lucasmoraeseng/STM3205P/README.md

# STM3205P
New controller for KORAD/HIkari 3205P power supply
