lucasmoraeseng/STM3205P/2.Hardware/STM3205P/PO/Gerber Single/STM3205P_GS_1.1_2026-04-08/STM3205P_PCB.xls

Board Stack Report
Stack Up |  | Layer Stack
Layer | Board Layer Stack | Name | Material | Thickness | Constant
1 |  | Top Paste
2 |  | Top Overlay
3 |  | Top Solder | SM-001 | 0,025mm | 4
4 |  | Top Layer | Copper | 0,035mm
5 |  | Dielectric 1 | PP-021 | 0,196mm | 4,74
6 |  | Int1 (GND) | Copper | 0,035mm
7 |  | Dielectric 3 | Core-039 | 1,030mm | 4,6
8 |  | Int2 (GND) | Copper | 0,035mm
9 |  | Dielectric 5 | PP-021 | 0,196mm | 4,74
10 |  | Bottom Layer | Copper | 0,035mm
11 |  | Bottom Solder | SM-001 | 0,025mm | 4
12 |  | Bottom Overlay
13 |  | Bottom Paste
 | Height : 1,613mm
