lucasmoraeseng/STM3205P/2.Hardware/STM3205P/PO/BOM/STM3205P_1.1_Main_2025-10-26.xlsx

Comment | Description | Designator | Footprint | LibRef | Quantity | Power | Pins | Tolerance | Value | Voltage | SEWPartNumber | PartNumber1 | Manufacturer1
CC0603 | Surface Mount Multilayer Ceramic Chip Capacitors for Commercial Applications | C1, C2, C3, C4, C5, C6, C7, C8, C9, C10, C11, C12, C13, C14, C15, C16, C17, C18, C19, C20, C21, C22, C23, C24, C25, C27, C28, C29, C30, C31, C32 | CAP0603 | CC0603 | 31 |  | 2 | 20% | 100nF, 10nF, 10uF | 50V, 100V |  | EMPTY | Yageo
25V 470uF | Electrolytic Capacitor PTH | CE1, CE3 | 5.0-10.0-12.5 | 25V 470uF | 2 |  | 2 | 20% | 470uF | 25V |  | UVK1E471MPD | Nichicon
16V 100uF | Electrolytic Capacitor PTH | CE2, CE4 | 2.0-5.0-11.0 | 16V 100uF | 2 |  | 2 | 20% | 100uF | 16V |  | UVZ1C101MDD | Nichicon
FM4007 | General Purpose Plastic Rectifier | D1, D2, D3, D4 | DO-214AC | FM4007 | 4 |  | 2 |  |  |  |  | FM4007 | Rectron
1N5408 | Rectifiers Diode, 1000V, 3A | D5 | DO-201AD | 1N5408 | 1 |  | 2 |  |  |  |  | 1N5408 | Diotec Semiconductor
BZV55-C5V1 | Zener Diodes 5.1V 0.5W | D6 | SOD-80C | BZV55-C5V1 | 1 | 0.5W | 2 |  | 5.1V |  |  | BZV55-C5V1 | Nexperia
MM4148 | General Purpose Plastic Rectifier | D7, D8 | SOD-80C | MM4148 | 2 |  | 2 |  |  |  |  | MM4148
B3B-XH-2 | XH Connector 3 POS HDR VERT 2.5mm | J1 | CONXH03STRMALE_2.5 | B3B-XH-2 | 1 |  | 3 |  |  |  |  | B3B-XH-2 | JST
B4B-XH-2 | XH Connector 4 POS HDR VERT 2.5mm | J2 | CONXH04STRMALE_2.5 | B4B-XH-2 | 1 |  | 4 |  |  |  |  | B4B-XH-2 | JST
90151-2110 | Headers & Wire Housings C-Grid PCB Conn Dual Row Vertical 10Ckt | J3 | CONDIL10STRFEMALE_100_100 | 90151-2110 | 1 |  | 10 |  |  |  |  | 90151-2110 | Molex
10-89-7121 | Headers & Wire Housings C-Grid PCB Conn SR V onn SR Vt Tn-A 12Ckt | J4 | CONDIL12STRMALE_100_100 | 10-89-7121 | 1 |  | 12 |  |  |  |  | 10-89-7121 | Molex
10-89-7062 | Headers & Wire Housings C-Grid PCB Conn SR V onn SR Vt Tn-A 8Ckt | J5 | CONDIL06STRMALE_100_100 | 10-89-7062 | 1 |  | 6 |  |  |  |  | 10-89-7062 | Molex
22-28-4043 | Headers & Wire Housings 04 MODII HDR SRST B/A .100CL | J6 | CONSIL04STRMALE_100_100 | 22-28-4043 | 1 |  | 4 |  |  |  |  | 22-28-4043 | Molex
B2B-XH-2 | XH Connector 2 POS HDR VERT 2.5mm | J7, J11 | CONXH02STRMALE_2.5 | B2B-XH-2 | 2 |  | 2 |  |  |  |  | B2B-XH-2 | JST
1-1123723-2 | Header Vert 3.96mm 2Pos | J8, J9 | CONKK02STRMALE_156 | 1-1123723-2 | 2 |  | 2 |  |  |  |  | 1-1123723-2 | TE Connectivity
B7B-XH-2 | XH Connector 7 POS HDR VERT 2.5mm | J10 | CONXH07STRMALE_2.5 | B7B-XH-2 | 1 |  | 7 |  |  |  |  | B7B-XH-2 | JST
BLM18 | Ferrite Beads 0603 | L1, L2, L3 | IND0603 | BLM18 | 3 |  | 2 | 25% | 220 Ohm |  |  | BLM18PG(VVV)SN1D | Murata Electronics
BC846B | Transistor BJT NPN 65V 0.1A 150mW | Q1, Q2 | SOT-23 | BC846B | 2 | 150mW | 3 |  |  |  |  | BC846BLT3G | onsemi
Chip Resistor | Thick Film Chip Resistors with CECC Approval, available with Established Reliability | R1, R2, R3, R4, R5, R6, R7, R8, R9, R10, R11, R12, R13, R14, R16, R17, R18, R19, R20, R21, R22, R23, R24, R25, R26, R27, R28, R29, R30 | RES0603 | CRCW0603 | 29 | 0.1W | 2 | 5% | 10k, 100k, 1M, 4.3k, 2k, 4.7k, 100R, 20k |  |  | CRCW0603(RRRR)(T)(C)(PP)(SS) | Vishay
Chip Resistor | Thick Film Chip Resistors with CECC Approval, available with Established Reliability | R15 | RESSHUNT | RESSHUNT | 1 | 5W | 2 | 5% | 0.1R
L7812CV | Positive voltage regulator ICs | U1 | TO-220A | L7812CV | 1 |  | 3 |  |  | 12V |  | L7812CV | STMicroelectronics
L79L12ACZ-TR | Negative voltage regulator ICs | U2 | TO-92A_2.5 | L79L12ACZ-TR | 1 |  | 3 |  |  | -12V |  | L79L12ACZ-TR | STMicroelectronics
L7805CV | Positive voltage regulator ICs | U3 | TO-220A | L7805CV | 1 |  | 3 |  |  | 5V |  | L7805CV | STMicroelectronics
LD1117S33TR | Positive voltage regulator ICs | U4 | SOT-223 | LD1117S33TR | 1 |  | 4 |  |  | 3.3V |  | LD1117S33TR | STMicroelectronics
STM32F103C8T6 | 32-bit Microcontrollers - ARM Cortex-M0+ 32kB Flash, 6kB RAM | U5 | LQFP-48 | STM32F103C8T6 | 1 |  | 48 |  |  |  |  | STM32F103C8T6 | STMicroelectronics
DAC8830ICD | DAC Lo-Pwr R-To-R Output 16-Bit Serial Input | U6, U7 | SOIC-08-3.9mm | DAC8830ICD | 2 |  | 8 |  |  |  |  | DAC8830IBD | Texas Instruments
TL084HIDR | Quad Operational Amplifiers RRIO | U8 | SOIC-14-3.9mm | TL084HIDR | 1 |  | 14 |  |  |  |  | TL084HIDR | Texas Instruments
ULN2003ADR | Darlington Transistors Arrays NPN 7-Ch | U10 | SOIC-16-3.9mm | ULN2003ADR | 1 |  | 16 |  |  |  |  | ULN2003ADR | Texas Instruments
FA-238A | Crystals FA-238A XTAL MHZ -40 125C 7.0PF 250TR | X1 | CR3225 | FA-238A | 1 |  | 4 | 20 ppm | 16 MHz |  |  | FA-238A | Epson Timing
CEM-1203(42) | 12 mm, 3.5 Vo-p, 95 dB, Through Hole, Magnetic Audio Transducer Buzzer | X2 | CEM-1203 | CEM-1203(42) | 1 |  | 2 |  | 3.5V |  |  | CEM-1203(42) | Same Sky
