lucasmoraeseng/STM3205P/2.Hardware/STM3205P/PO/3DFile/STM3205P_3D_1.1_2025-10-26/STM3205P_PCB(Main).step

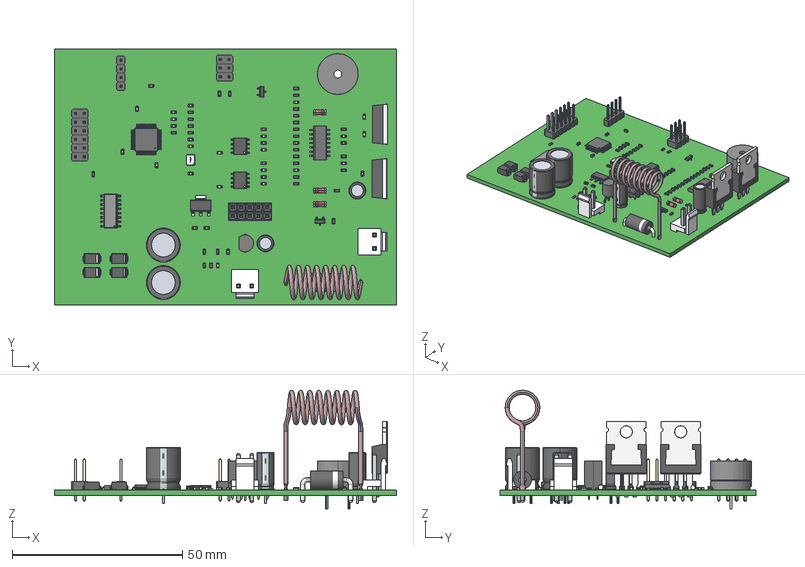
[picture p1: CAD file, 2025-10-26]
2.Hardware/STM3205P/PO/3DFile/STM3205P_3D_1.1_2025-10-26/STM3205P_PCB(Main).step
100.5 x 75.3 x 34.8 mm
C0603 x 31
Same_Sky_CEM-1203_42_
ATX-11
SO16_Narrow_3.9mm x 17
SOIC14_3.9
SO8N x 2
LQFP48
SOT233
TO-220_3pins_short_V1 x 2
TO-92_line_pin_2_5mm_pitch
RES0603 x 29
ResistorCoil
SOT23 x 2
Pin1 x 3
Pin2 x 3
CeramicBody x 3
Base_2 x 2
PinH x 4
PinL x 4
SingleBlockL x 4
DownPinL x 22
UpPinL x 22
DualBlockL x 9
ConnHS2_54_STR_Body_Standard x 10
ConnHS2_54_STR_Terminal x 10
DO-201AD
Diode_SMA x 4
Cap_2.0_5.0_11.0 x 2
Cap_5.0_10.0_12.5 x 2
