lucasmoraeseng/STM3205P/5.Mecanico/Resistor/ResistorCoil.STEP

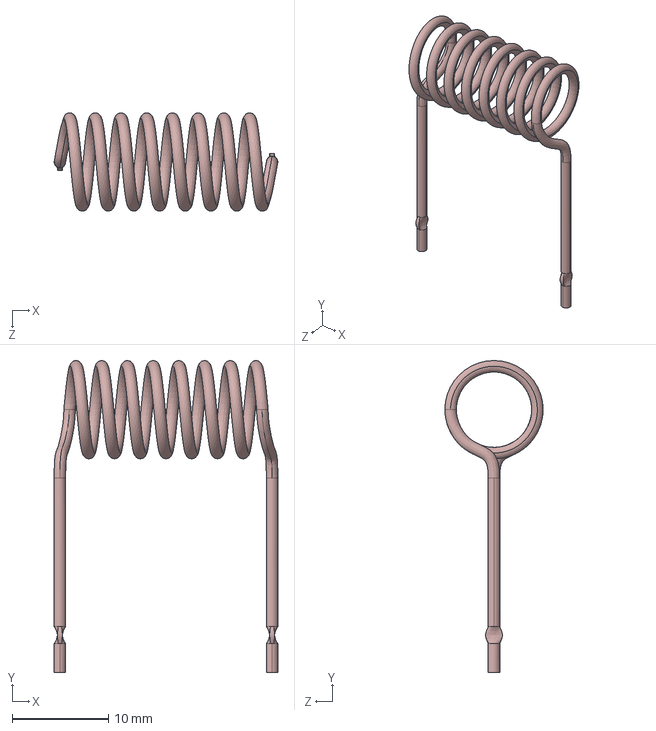
[picture p2: CAD file, 2025-08-31]
5.Mecanico/Resistor/ResistorCoil.STEP
23.2 x 32.3 x 10.2 mm
