lucasmoraeseng/STM3205P/(list of files, cad)

Other CAD files:
2.Hardware/STM3205P/PO/3DFile/STM3205P_3D_1.1_2025-10-26/STM3205P_PCB(Main).x_t
5.Mecanico/Resistor/ResistorCoil.SLDPRT
