lucasmoraeseng/STM3205P/2.Hardware/STM3205P/PO/SCH/STM3205P_SCH_1.1_Main_2025-10-26.PDF

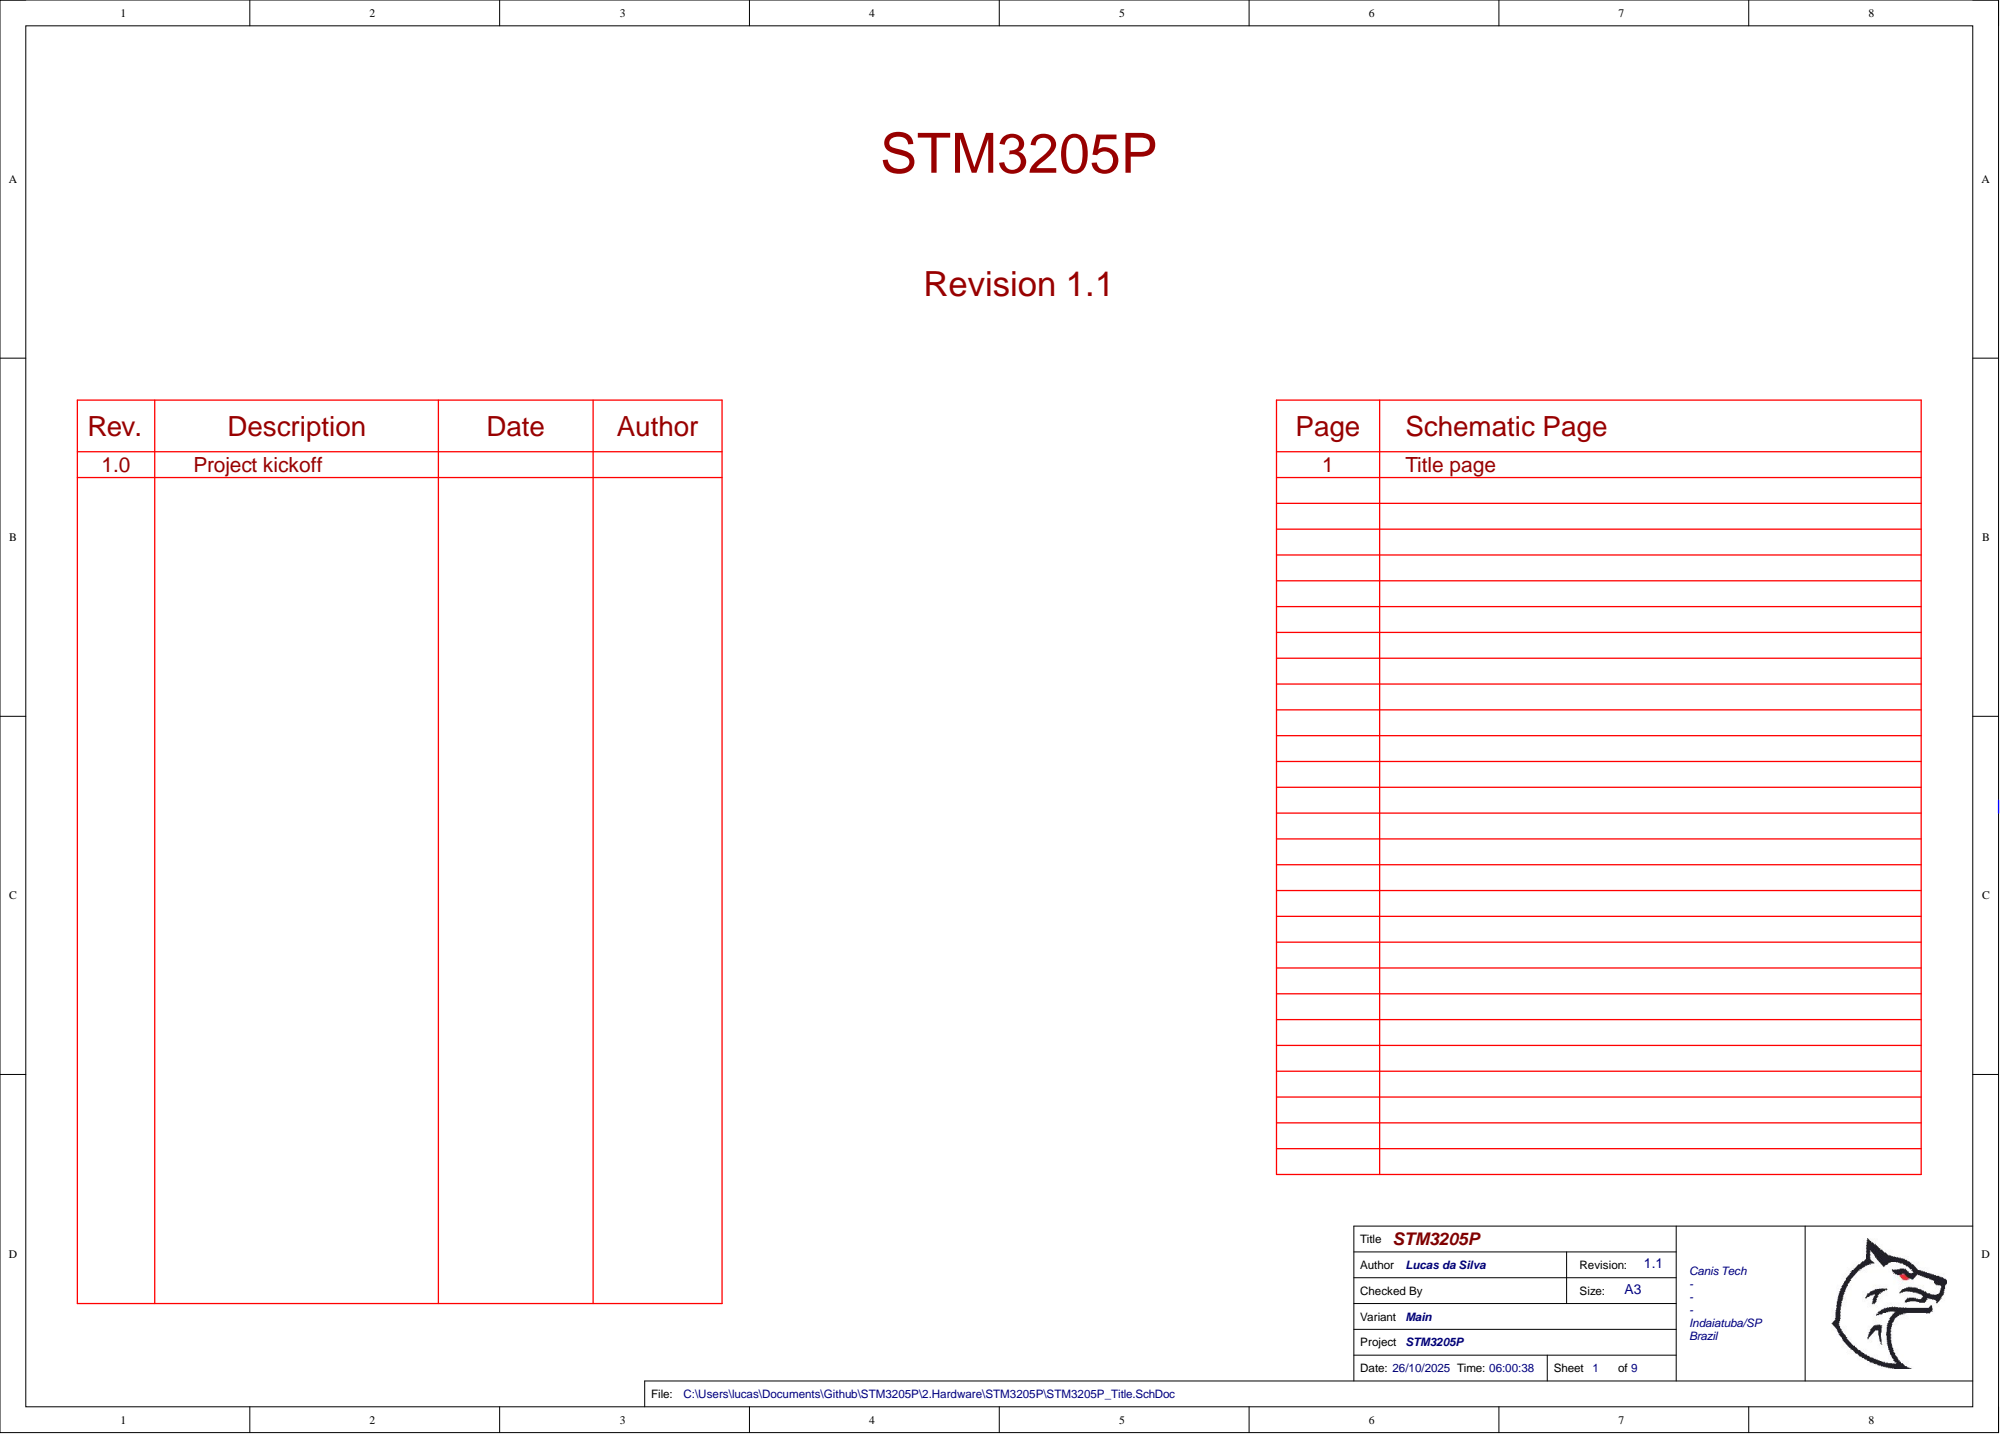
[picture p3: page 1]

Author Lucas da Silva | Revision: 1.1

Checked By | A3 Size:

File: C:\Users\lucas\Documents\Github\STM3205P\2.Hardware\STM3205P\STM3205P_Title.SchDoc

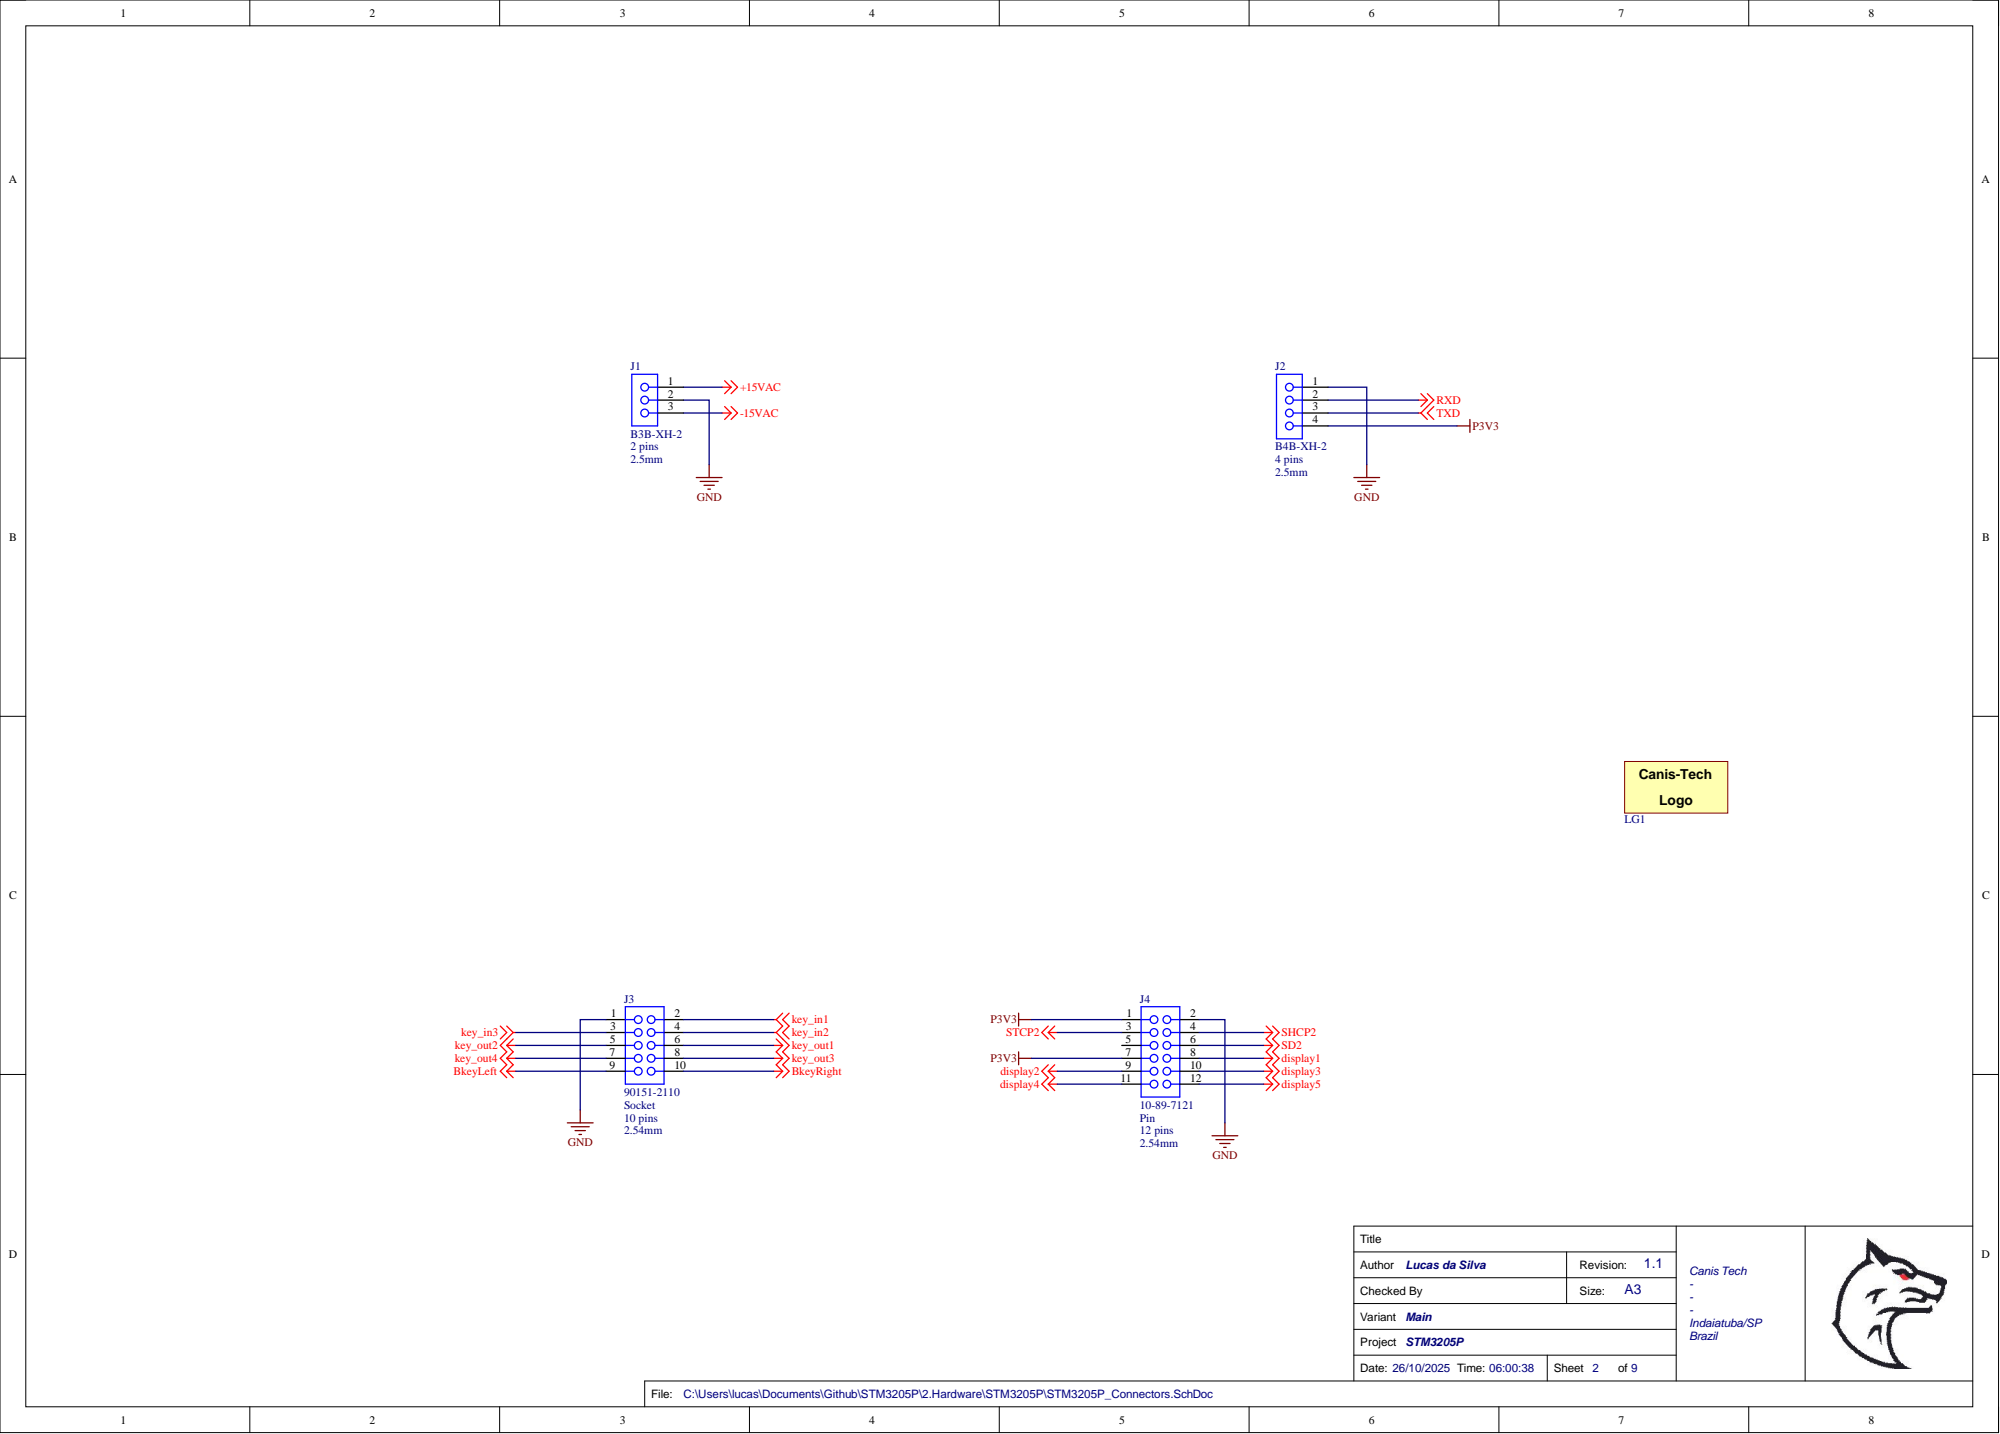
[picture p4: page 2]

Author Lucas da Silva | Revision: 1.1

Checked By | A3 Size:

File: C:\Users\lucas\Documents\Github\STM3205P\2.Hardware\STM3205P\STM3205P_Connectors.SchDoc

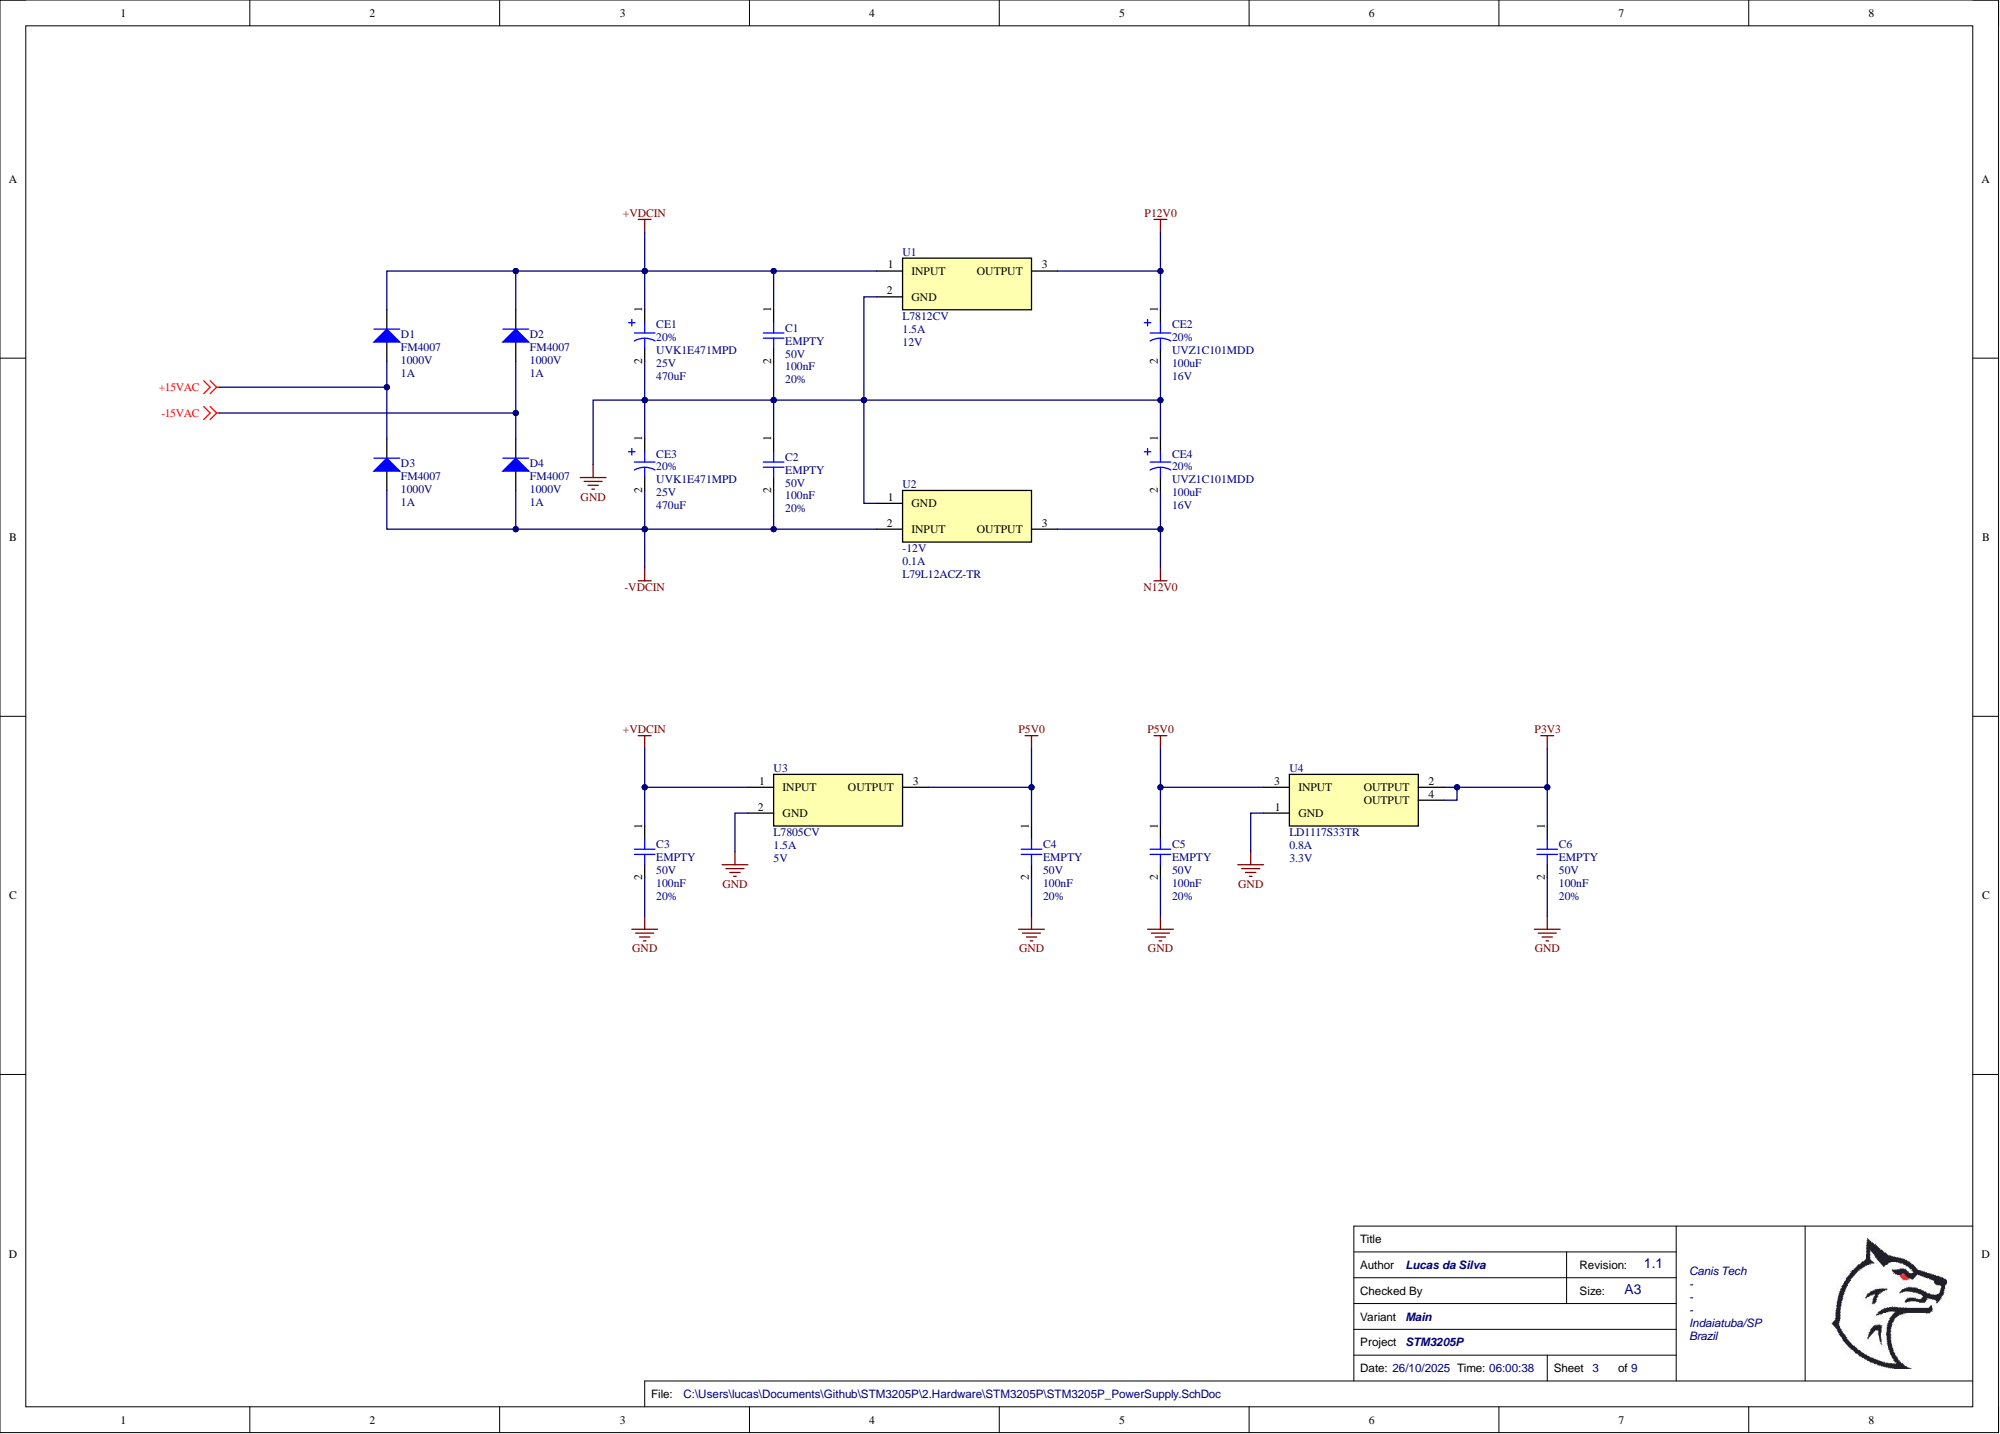
[picture p5: page 3]

Author Lucas da Silva | Revision: 1.1

Checked By | A3 Size:

File: C:\Users\lucas\Documents\Github\STM3205P\2.Hardware\STM3205P\STM3205P_PowerSupply.SchDoc

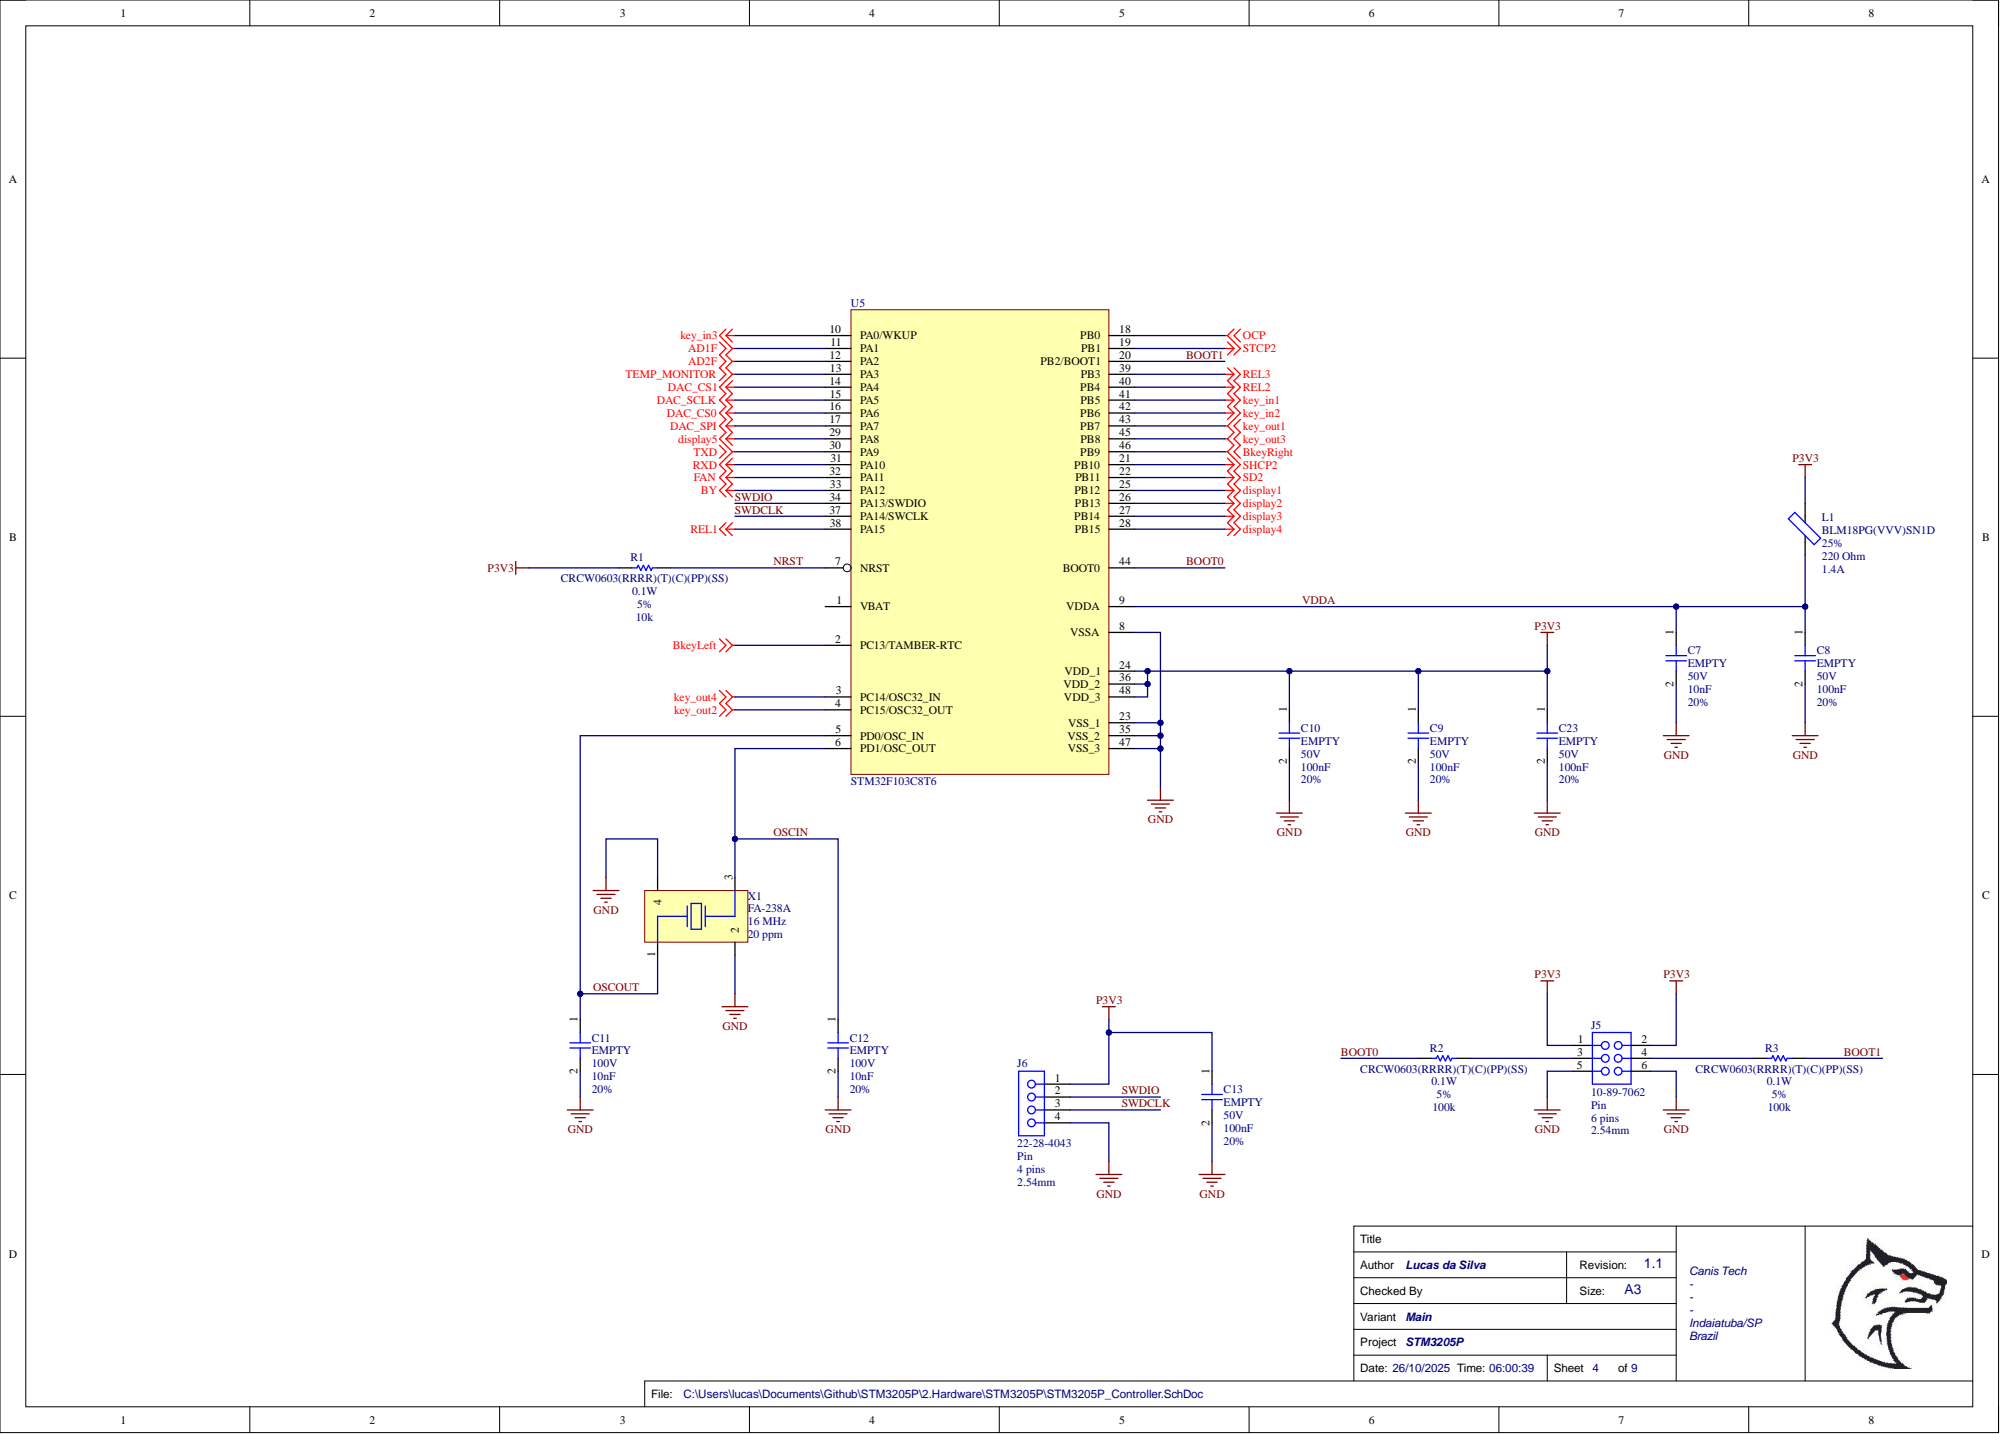
[picture p6: page 4]

Author Lucas da Silva | Revision: 1.1

Checked By | A3 Size:

File: C:\Users\lucas\Documents\Github\STM3205P\2.Hardware\STM3205P\STM3205P_Controller.SchDoc

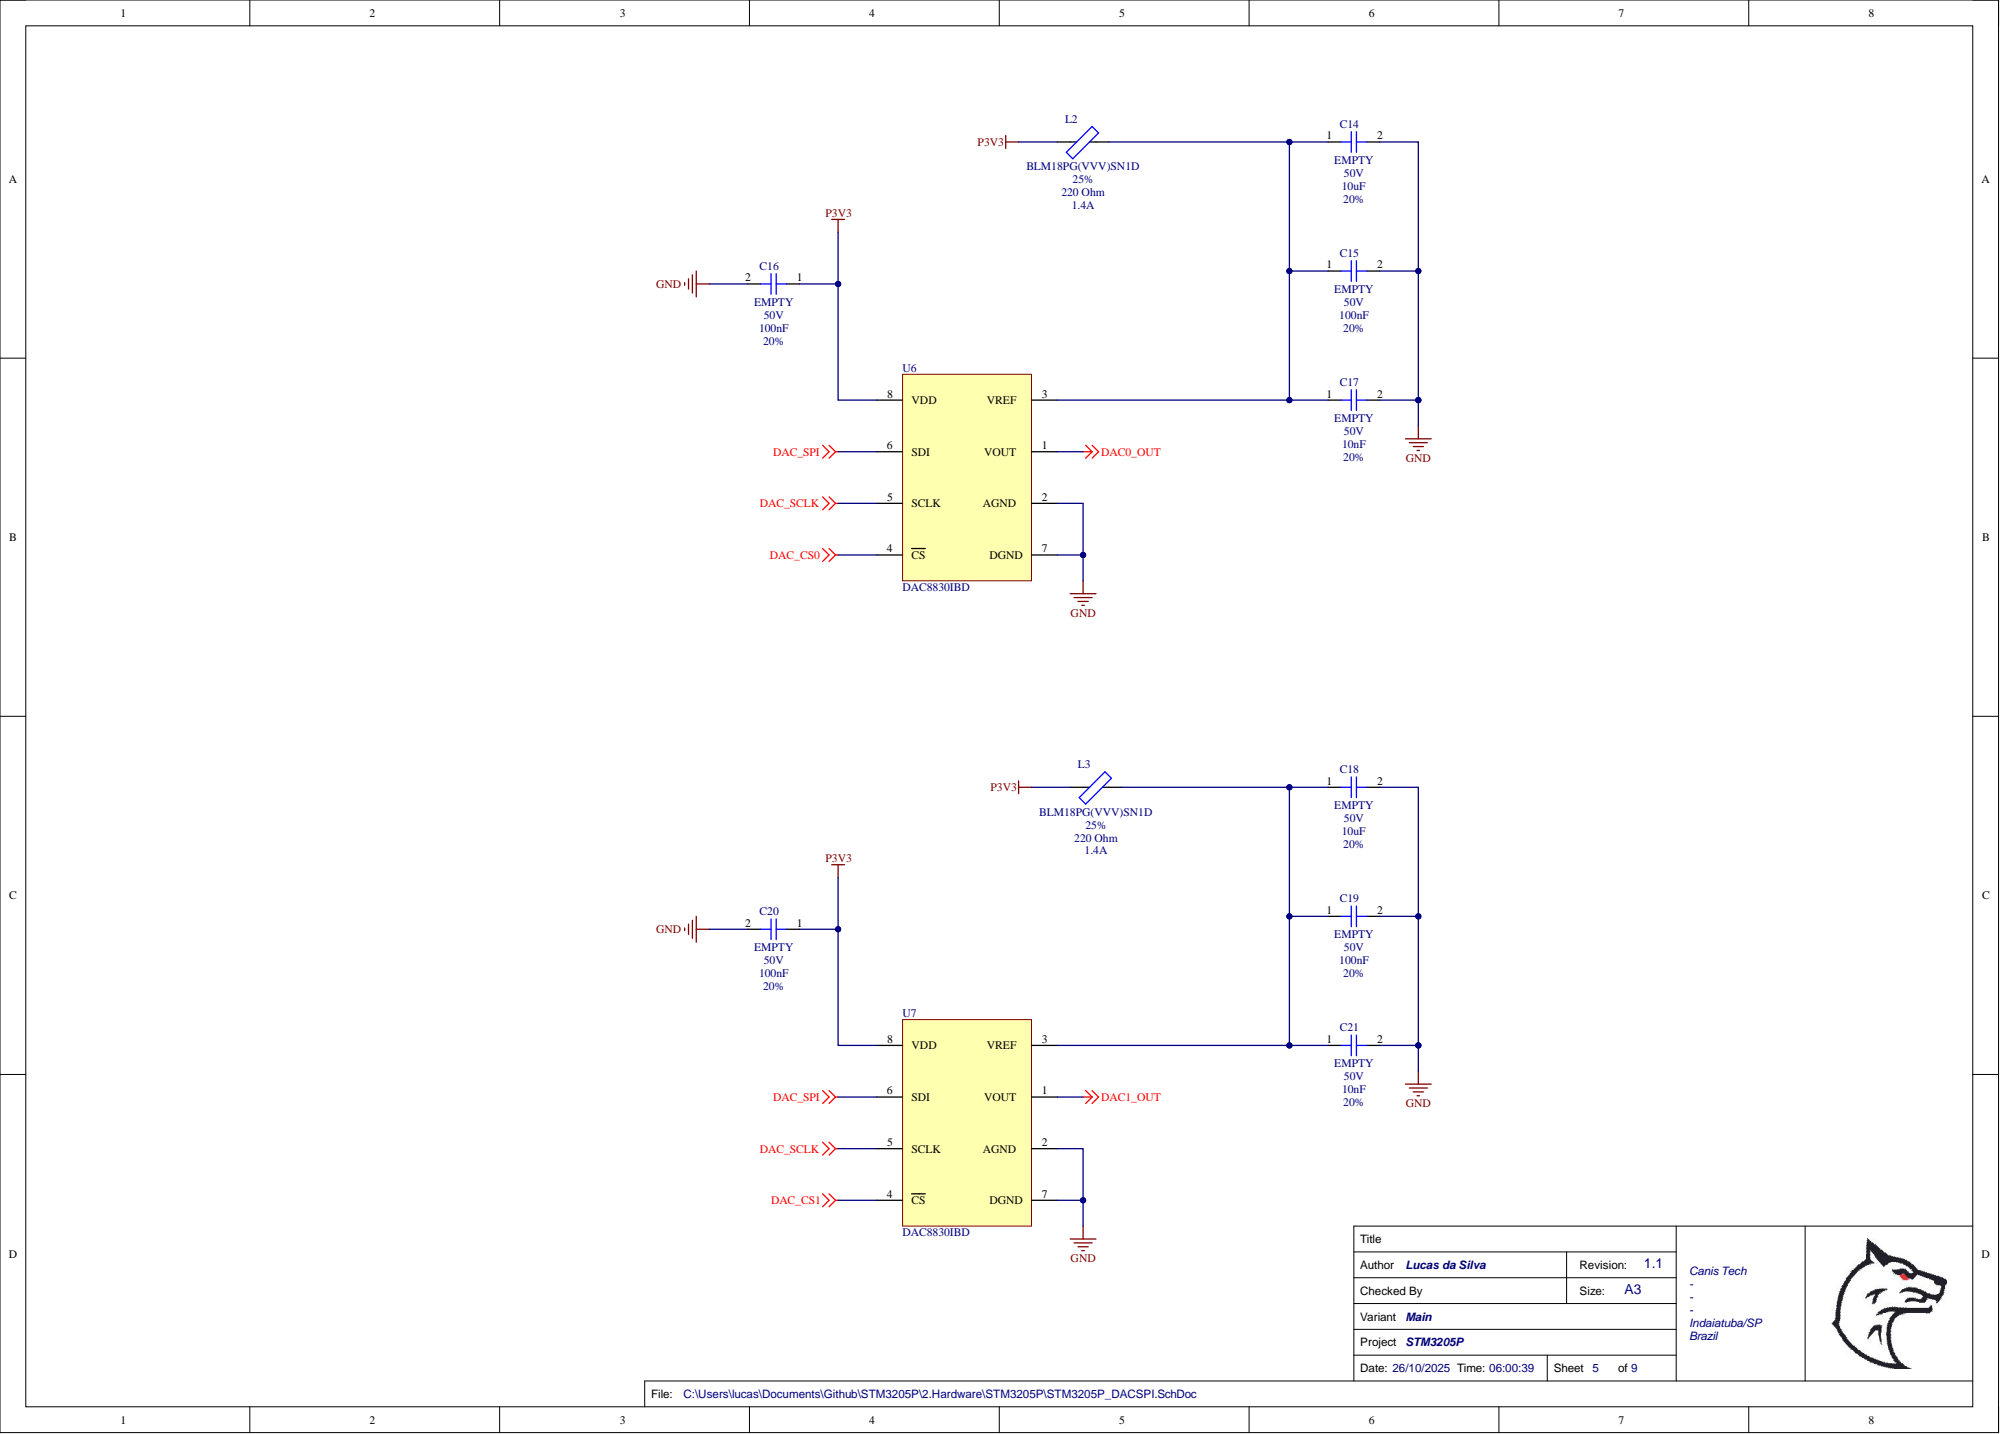
[picture p7: page 5]

Author Lucas da Silva | Revision: 1.1

Checked By | A3 Size:

File: C:\Users\lucas\Documents\Github\STM3205P\2.Hardware\STM3205P\STM3205P_DACSPI.SchDoc

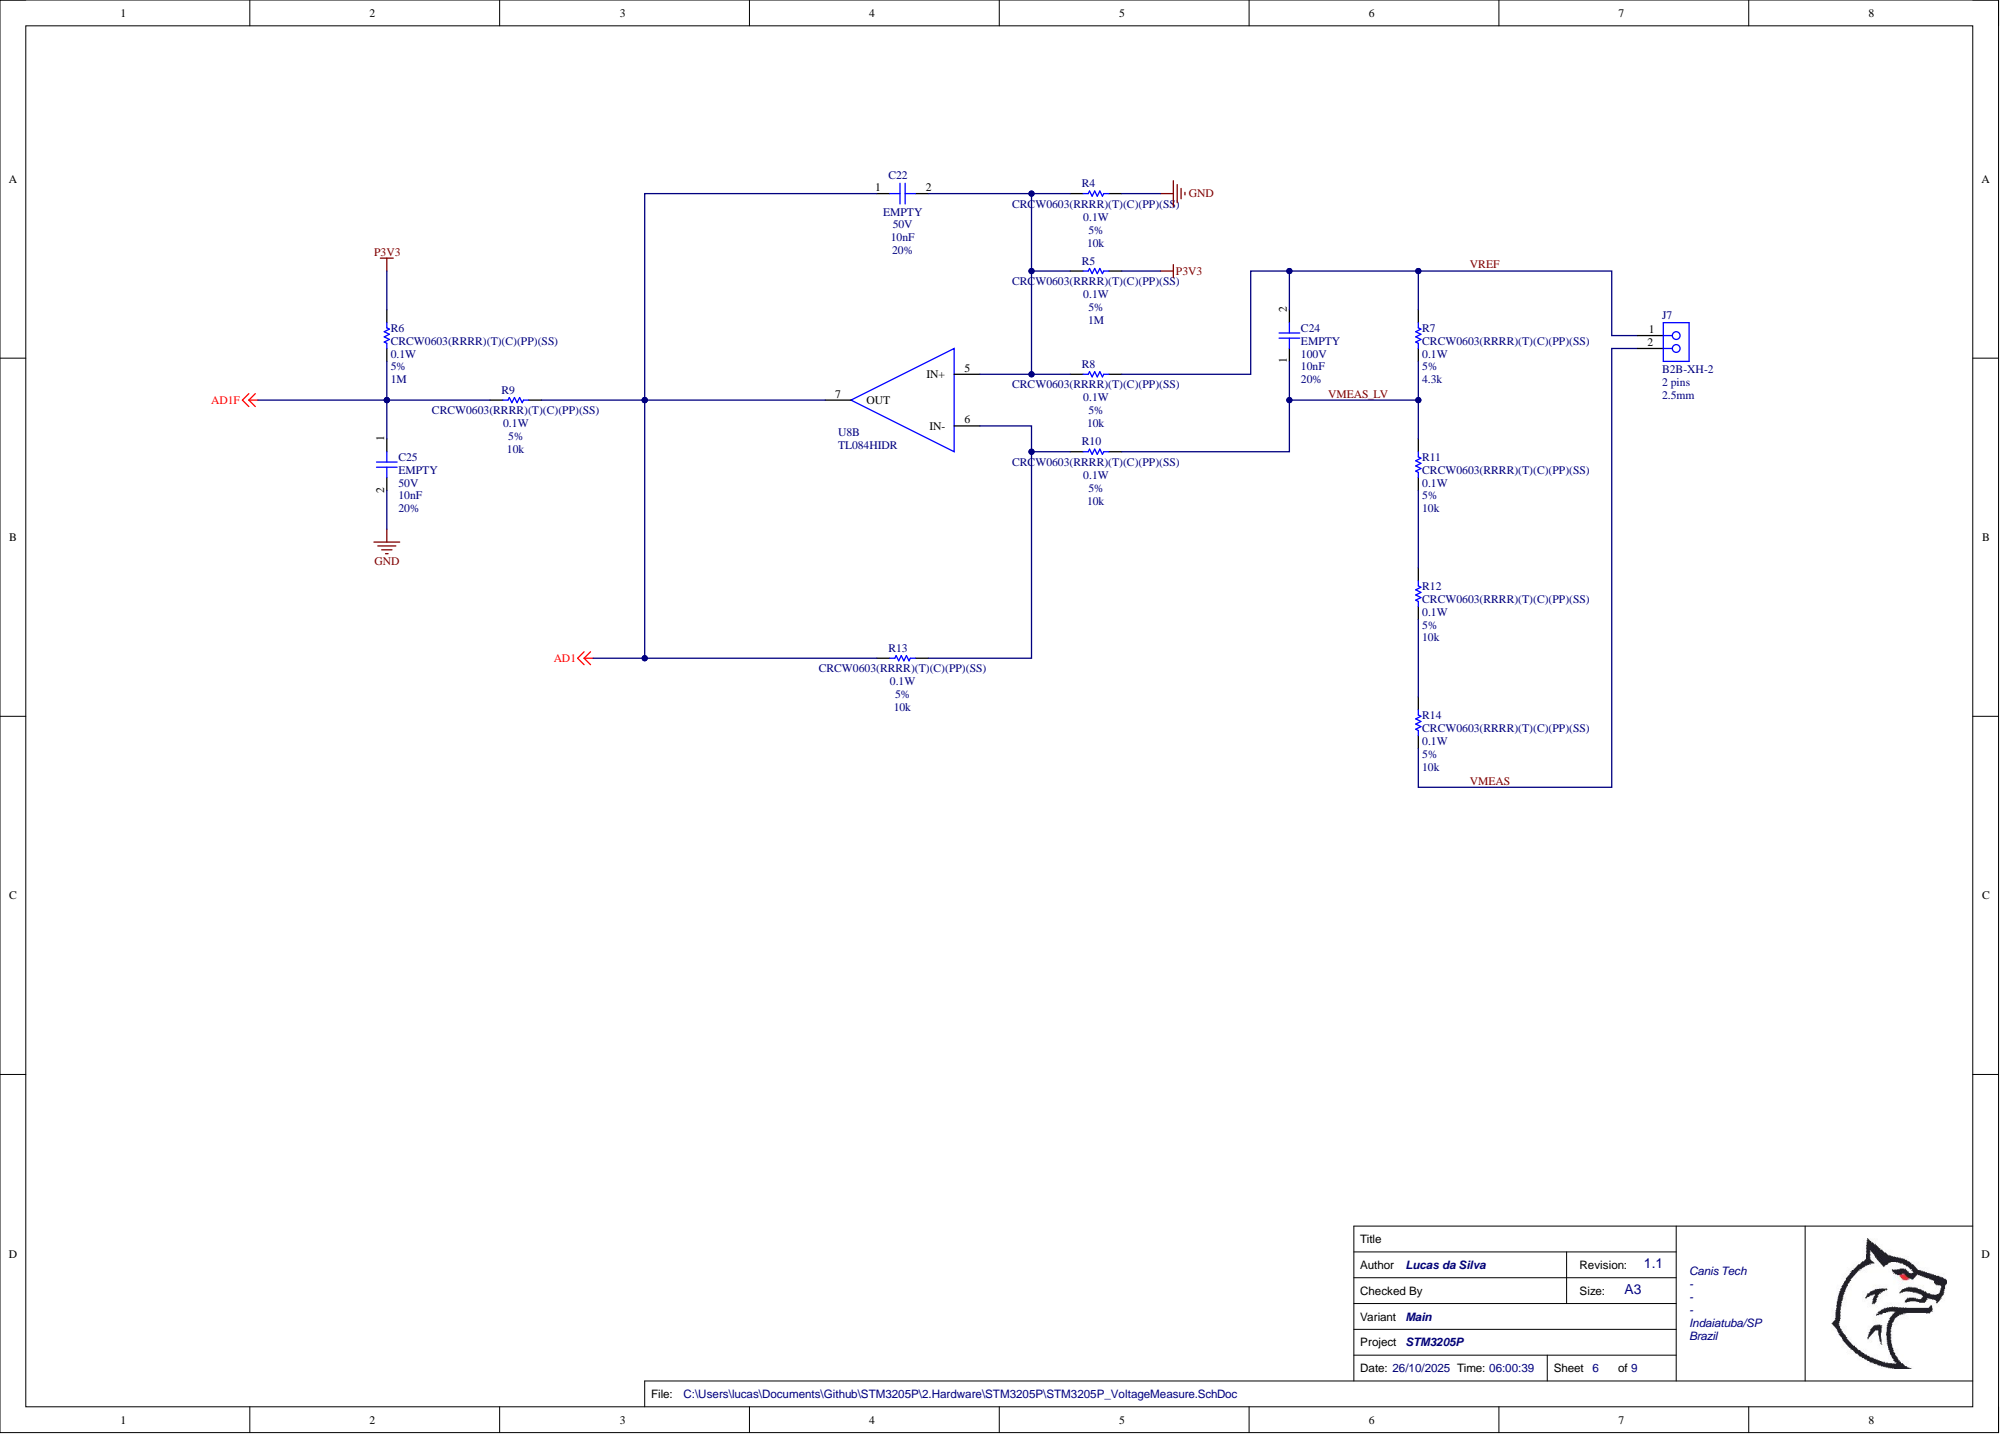
[picture p8: page 6]

Author Lucas da Silva | Revision: 1.1

Checked By | A3 Size:

File: C:\Users\lucas\Documents\Github\STM3205P\2.Hardware\STM3205P\STM3205P_VoltageMeasure.SchDoc

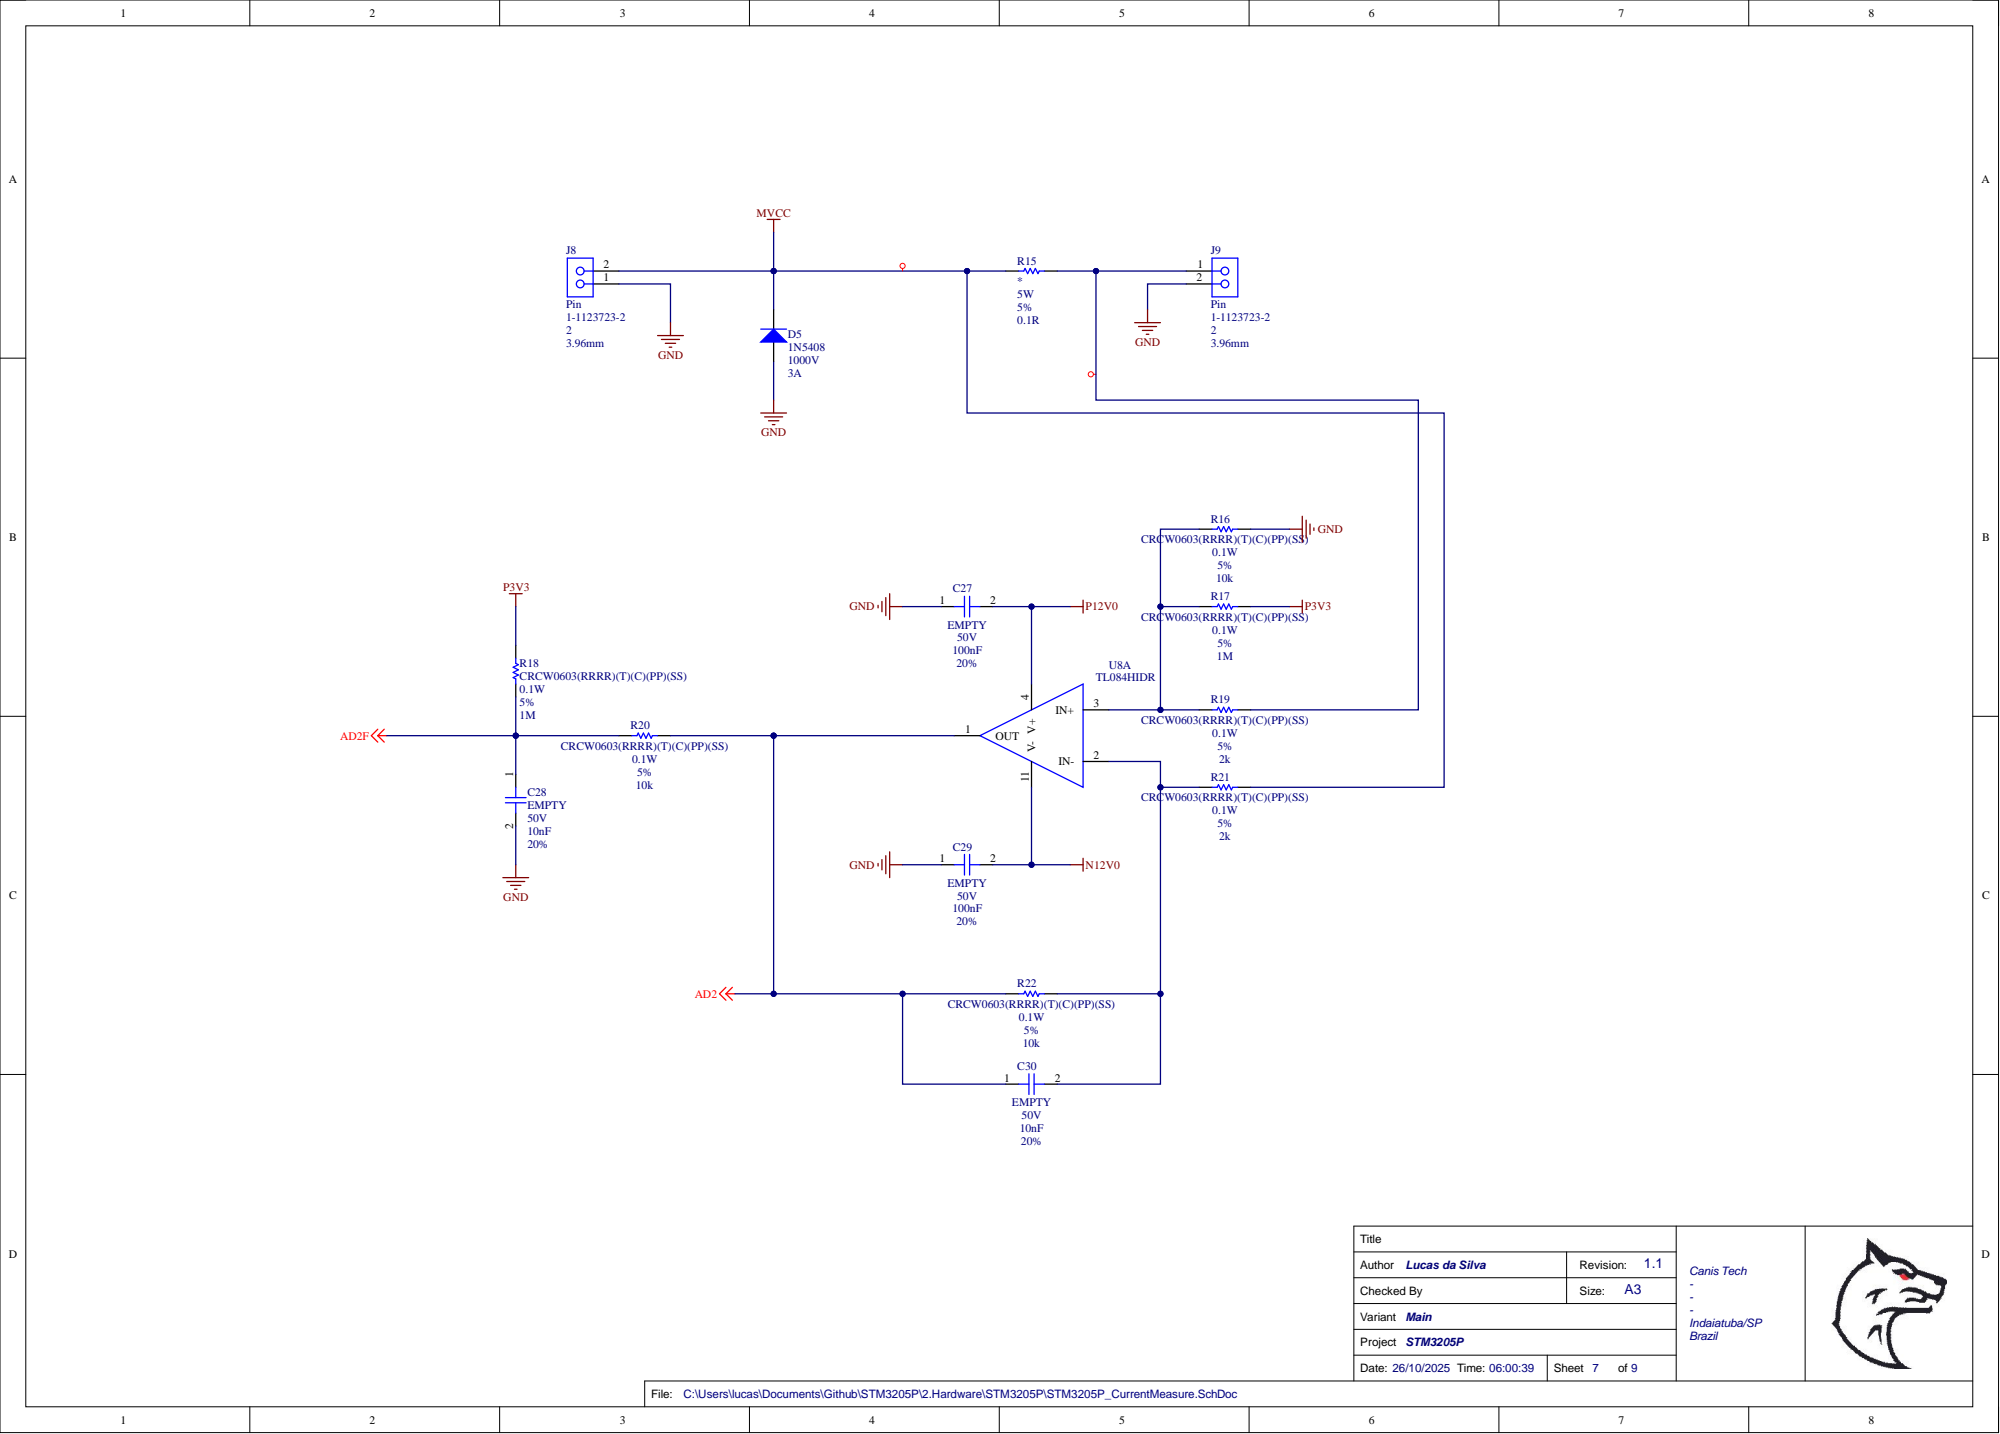
[picture p9: page 7]

Author Lucas da Silva | Revision: 1.1

Checked By | A3 Size:

File: C:\Users\lucas\Documents\Github\STM3205P\2.Hardware\STM3205P\STM3205P_CurrentMeasure.SchDoc

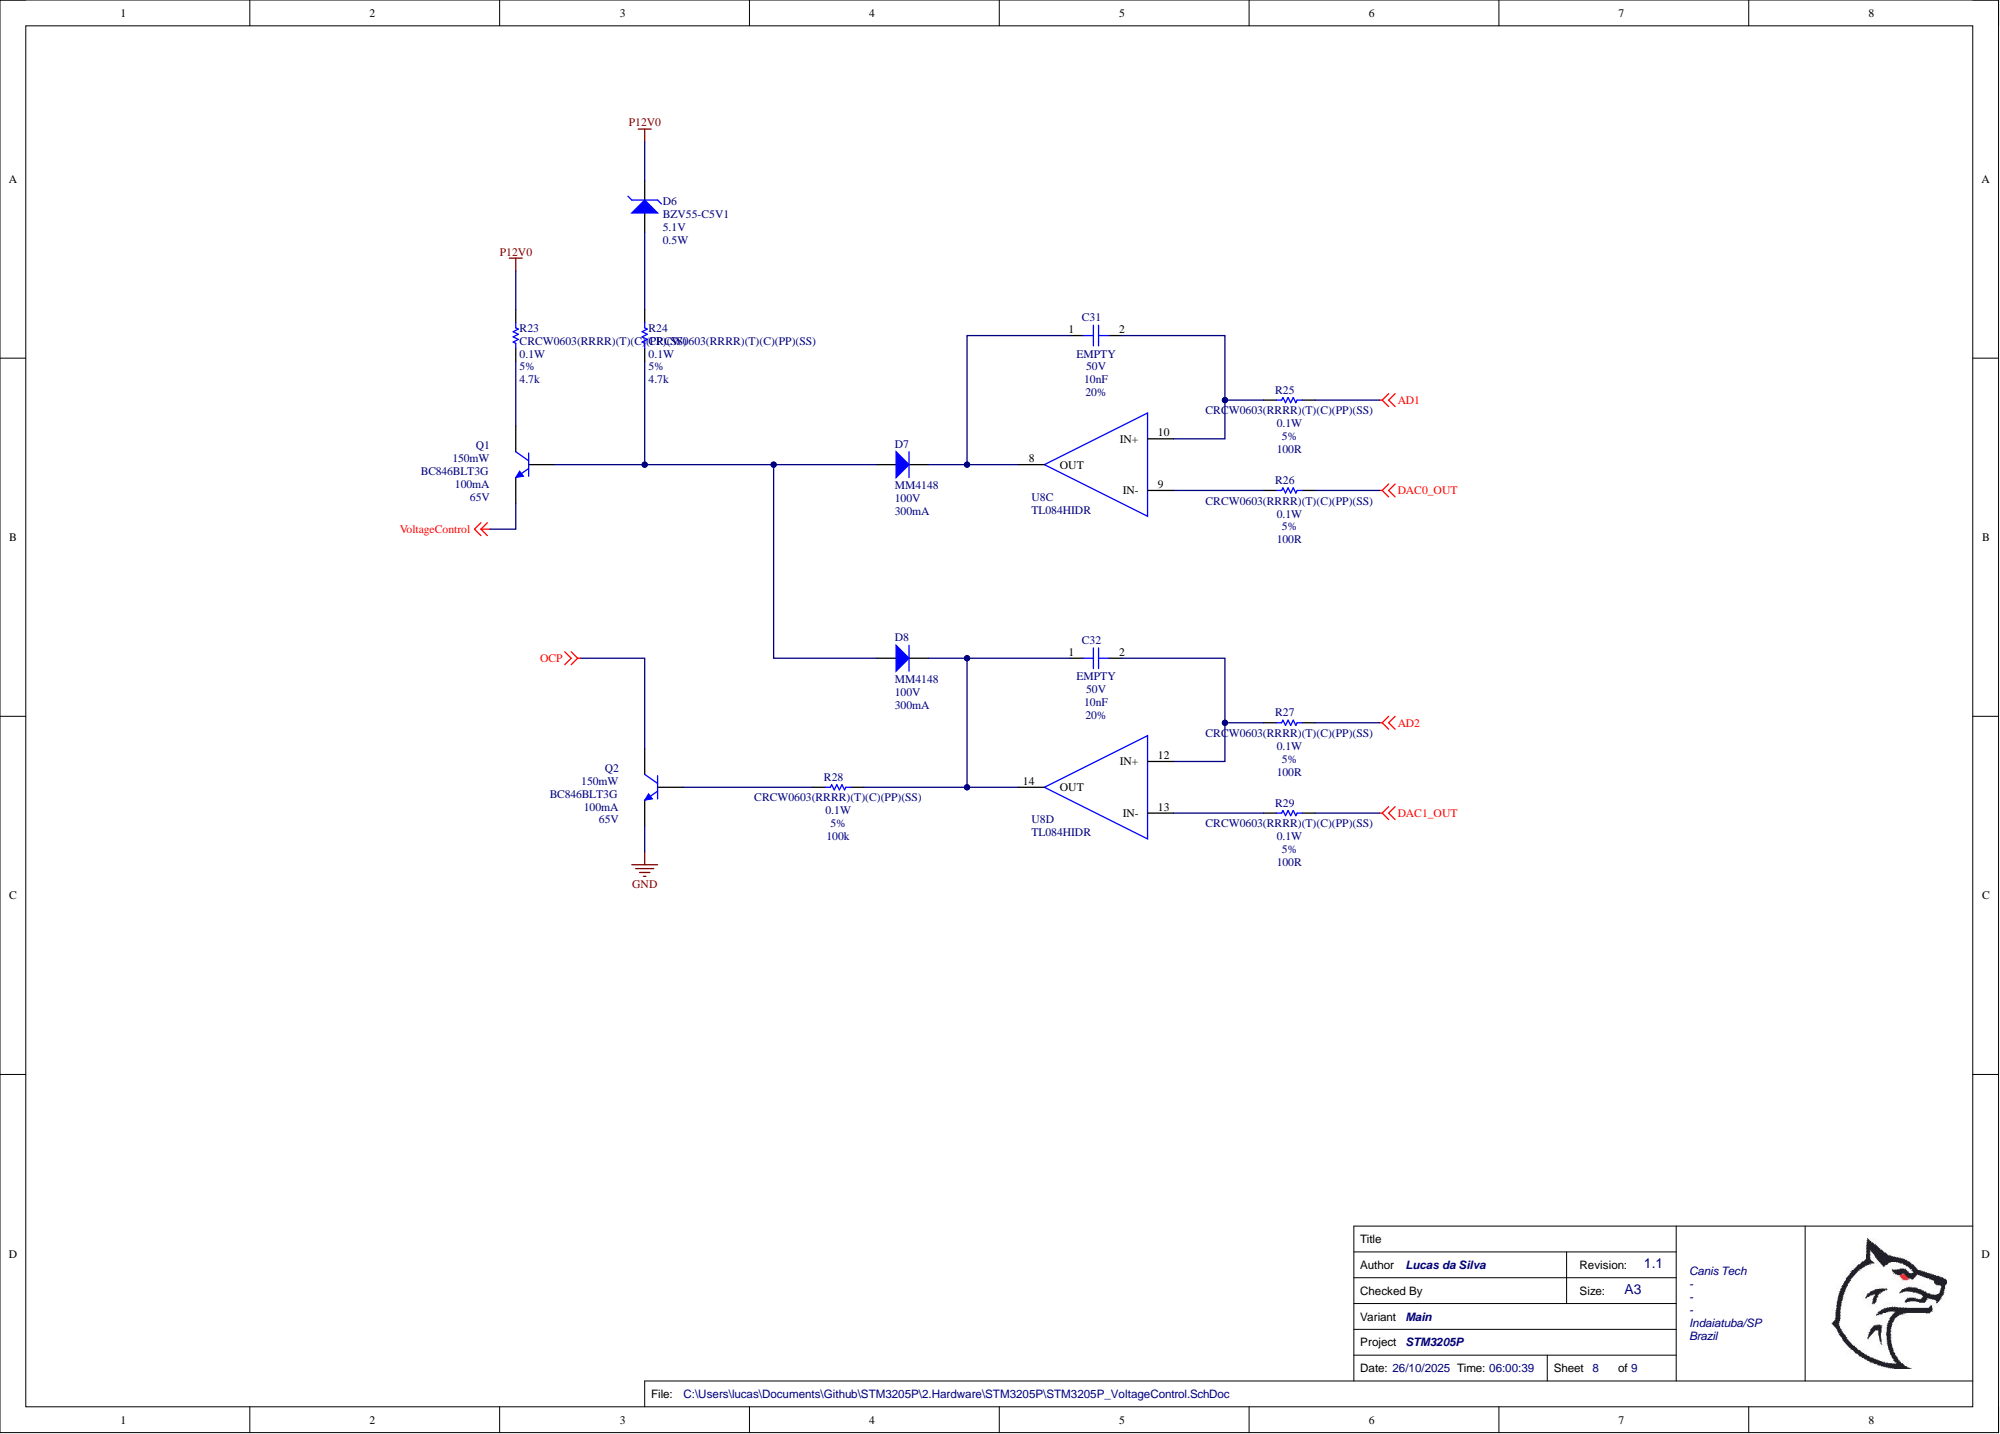
[picture p10: page 8]

Author Lucas da Silva | Revision: 1.1

Checked By | A3 Size:

File: C:\Users\lucas\Documents\Github\STM3205P\2.Hardware\STM3205P\STM3205P_VoltageControl.SchDoc

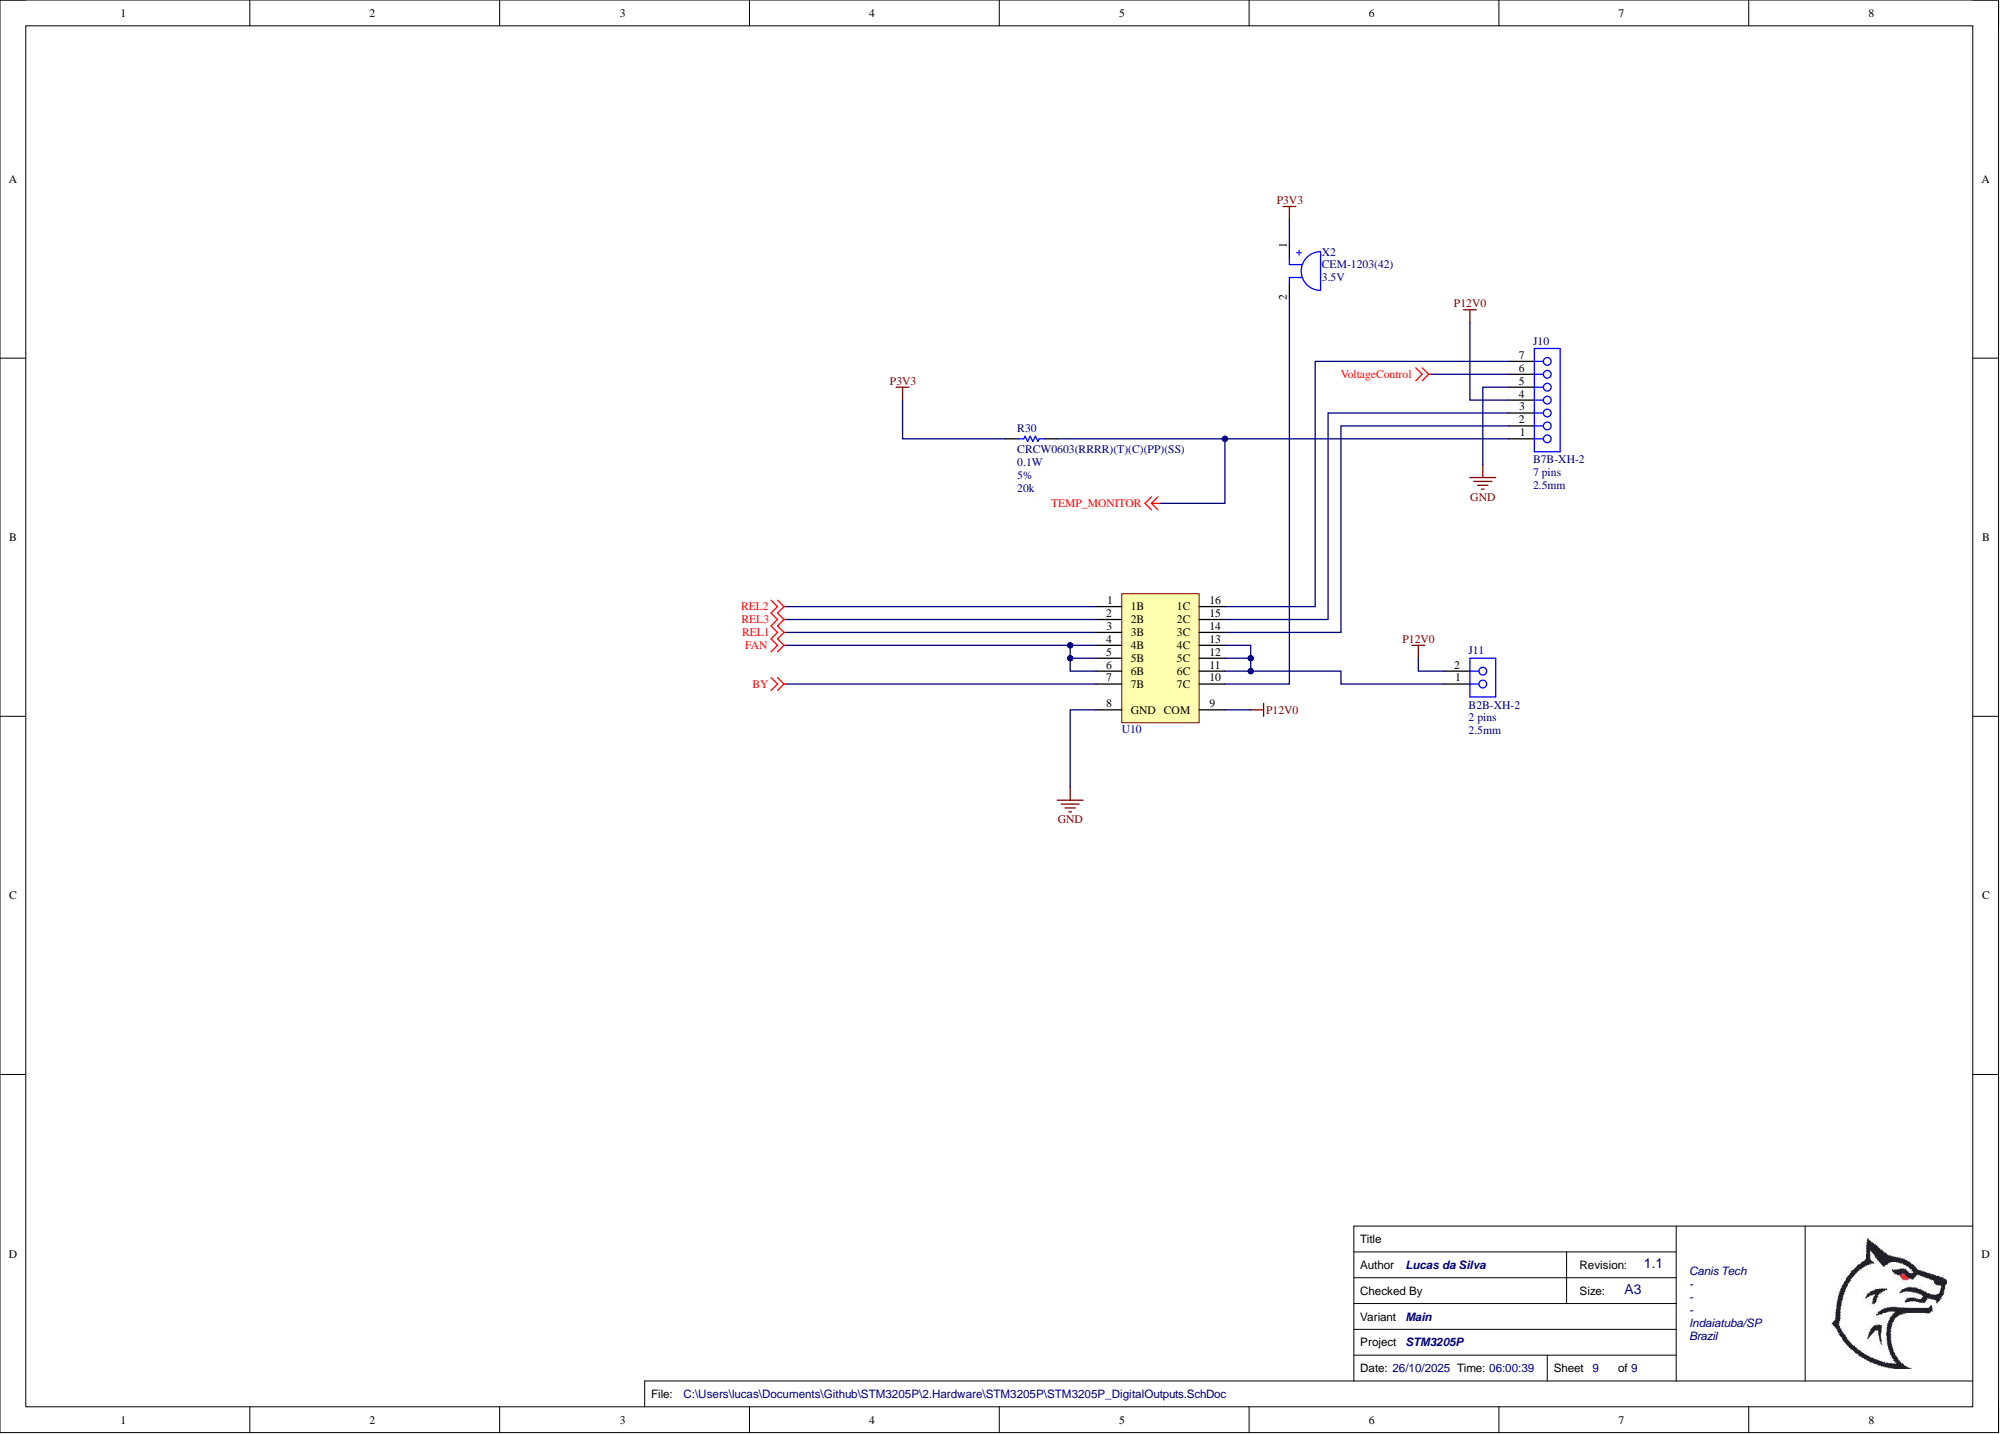
[picture p11: page 9]

Author Lucas da Silva | Revision: 1.1

Checked By | A3 Size:

File: C:\Users\lucas\Documents\Github\STM3205P\2.Hardware\STM3205P\STM3205P_DigitalOutputs.SchDoc
