lucasmoraeseng/STM3205P/2.Hardware/STM3205P/PO/SCH/STM3205P_SCH_1.0_Main_2025-08-31.PDF

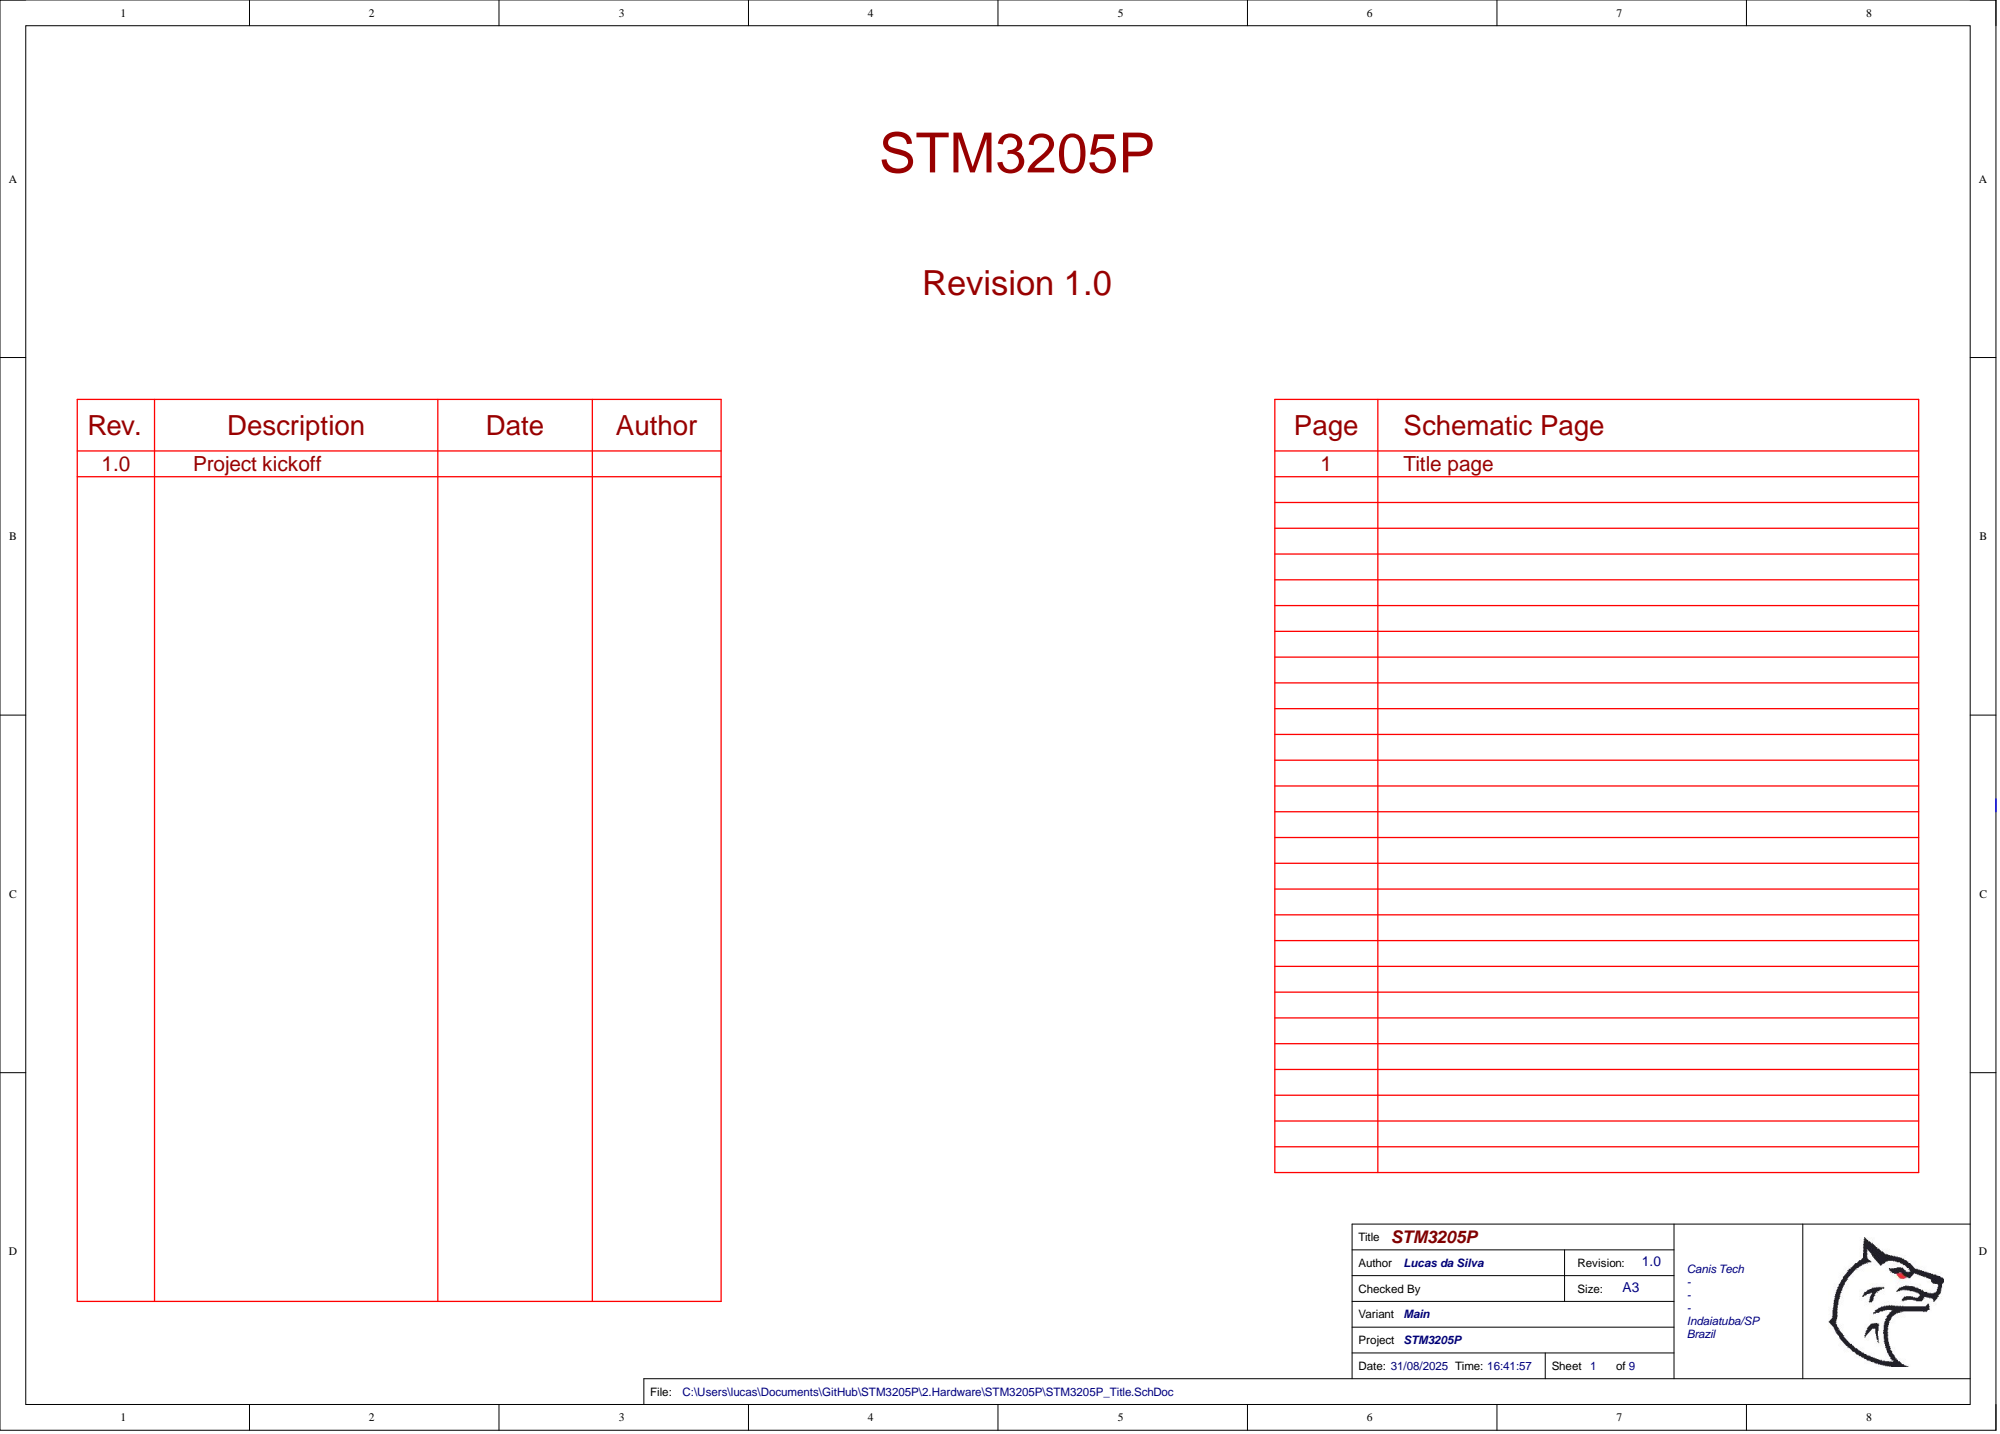
[picture p12: page 1]

Author Lucas da Silva | 1.0 Revision:

Checked By | Size: A3

File: C:\Users\lucas\Documents\GitHub\STM3205P\2.Hardware\STM3205P\STM3205P_Title.SchDoc

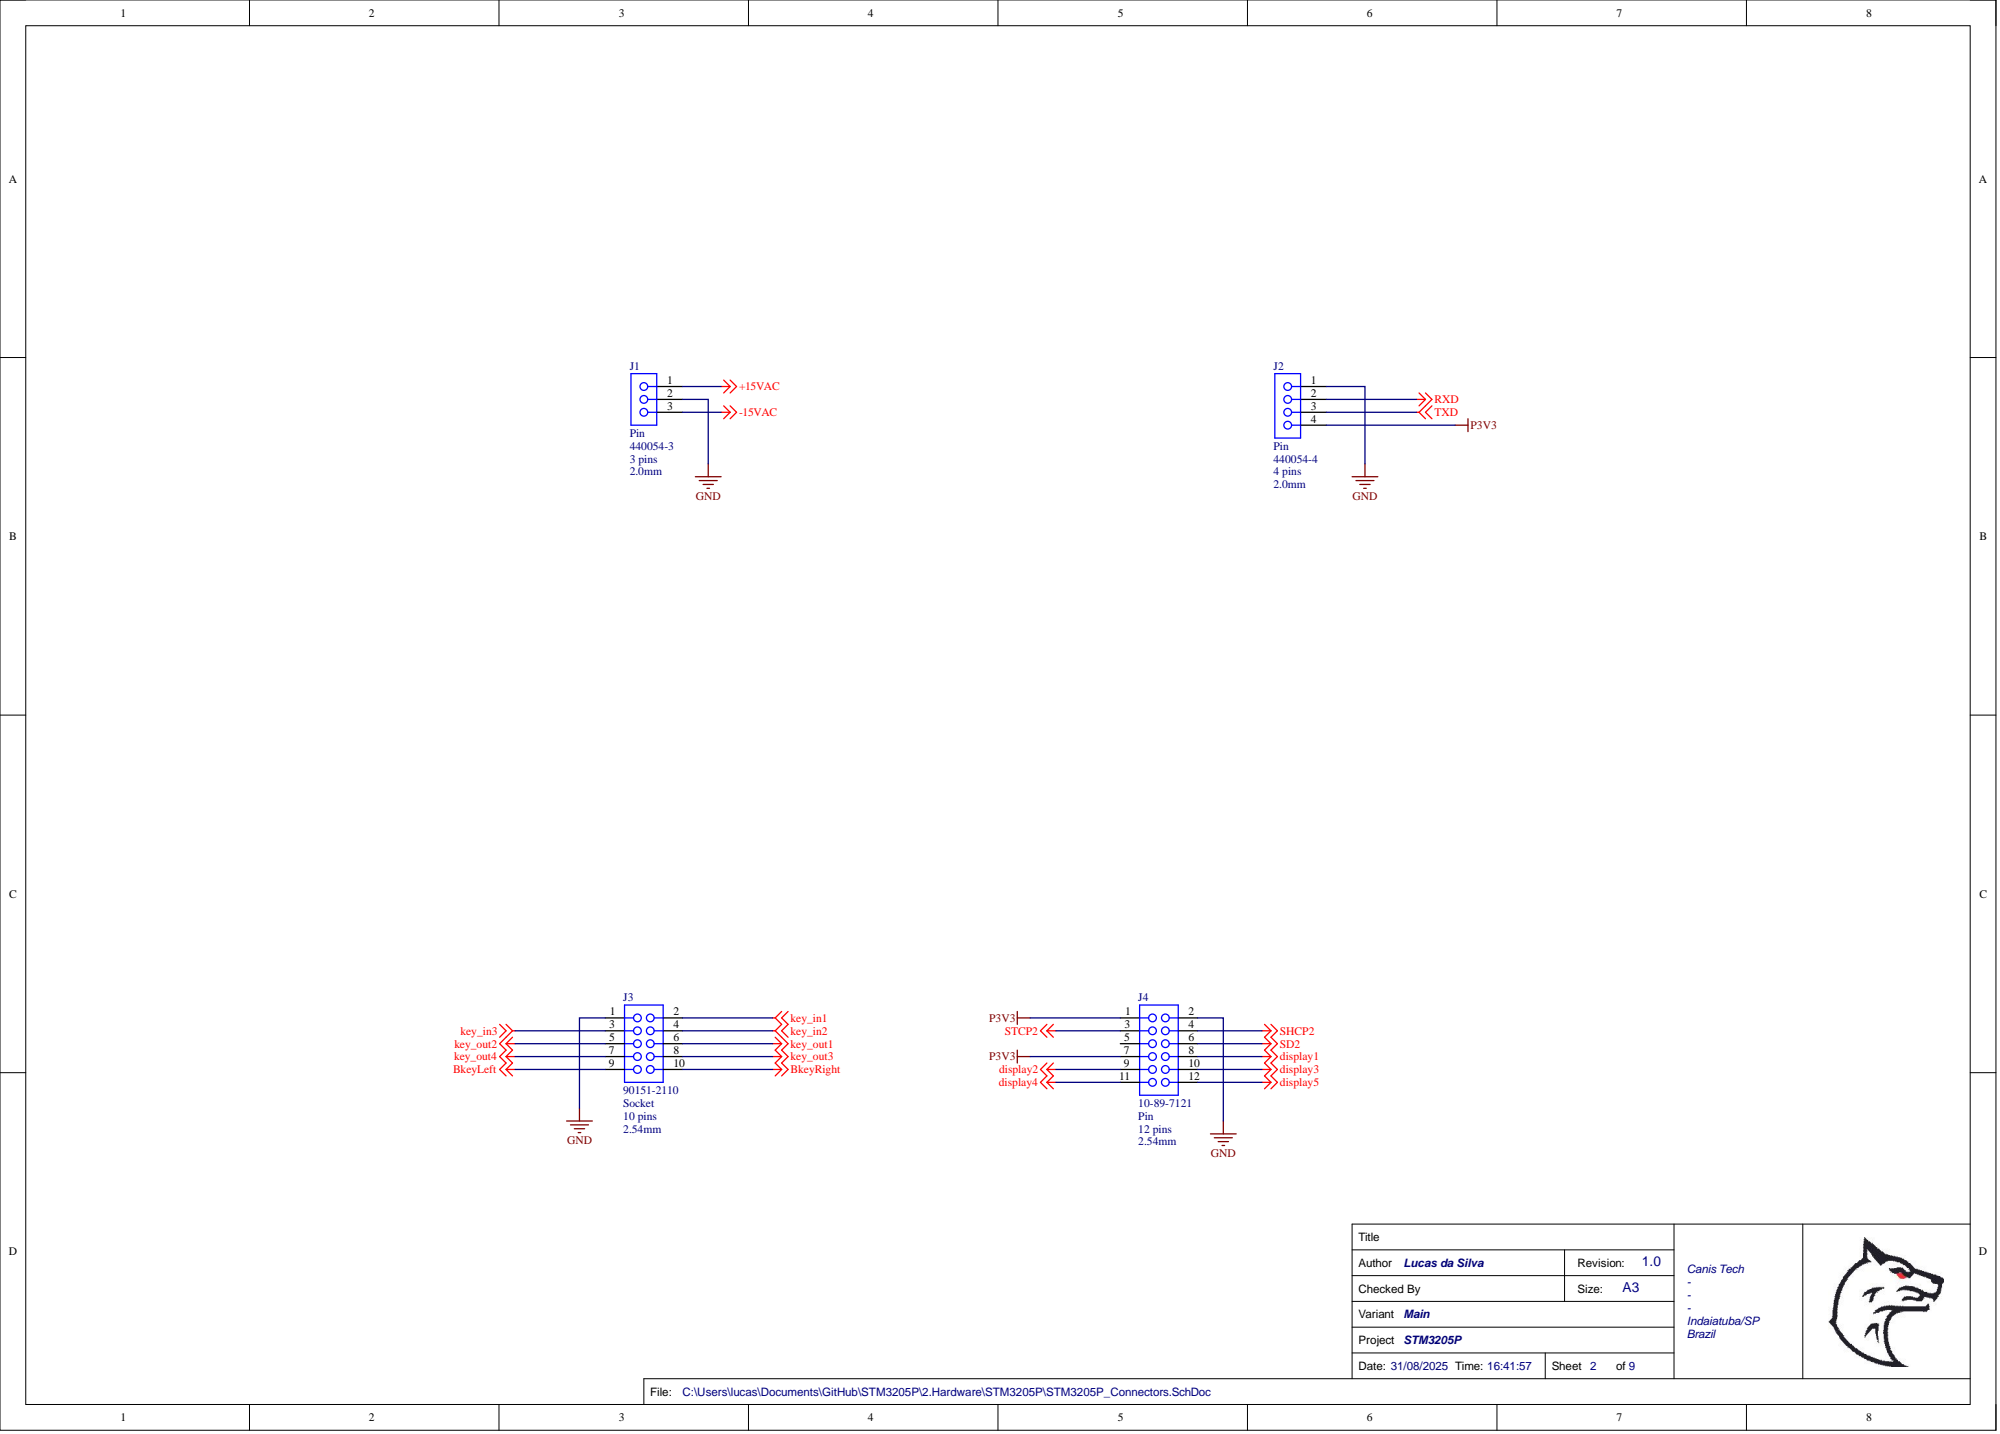
[picture p13: page 2]

Author Lucas da Silva | 1.0 Revision:

Checked By | Size: A3

File: C:\Users\lucas\Documents\GitHub\STM3205P\2.Hardware\STM3205P\STM3205P_Connectors.SchDoc

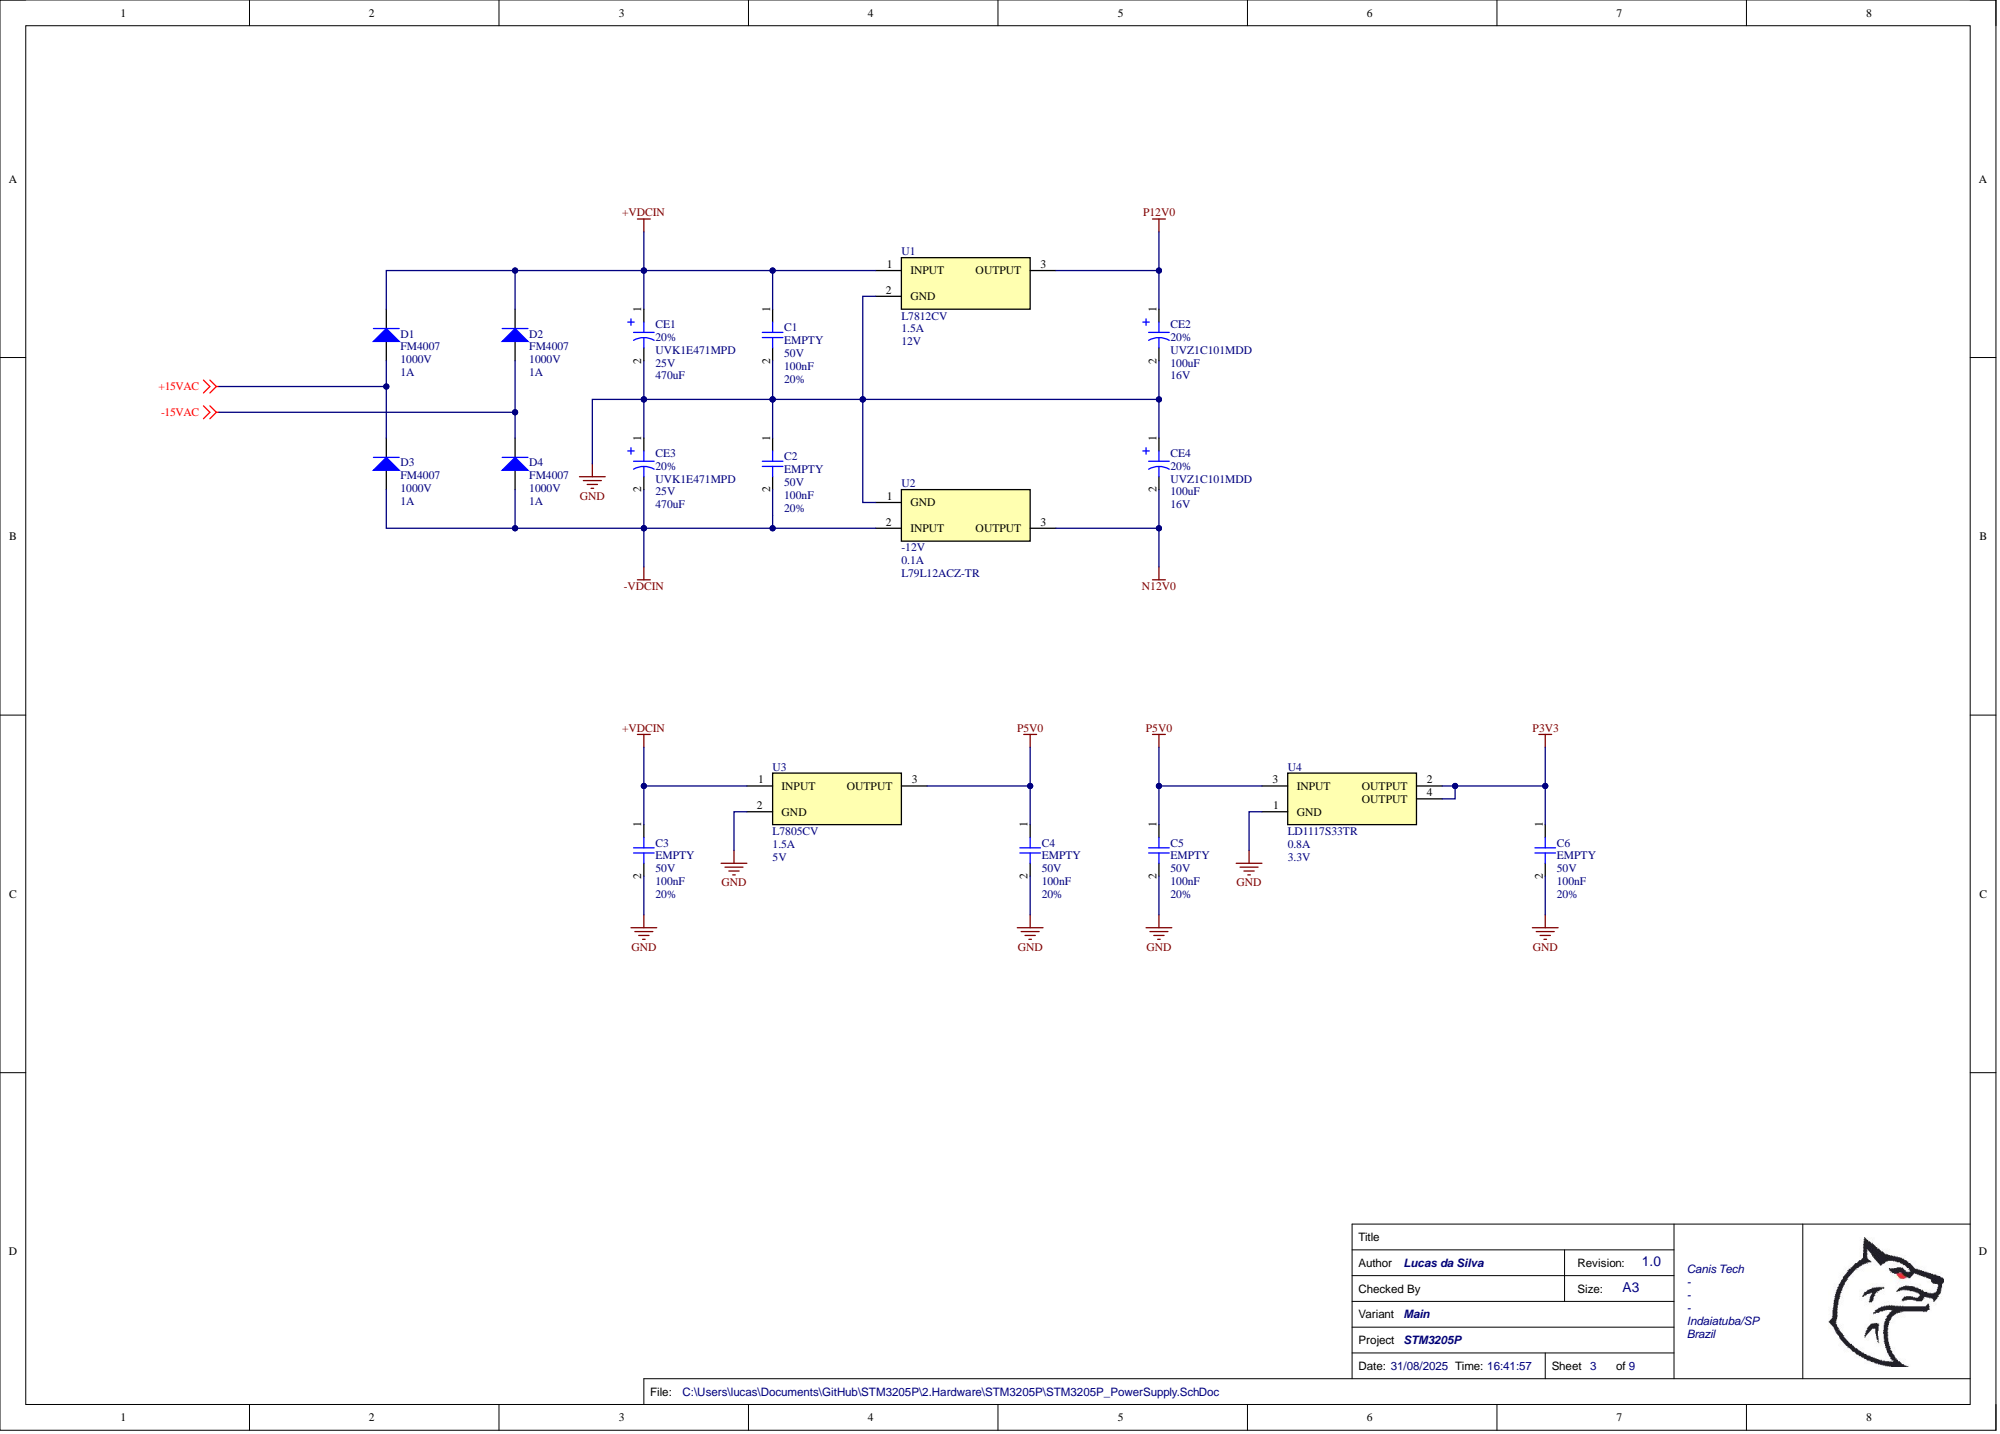
[picture p14: page 3]

Author Lucas da Silva | 1.0 Revision:

Checked By | Size: A3

File: C:\Users\lucas\Documents\GitHub\STM3205P\2.Hardware\STM3205P\STM3205P_PowerSupply.SchDoc

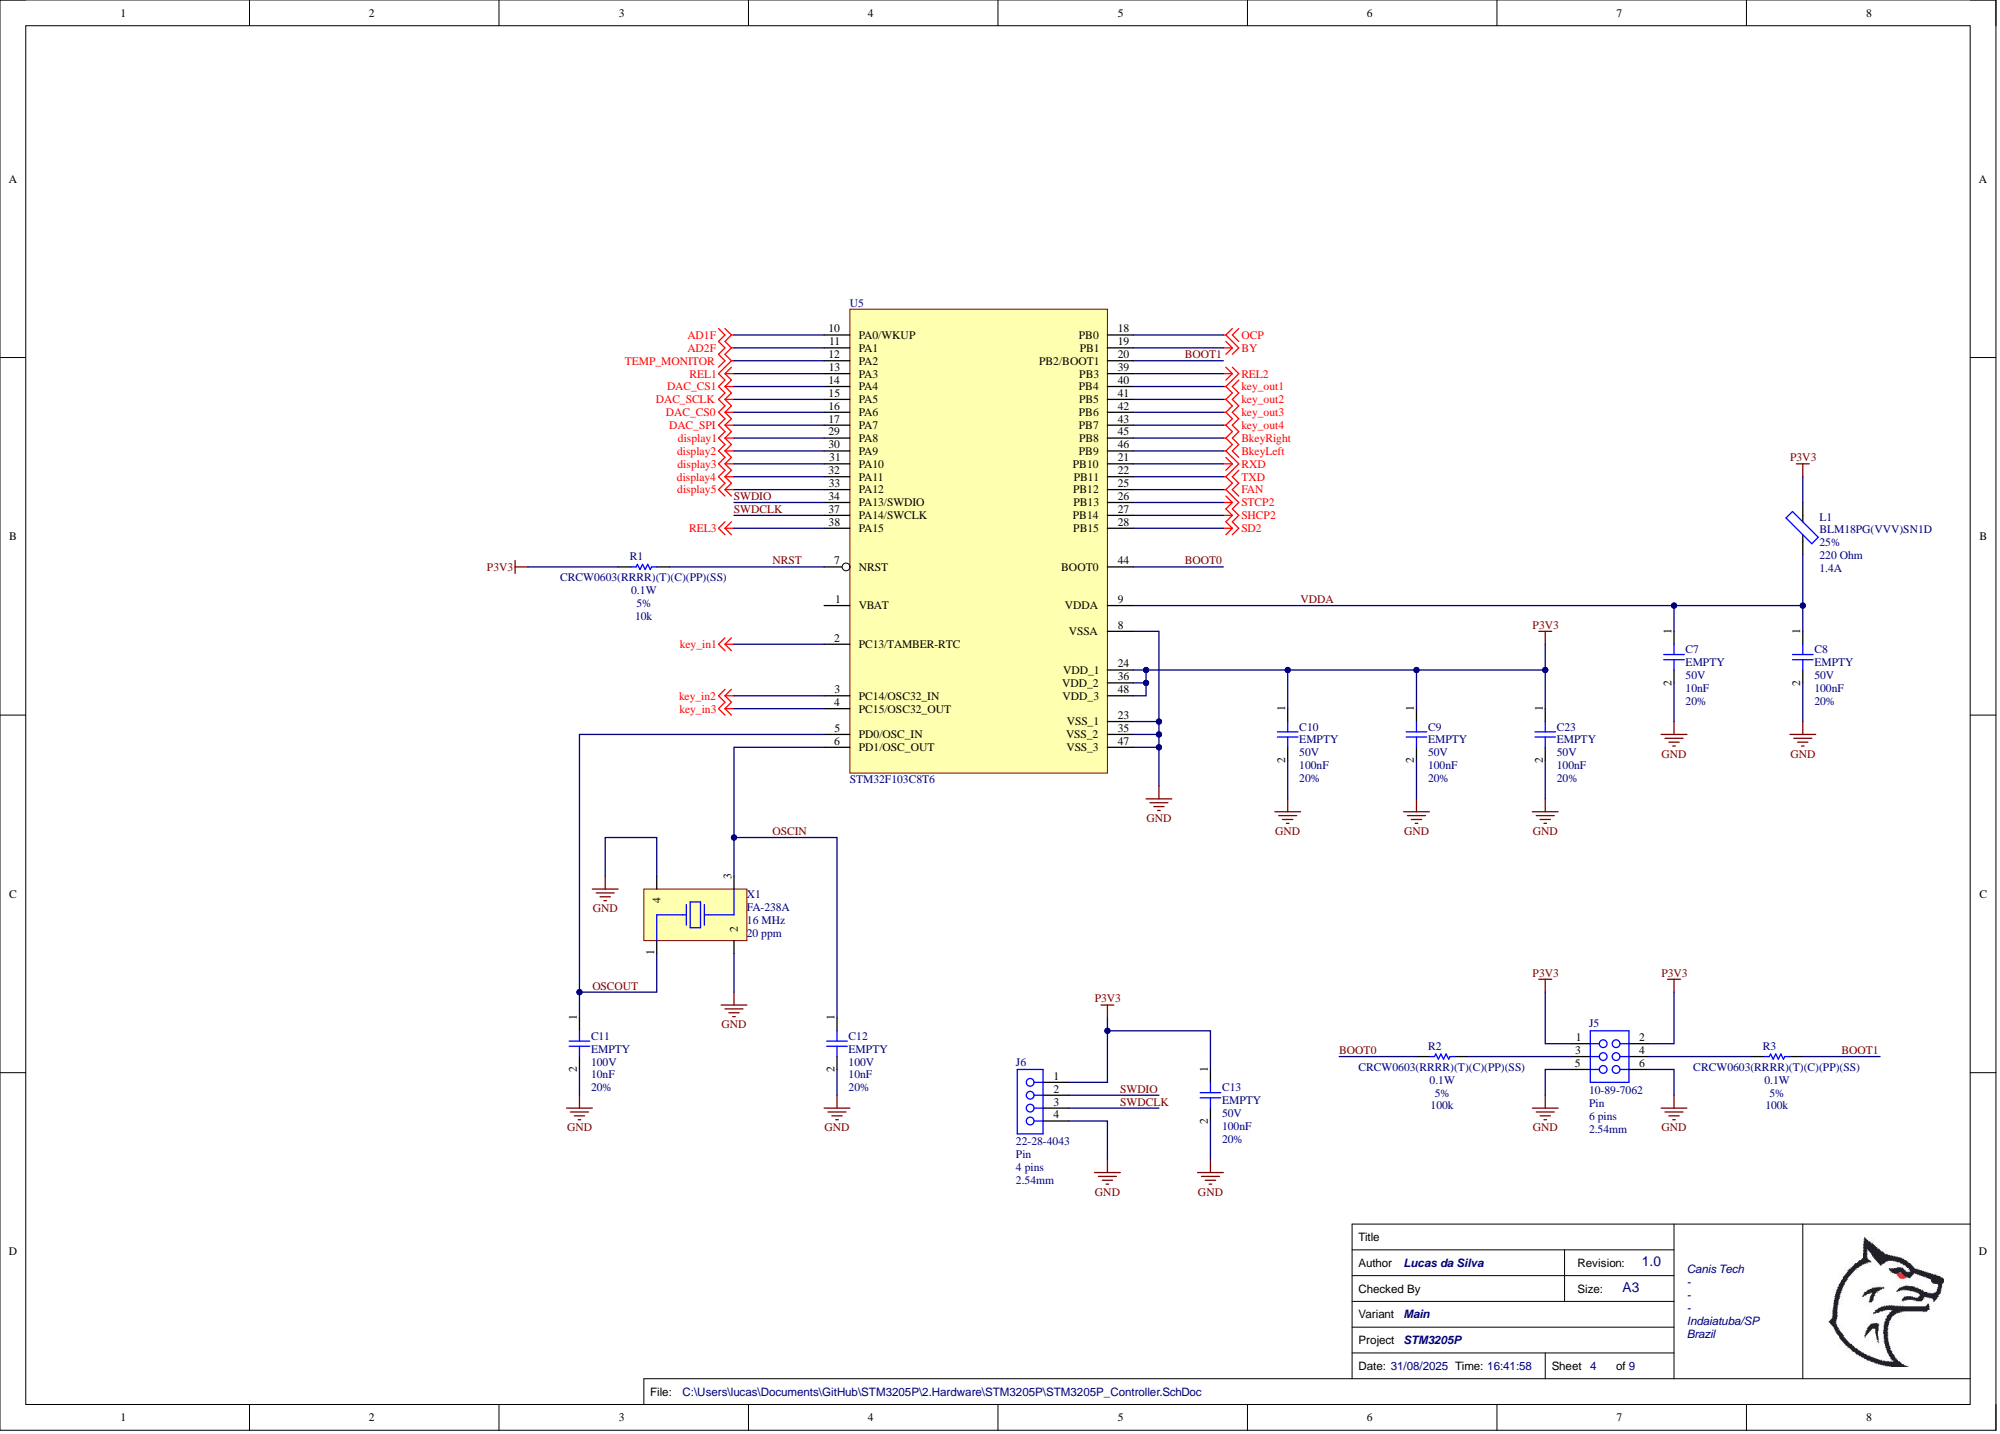
[picture p15: page 4]

Author Lucas da Silva | 1.0 Revision:

Checked By | Size: A3

File: C:\Users\lucas\Documents\GitHub\STM3205P\2.Hardware\STM3205P\STM3205P_Controller.SchDoc

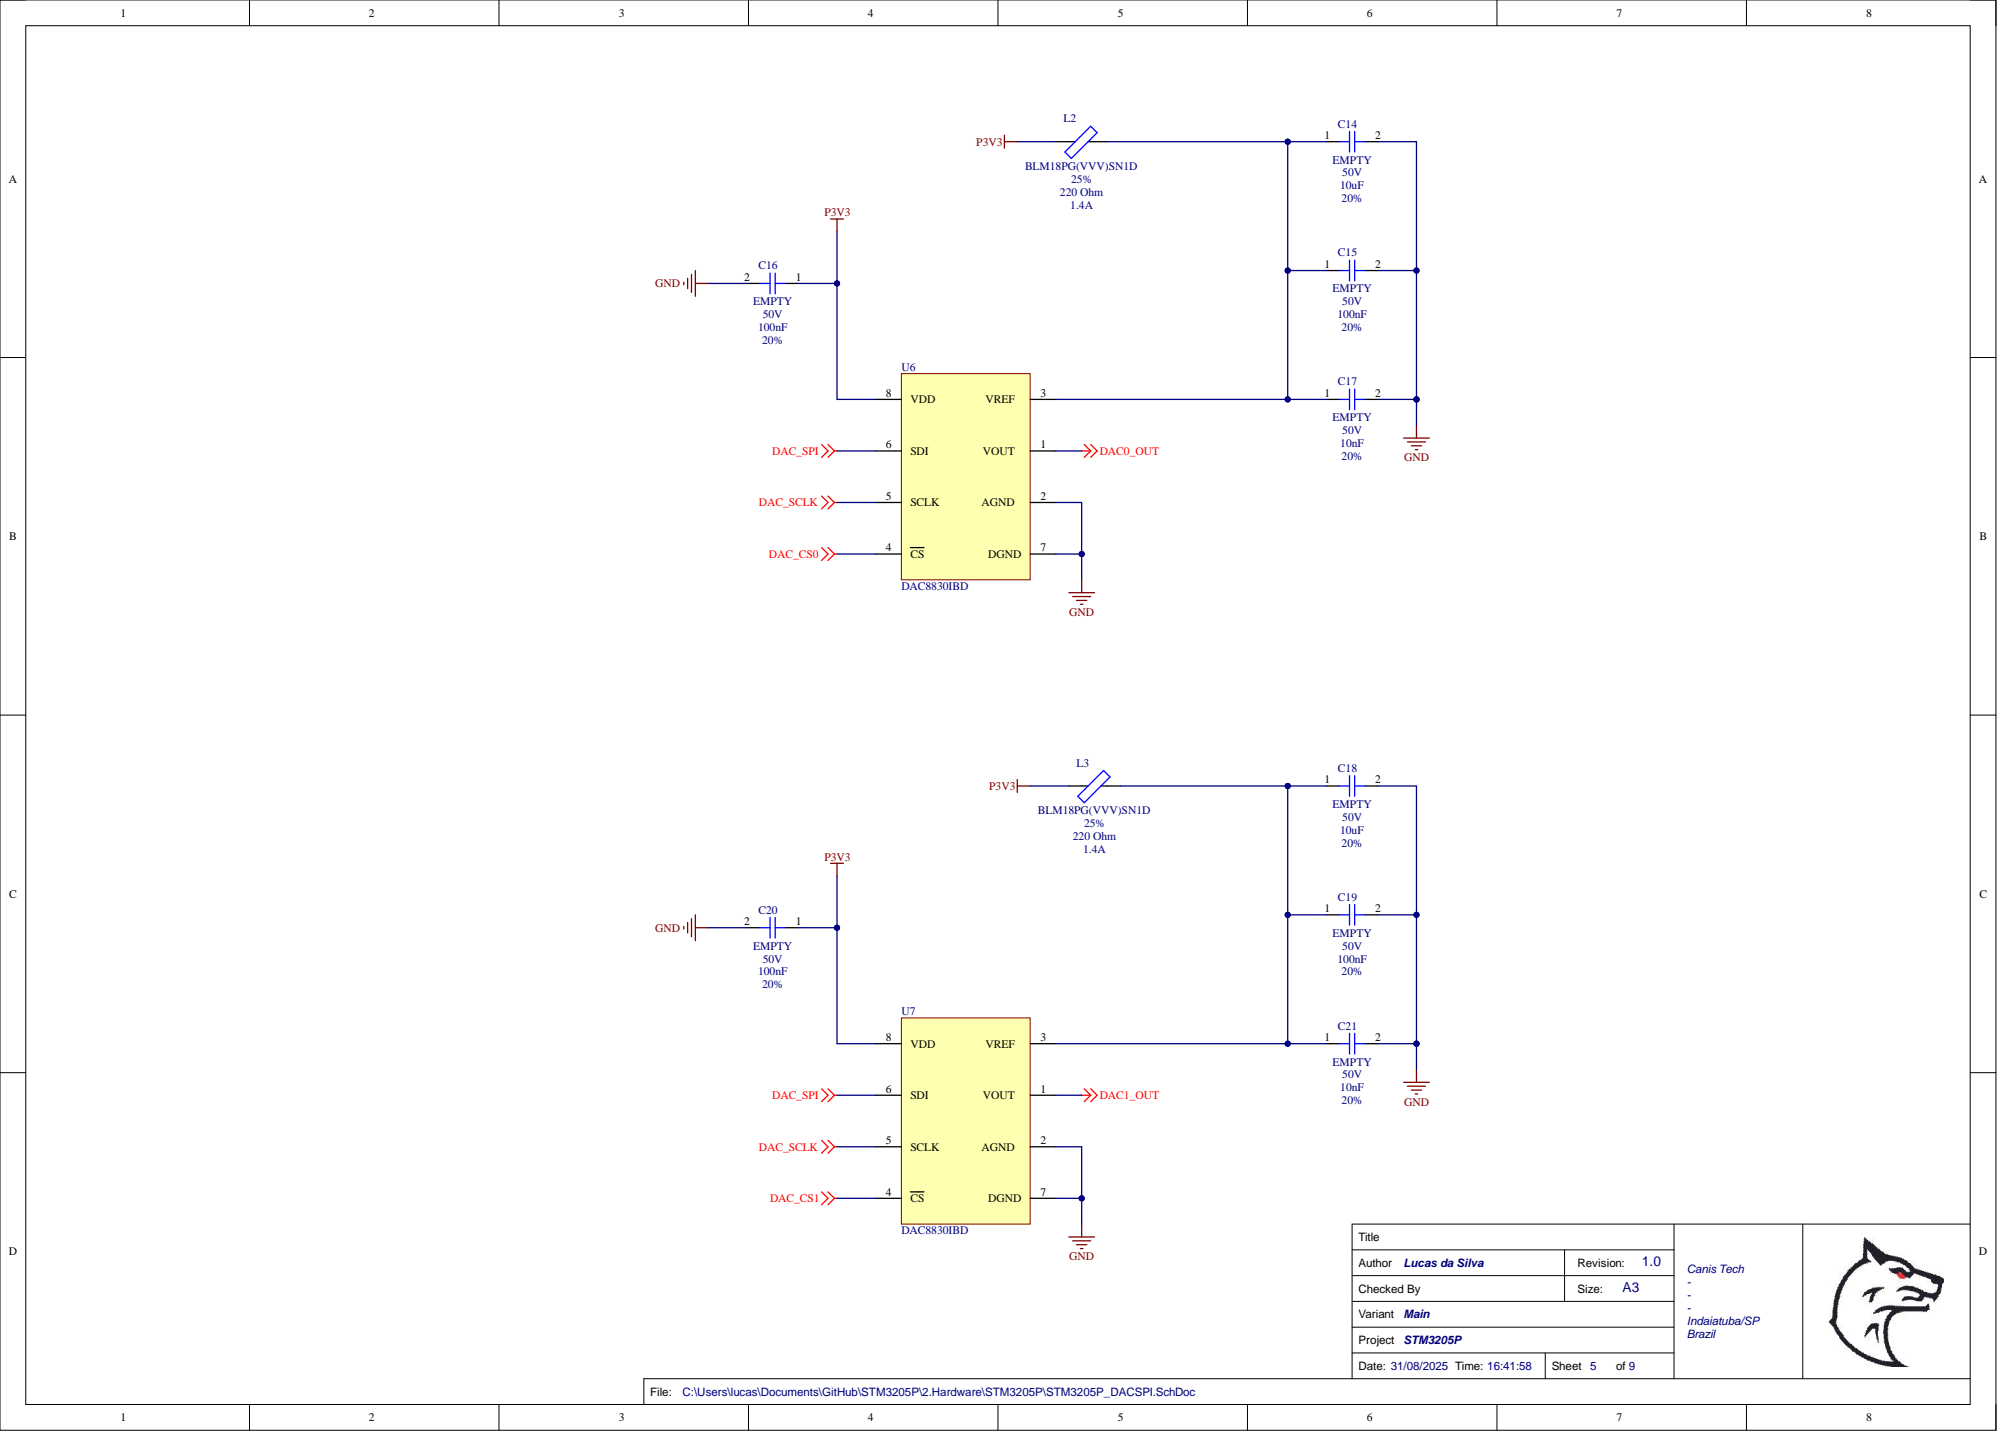
[picture p16: page 5]

Author Lucas da Silva | 1.0 Revision:

Checked By | Size: A3

File: C:\Users\lucas\Documents\GitHub\STM3205P\2.Hardware\STM3205P\STM3205P_DACSPI.SchDoc

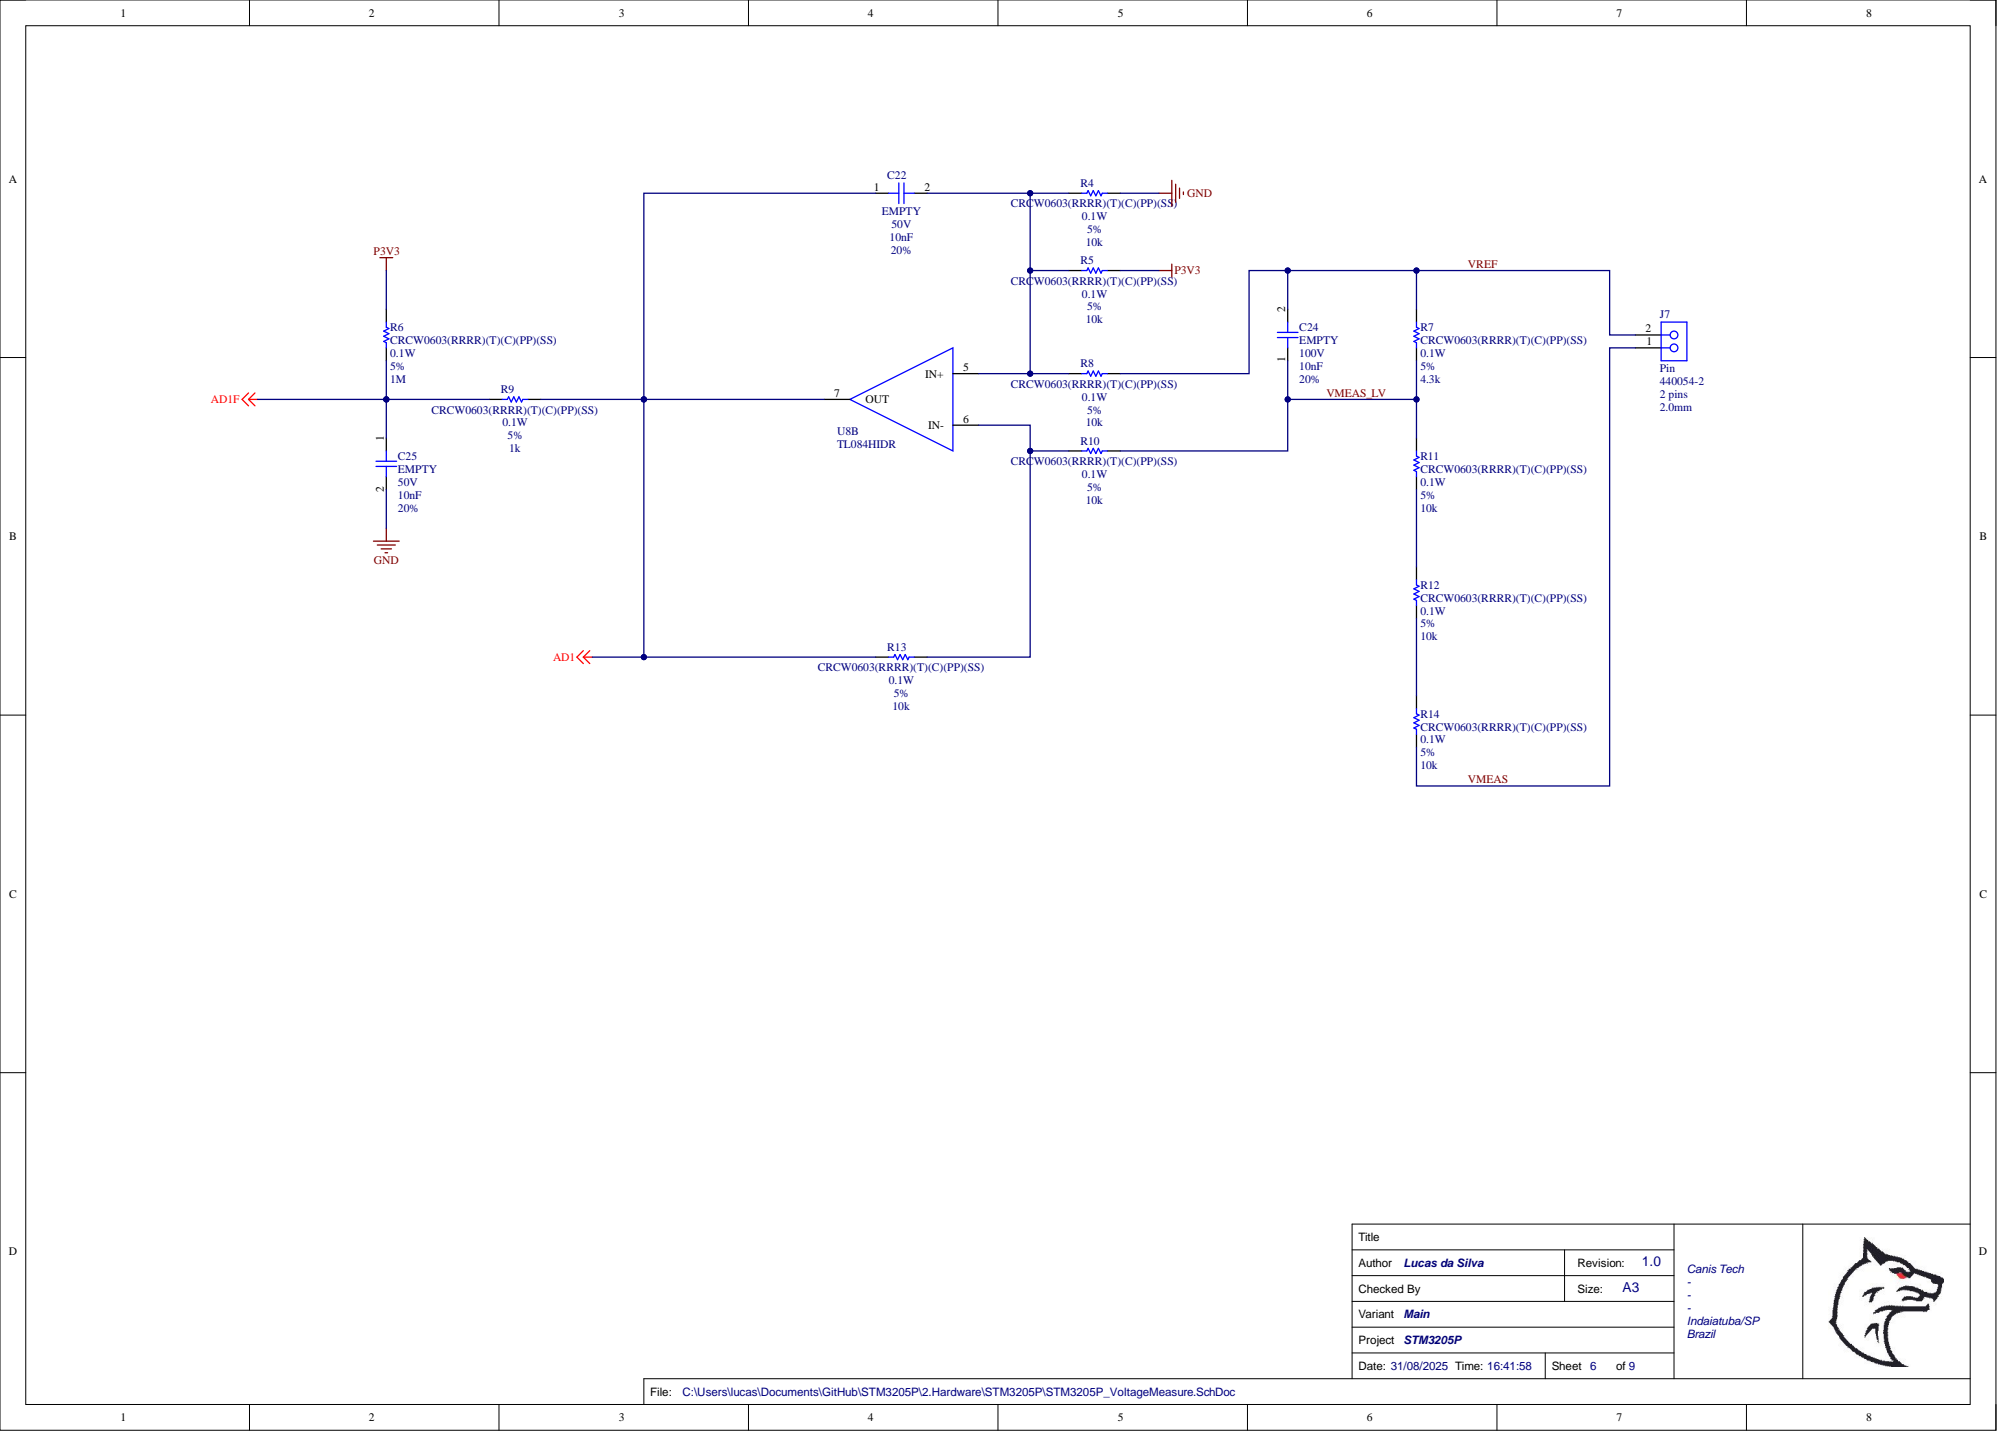
[picture p17: page 6]

Author Lucas da Silva | 1.0 Revision:

Checked By | Size: A3

File: C:\Users\lucas\Documents\GitHub\STM3205P\2.Hardware\STM3205P\STM3205P_VoltageMeasure.SchDoc

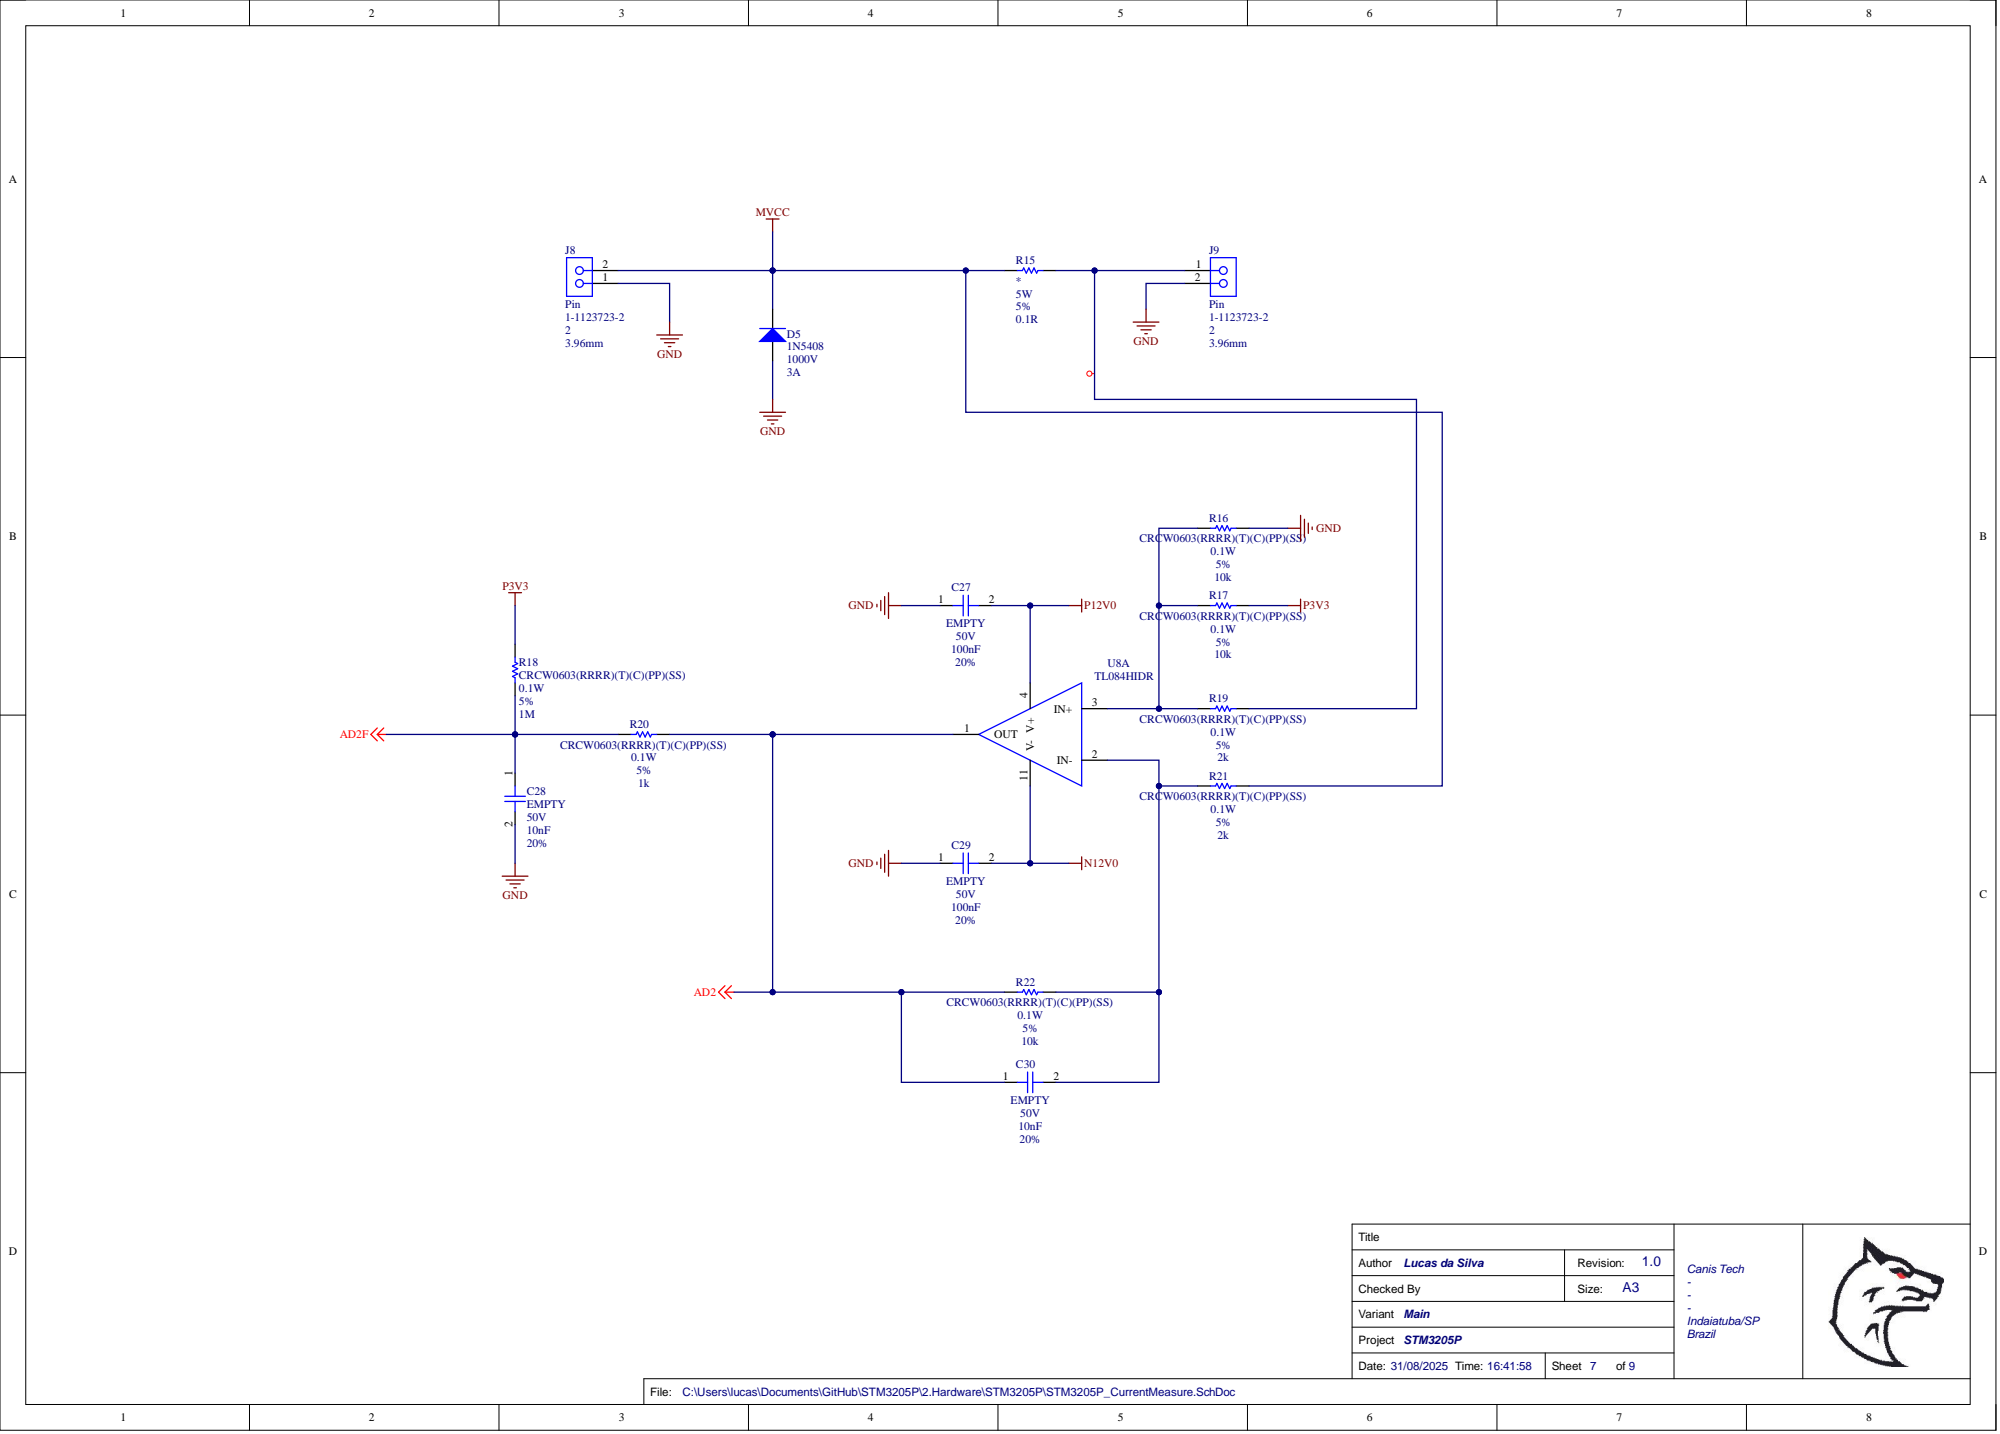
[picture p18: page 7]

Author Lucas da Silva | 1.0 Revision:

Checked By | Size: A3

File: C:\Users\lucas\Documents\GitHub\STM3205P\2.Hardware\STM3205P\STM3205P_CurrentMeasure.SchDoc

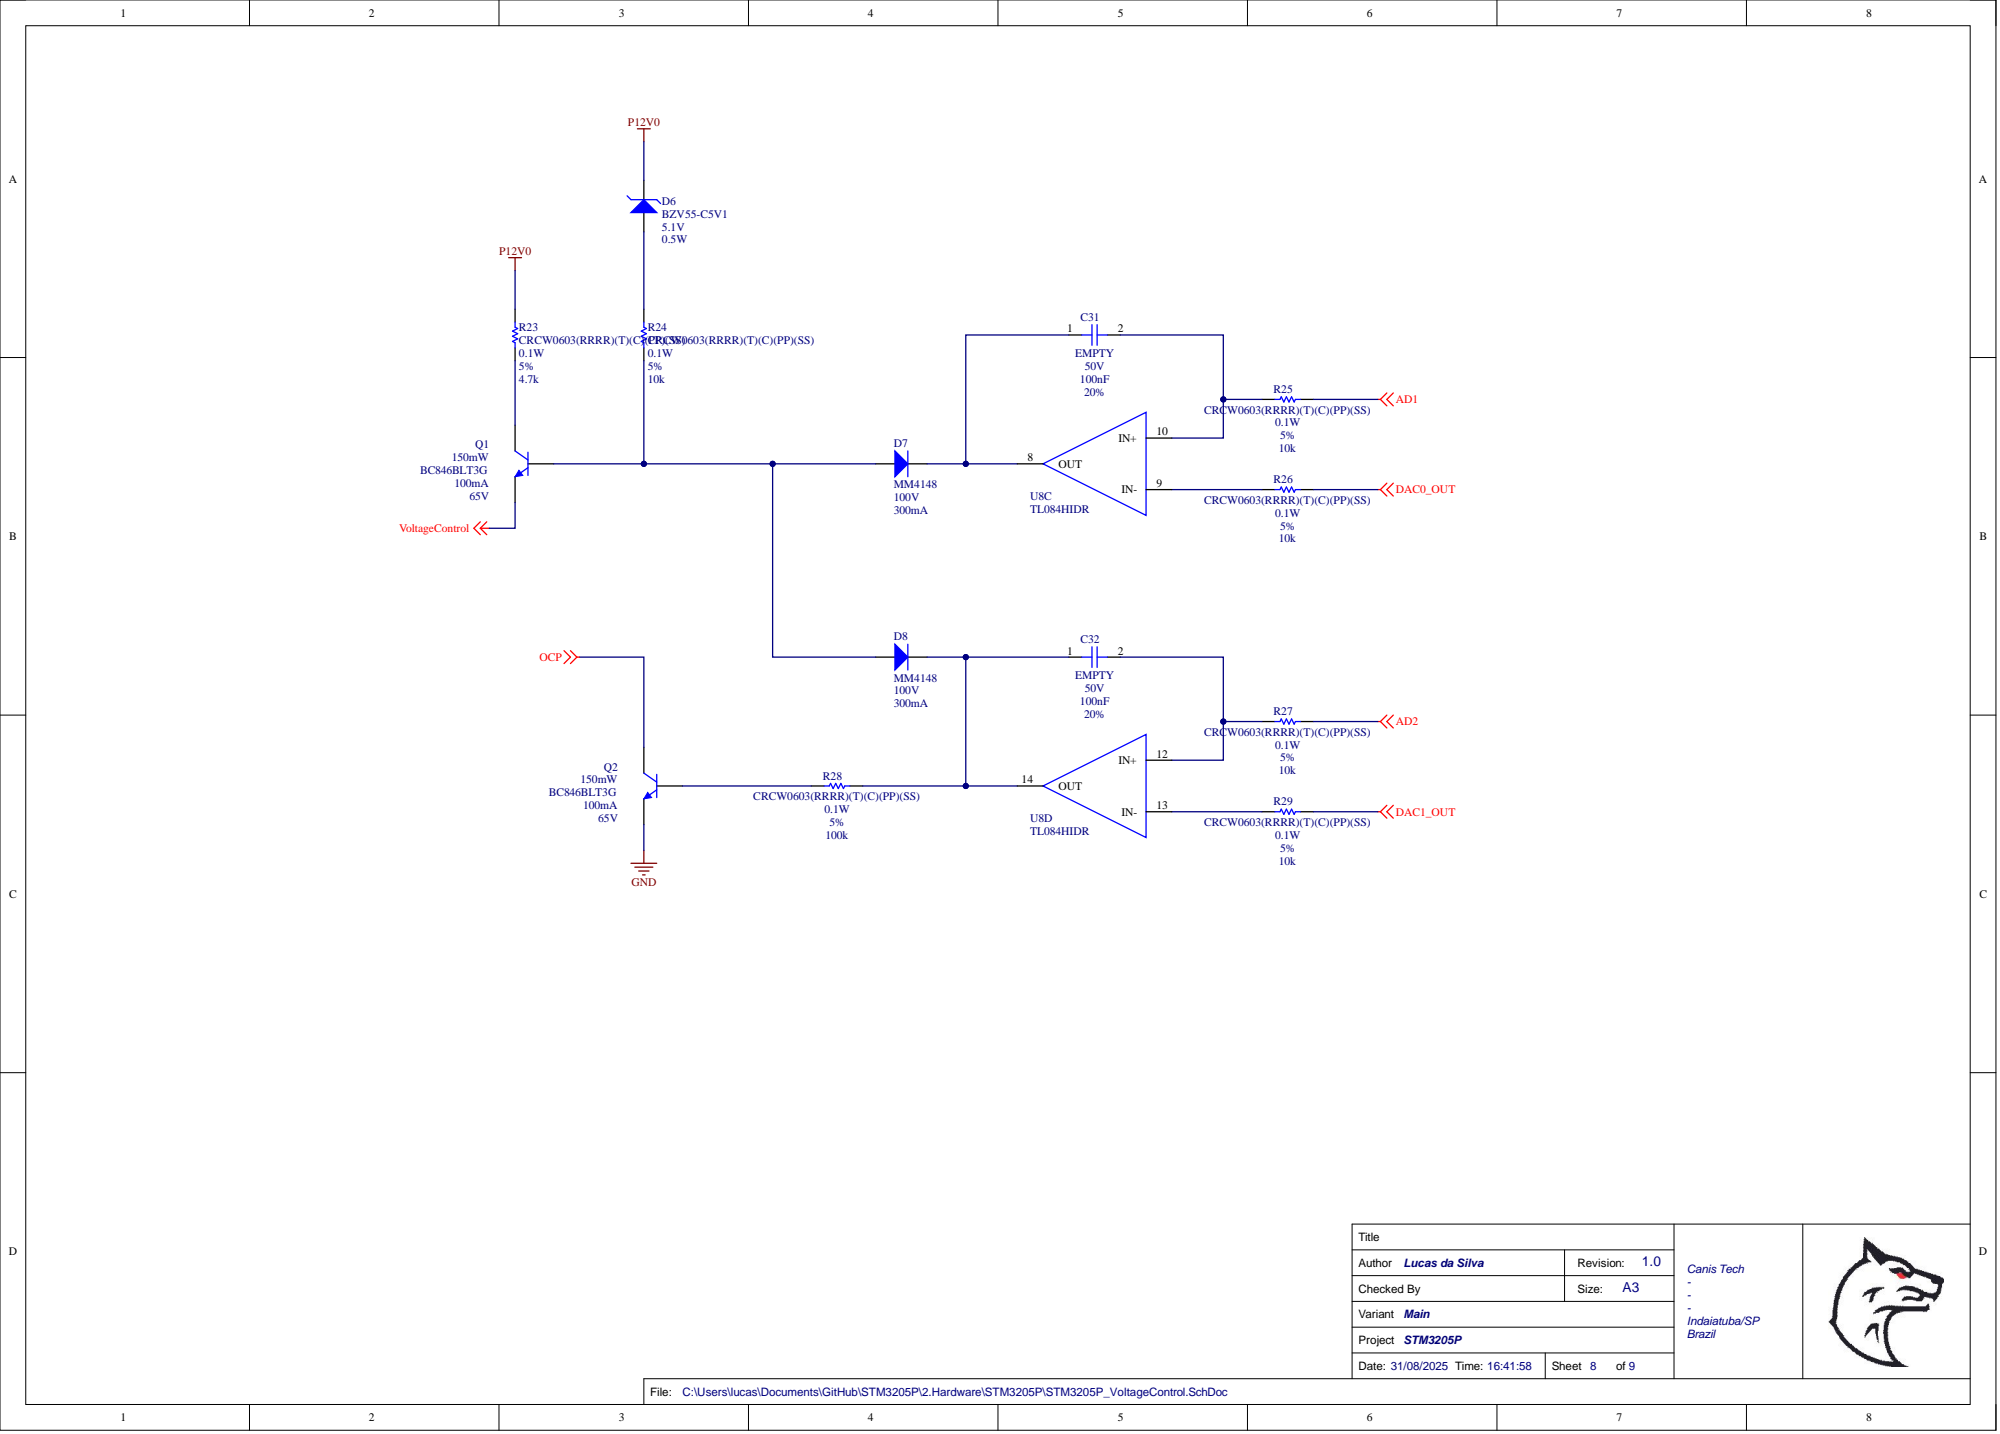
[picture p19: page 8]

Author Lucas da Silva | 1.0 Revision:

Checked By | Size: A3

File: C:\Users\lucas\Documents\GitHub\STM3205P\2.Hardware\STM3205P\STM3205P_VoltageControl.SchDoc

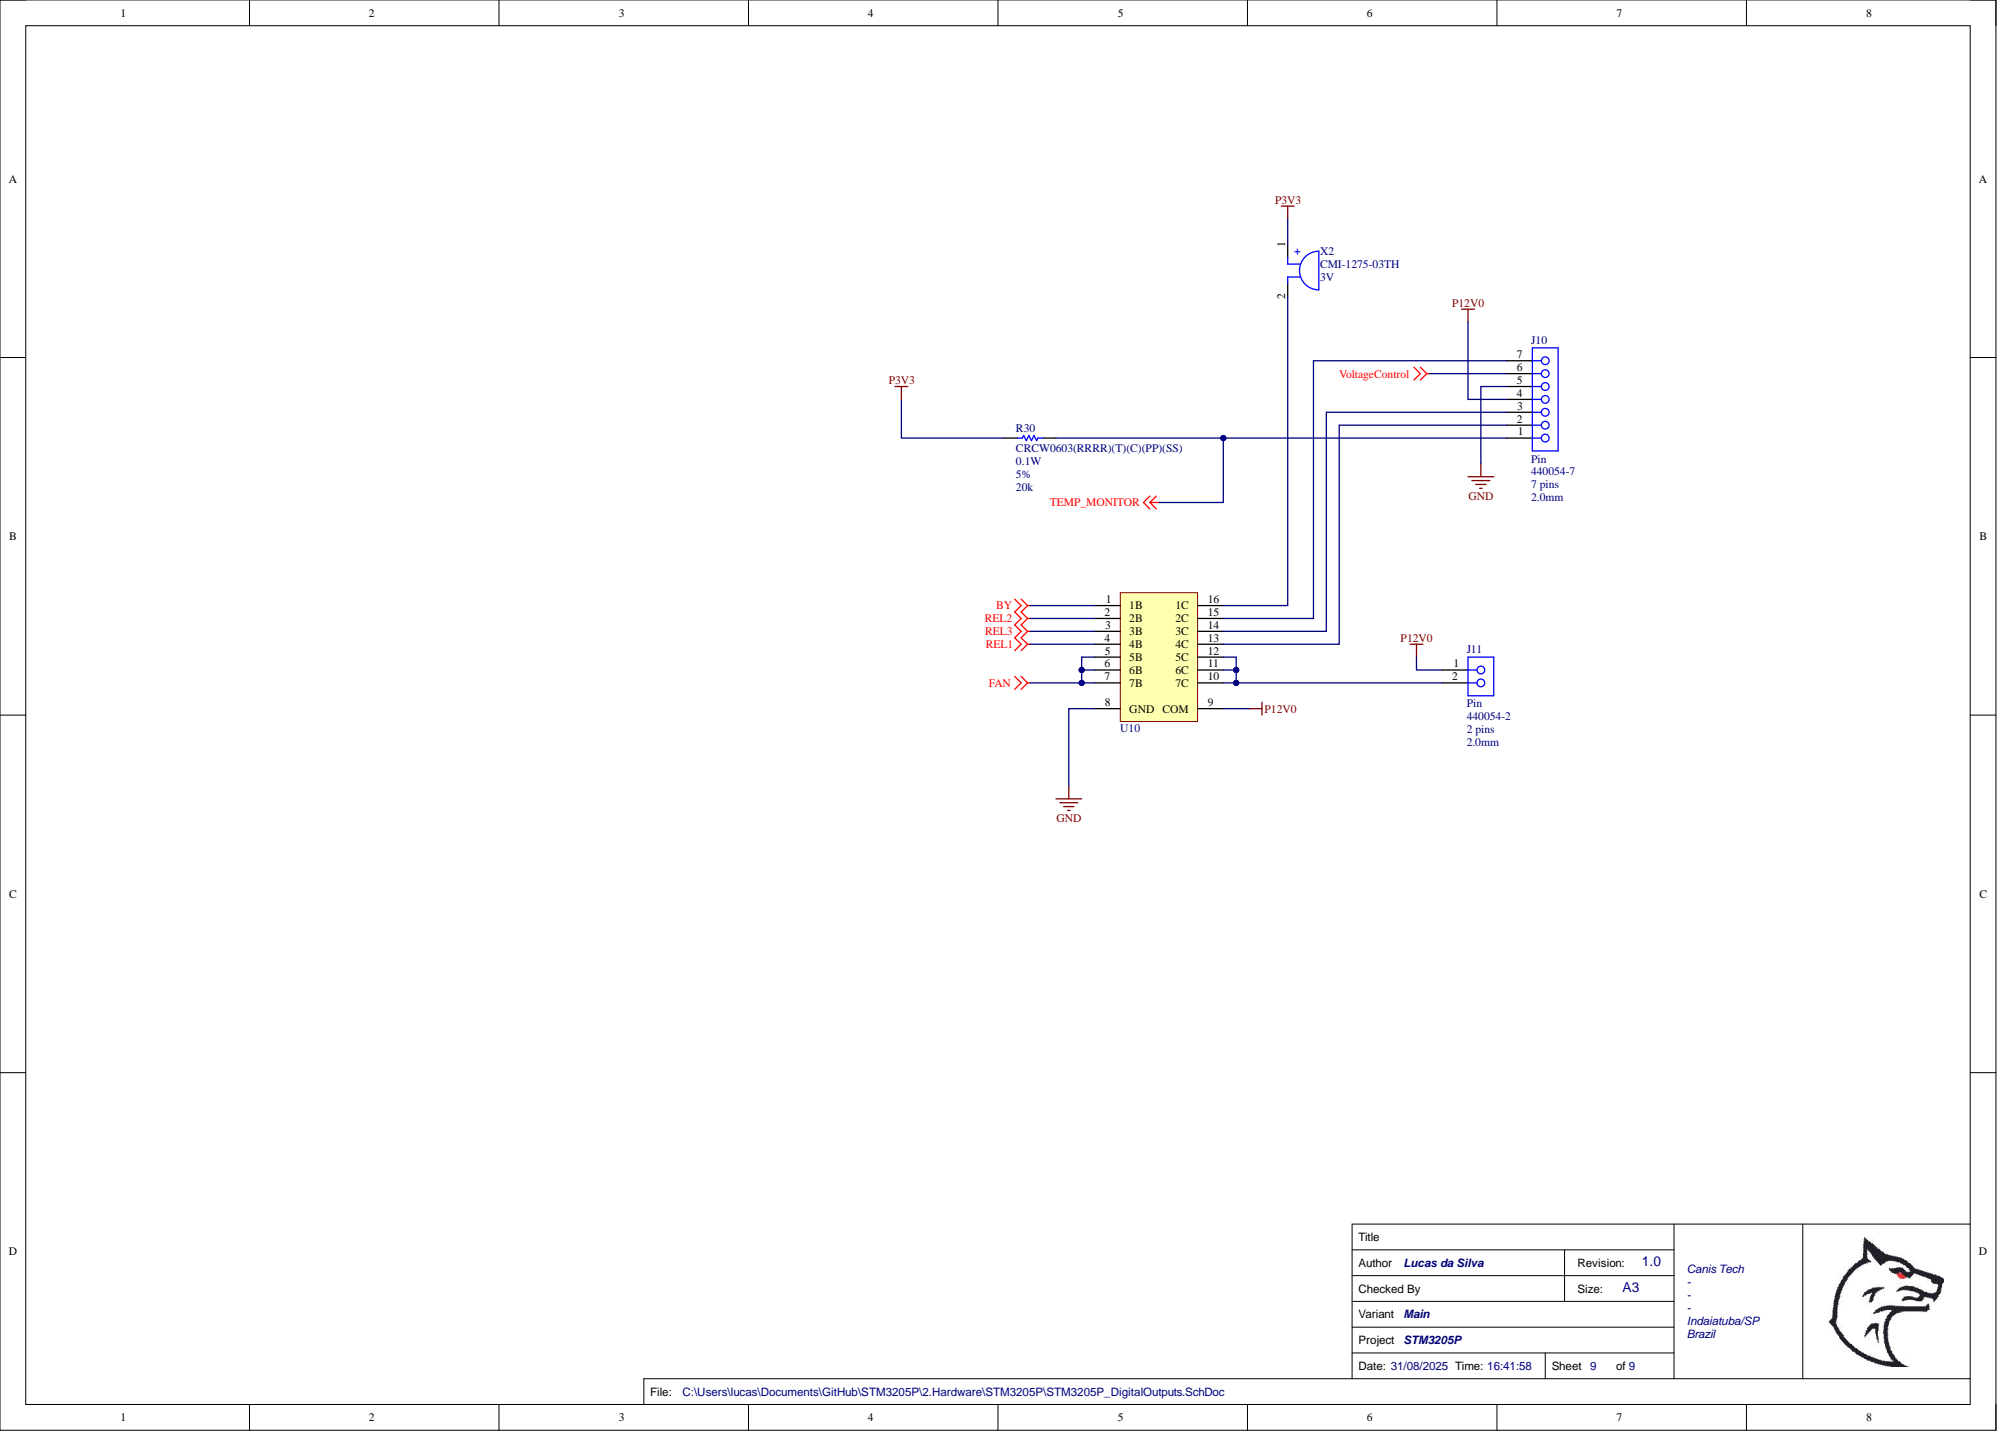
[picture p20: page 9]

Author Lucas da Silva | 1.0 Revision:

Checked By | Size: A3

File: C:\Users\lucas\Documents\GitHub\STM3205P\2.Hardware\STM3205P\STM3205P_DigitalOutputs.SchDoc
