lucasmoraeseng/STM3205P/2.Hardware/STM3205P/PO/SCH/STM3205P_SCH_1.0_Main_2025-08-26.PDF

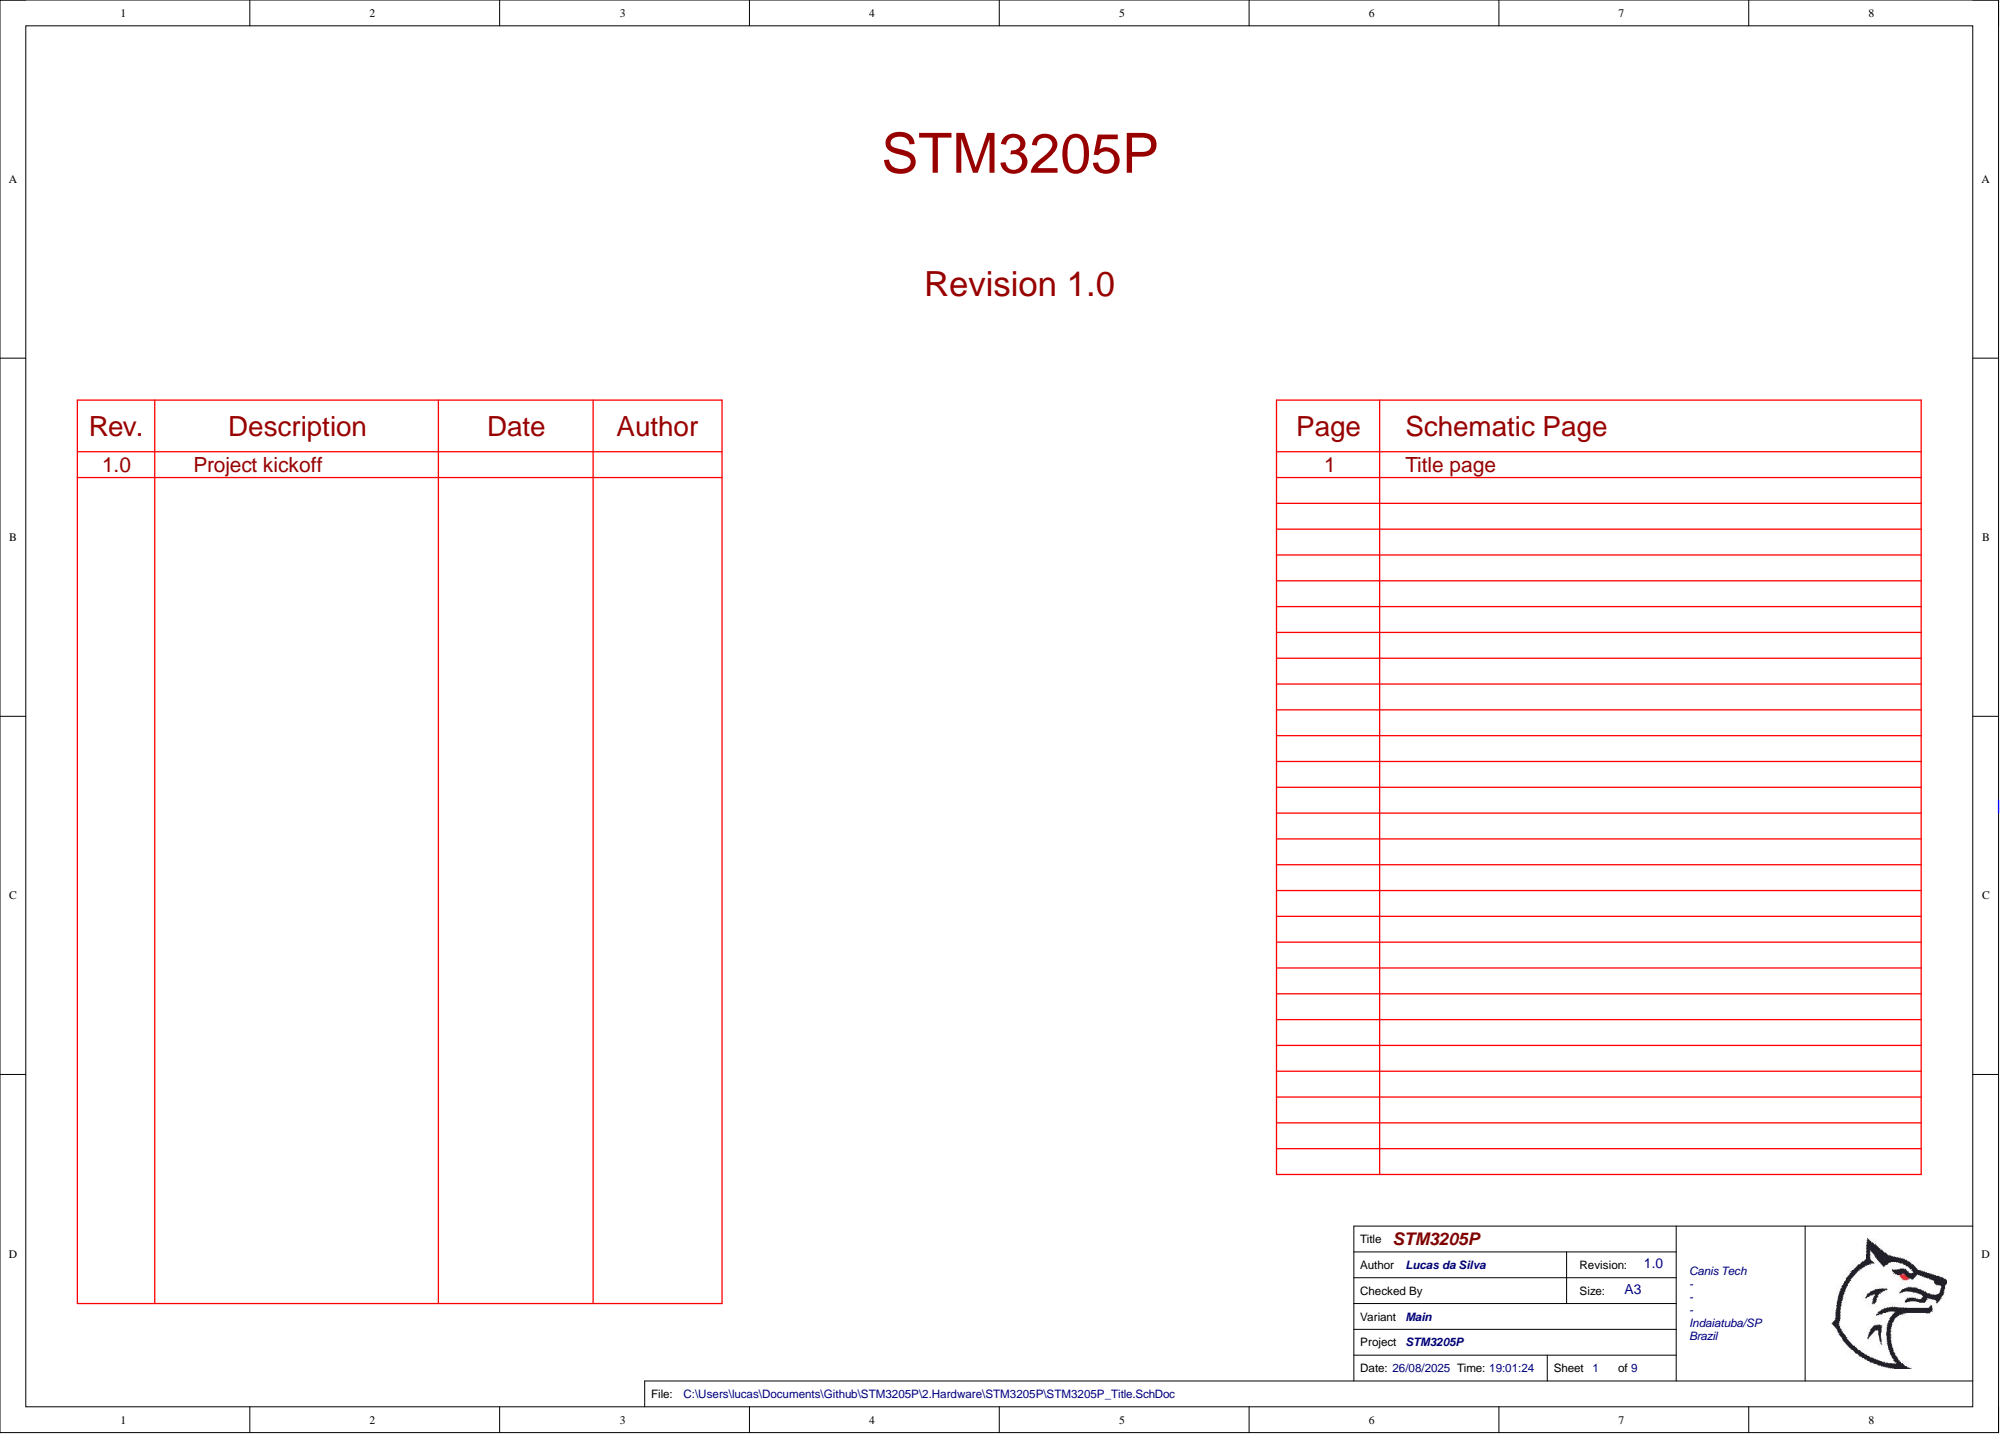
[picture p21: page 1]

Author Lucas da Silva | Revision: 1.0

Checked By | A3 Size:

File: C:\Users\lucas\Documents\Github\STM3205P\2.Hardware\STM3205P\STM3205P_Title.SchDoc

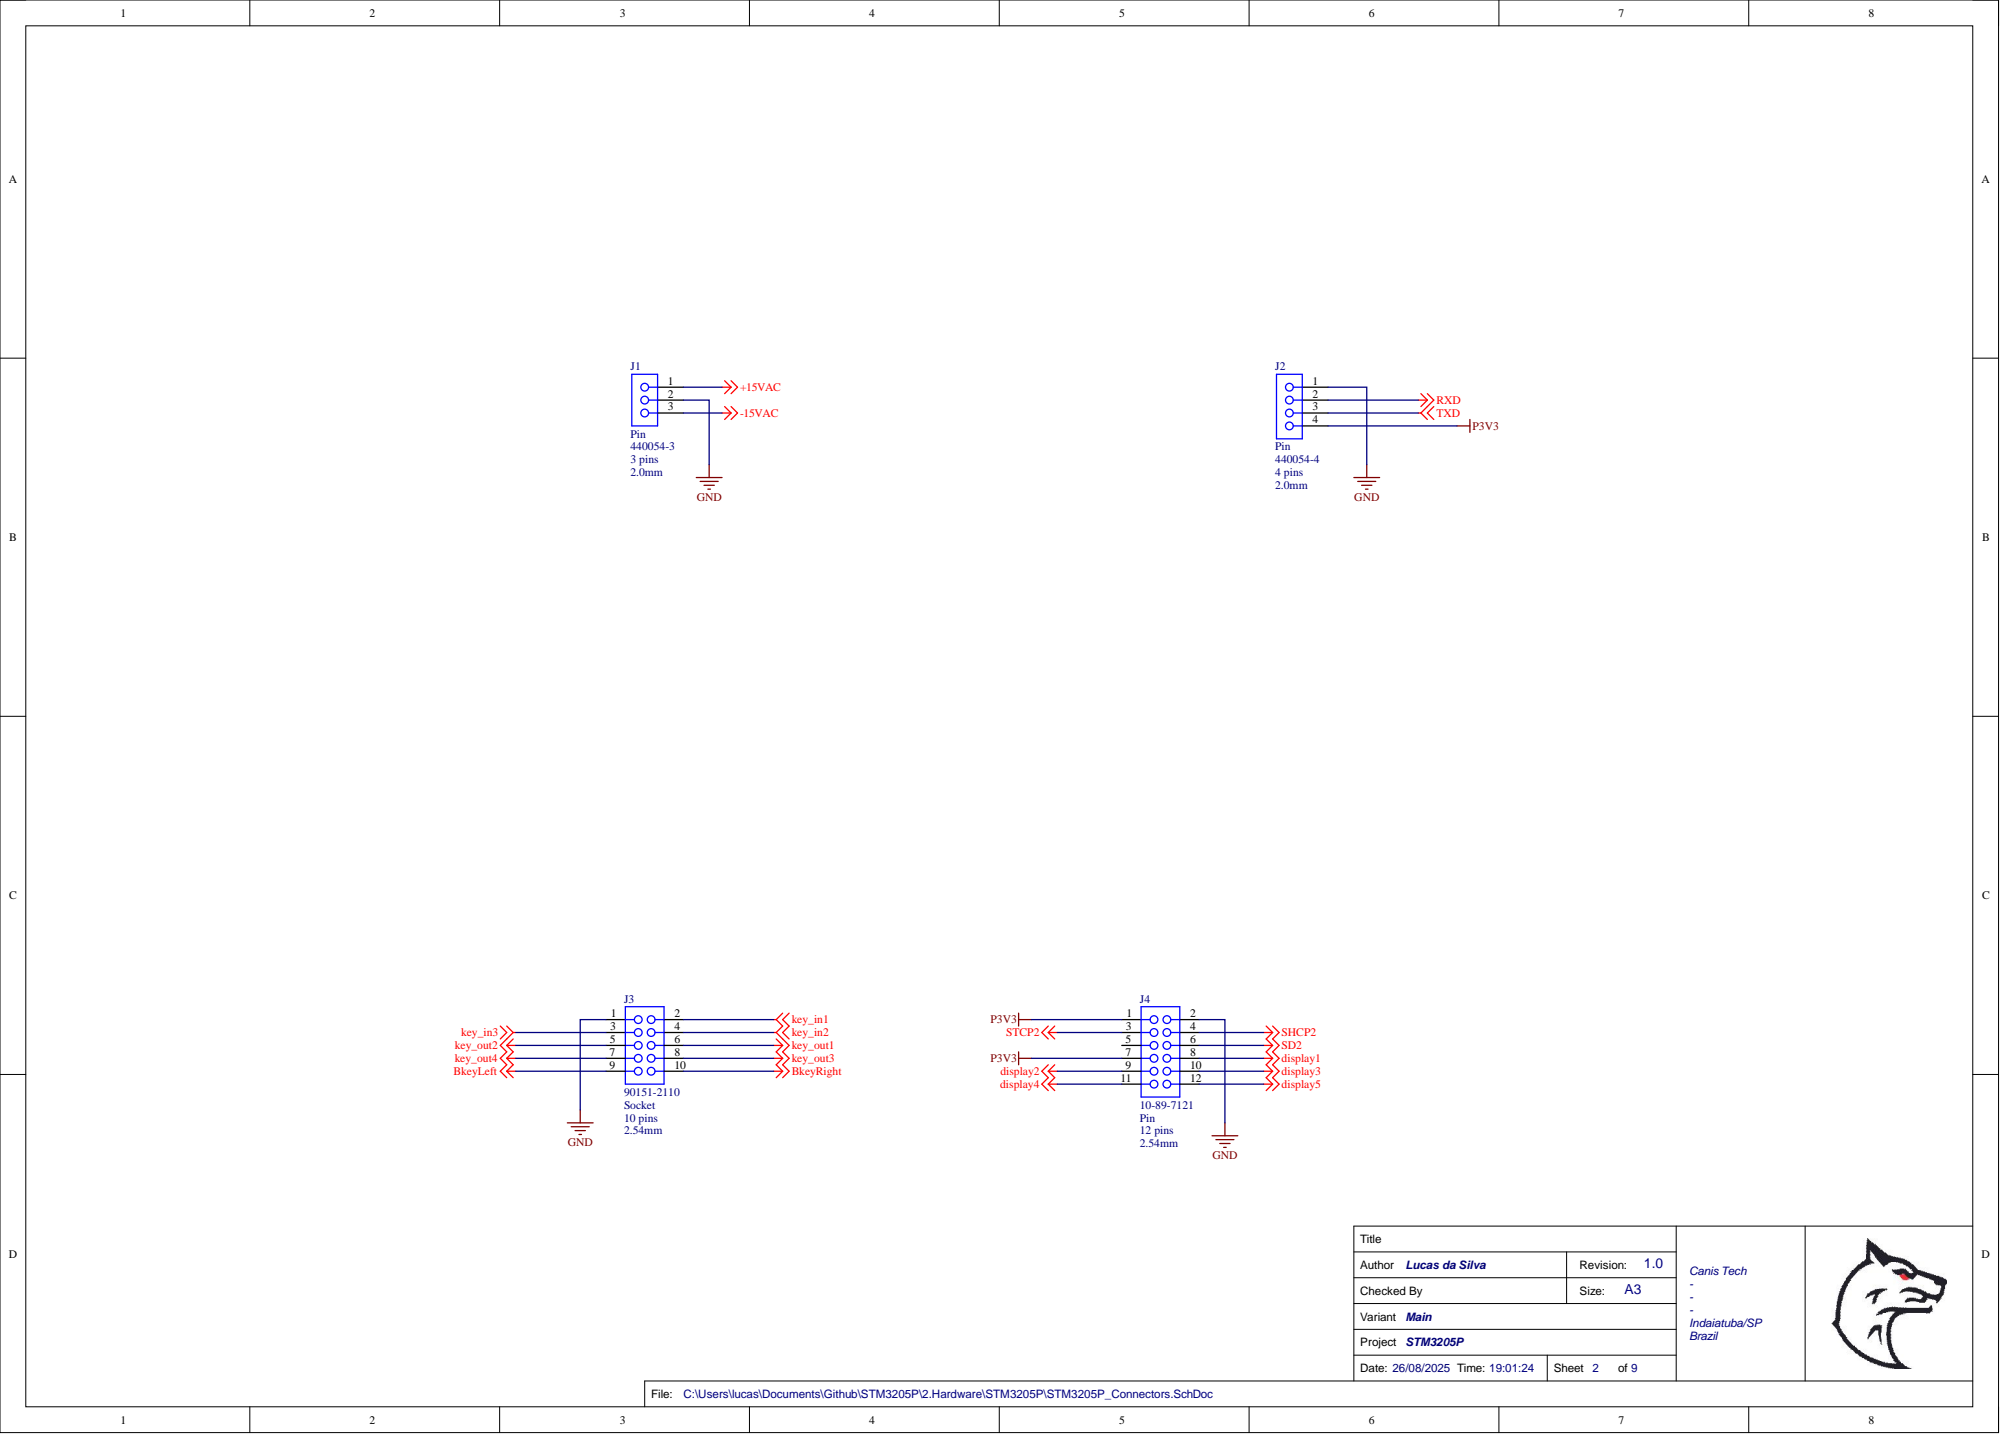
[picture p22: page 2]

Author Lucas da Silva | Revision: 1.0

Checked By | A3 Size:

File: C:\Users\lucas\Documents\Github\STM3205P\2.Hardware\STM3205P\STM3205P_Connectors.SchDoc

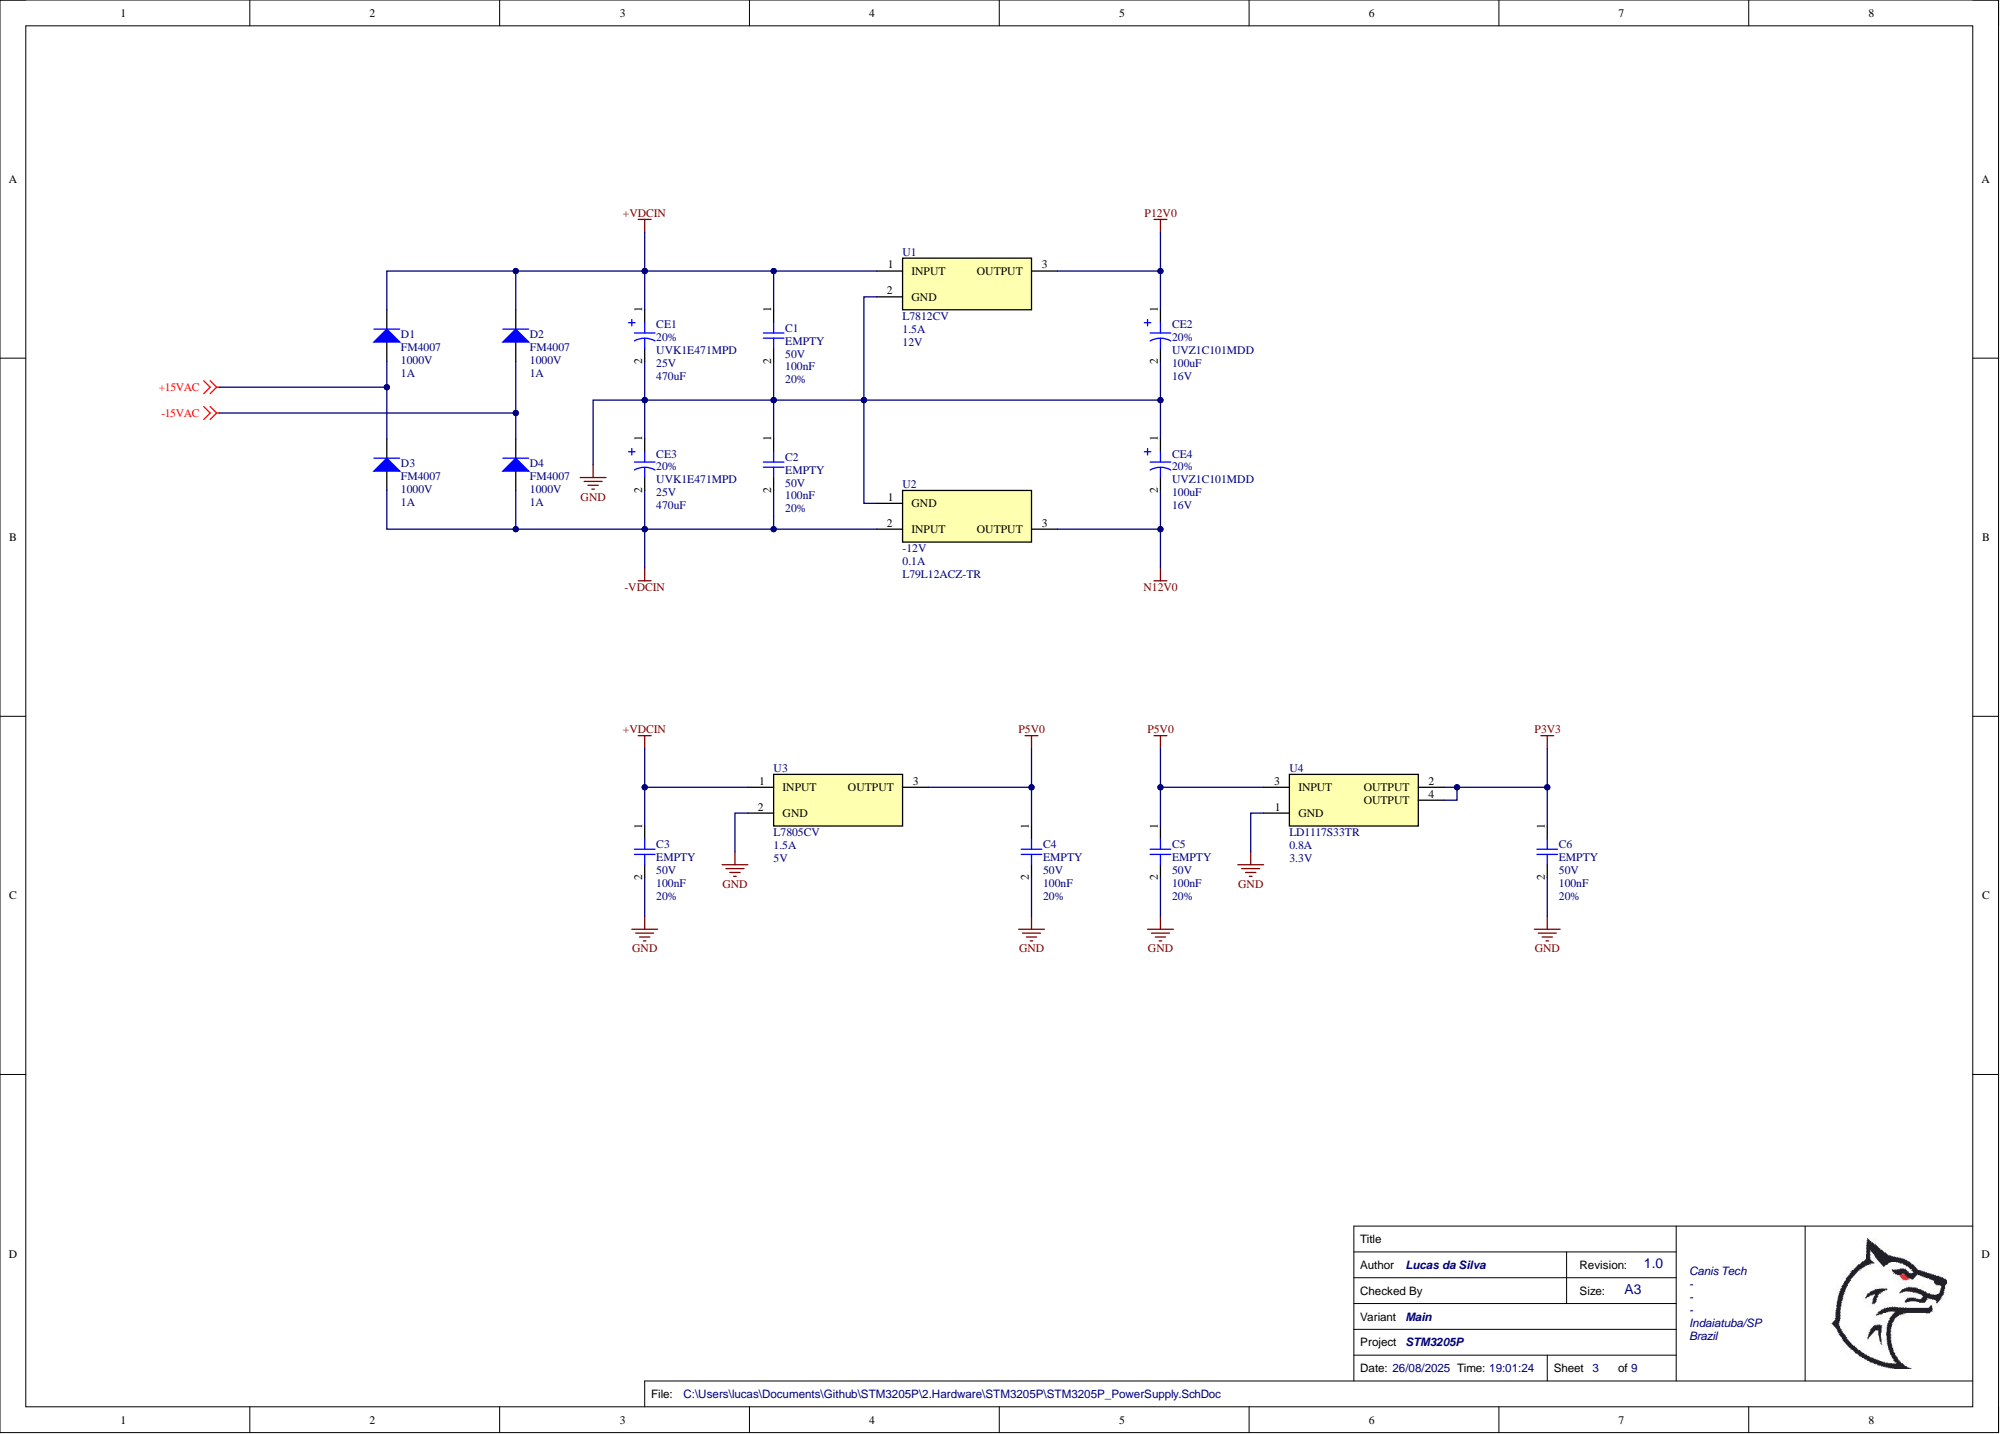
[picture p23: page 3]

Author Lucas da Silva | Revision: 1.0

Checked By | A3 Size:

File: C:\Users\lucas\Documents\Github\STM3205P\2.Hardware\STM3205P\STM3205P_PowerSupply.SchDoc

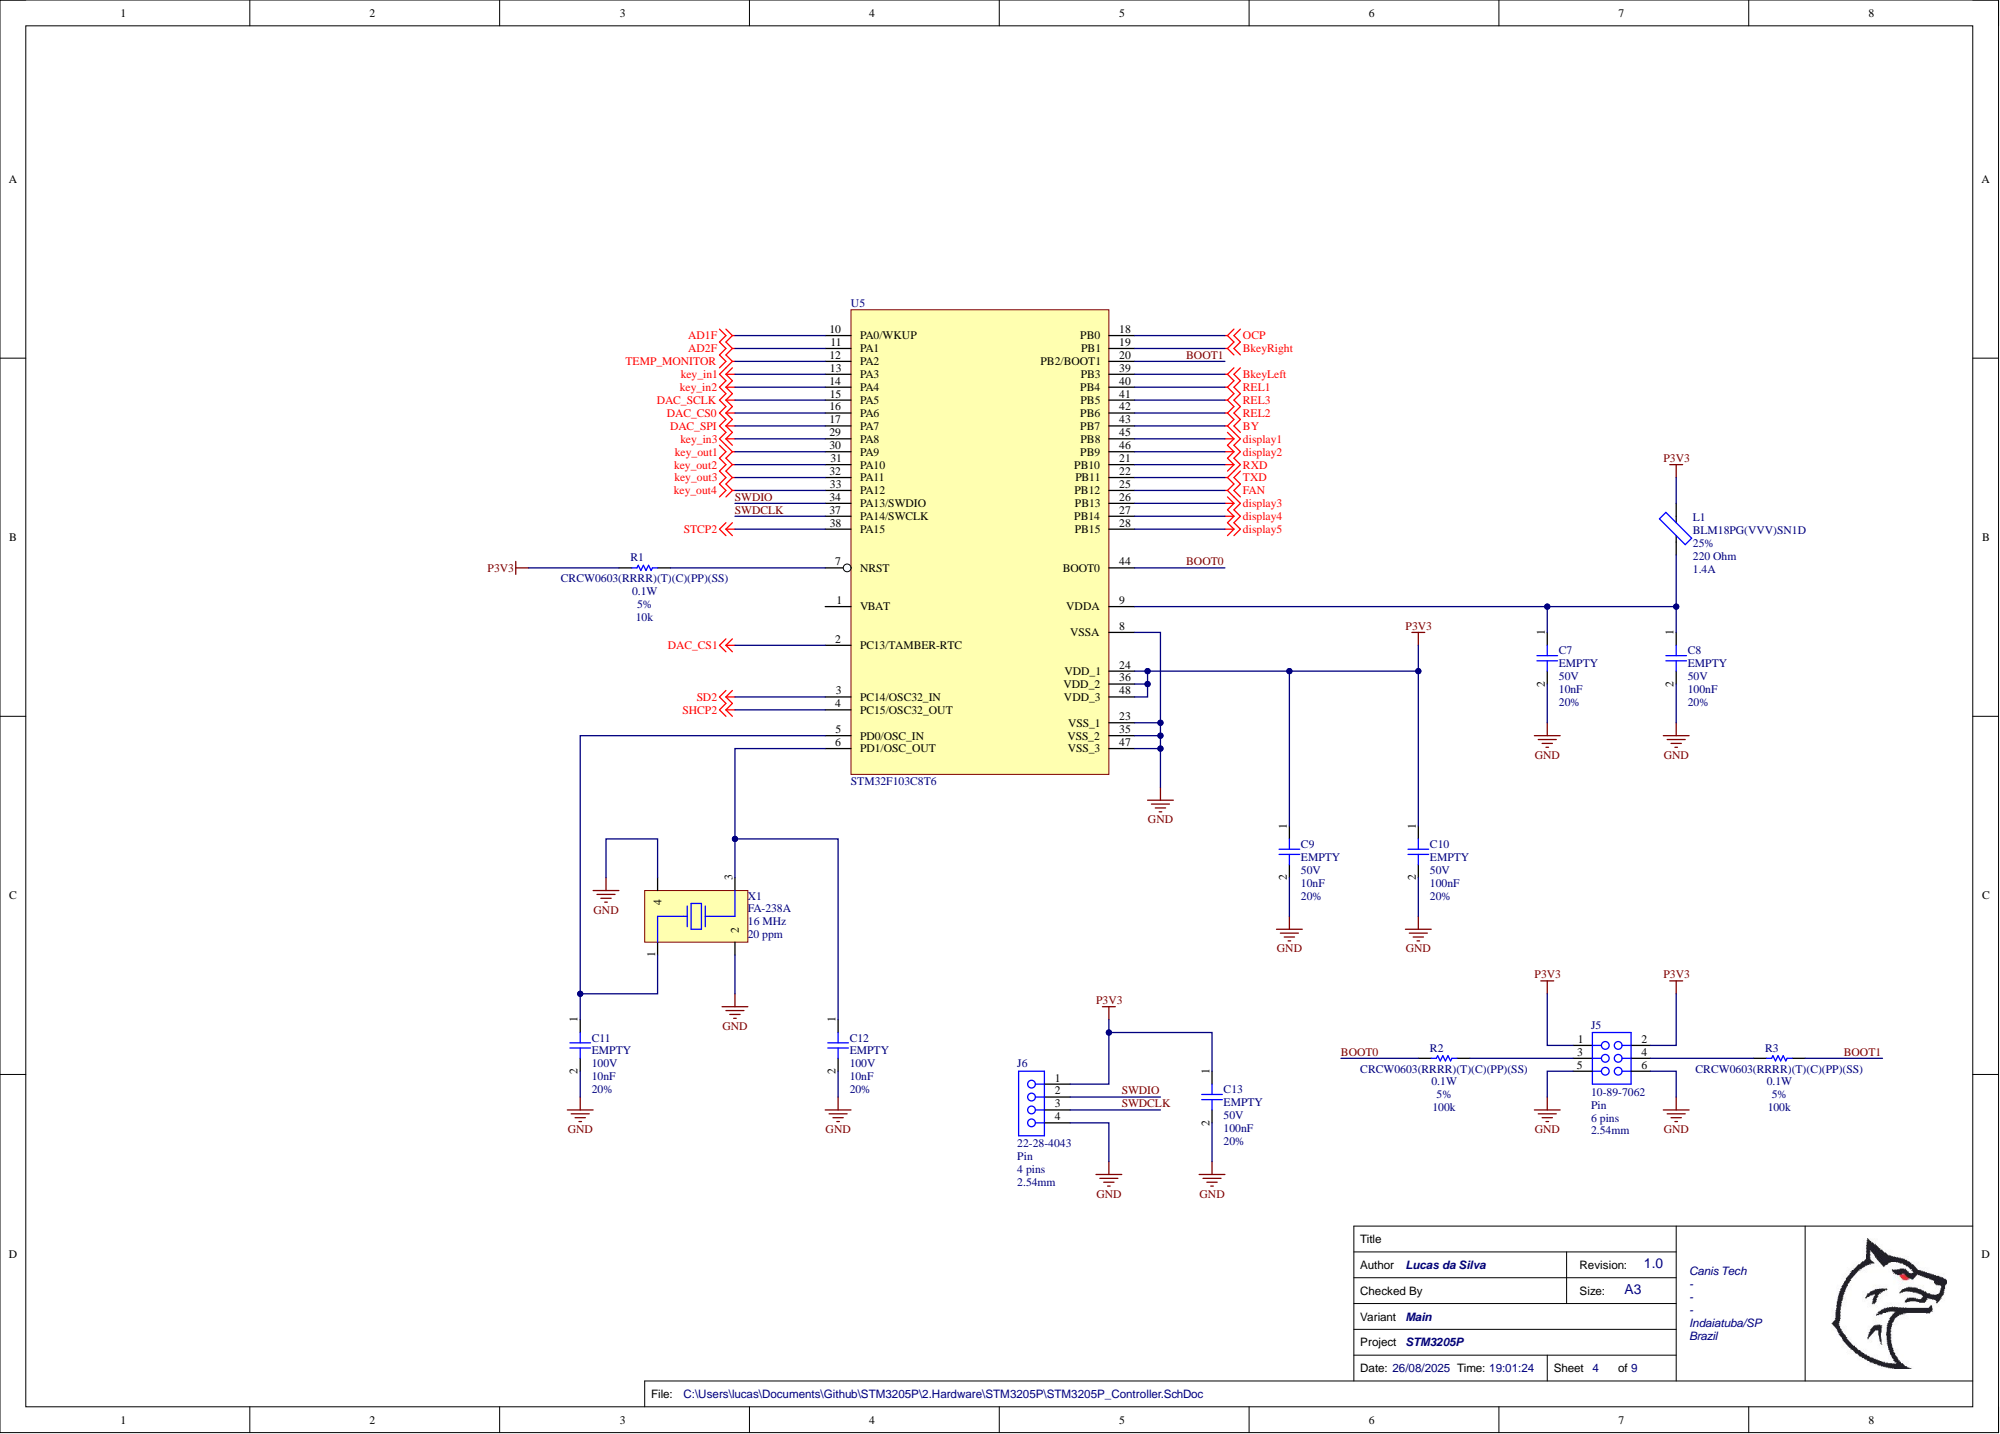
[picture p24: page 4]

Author Lucas da Silva | Revision: 1.0

Checked By | A3 Size:

File: C:\Users\lucas\Documents\Github\STM3205P\2.Hardware\STM3205P\STM3205P_Controller.SchDoc

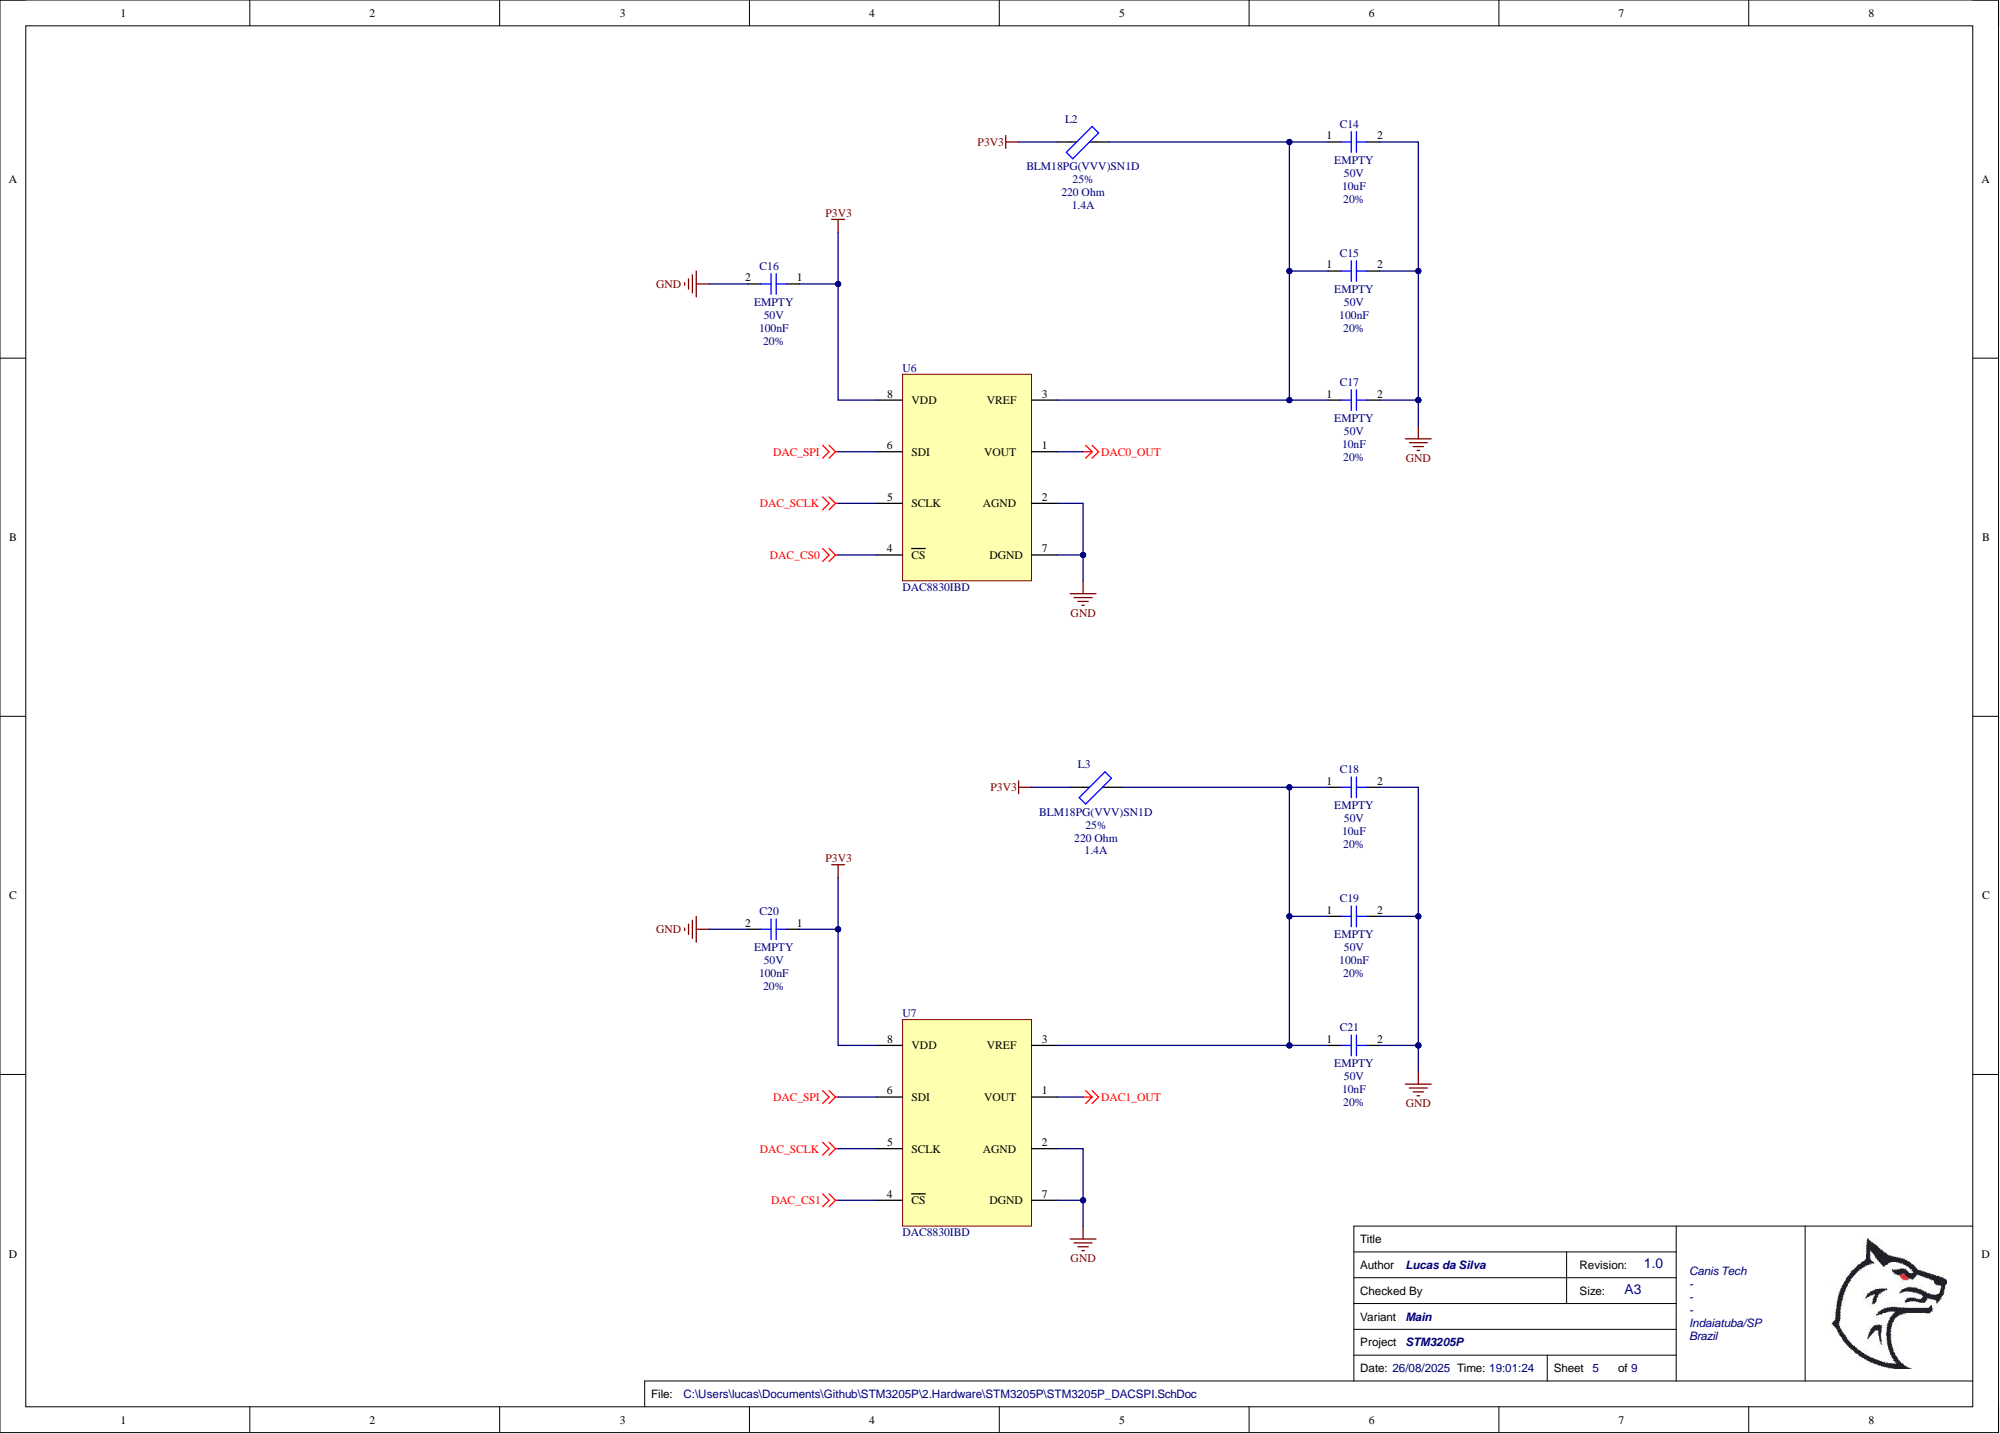
[picture p25: page 5]

Author Lucas da Silva | Revision: 1.0

Checked By | A3 Size:

File: C:\Users\lucas\Documents\Github\STM3205P\2.Hardware\STM3205P\STM3205P_DACSPI.SchDoc

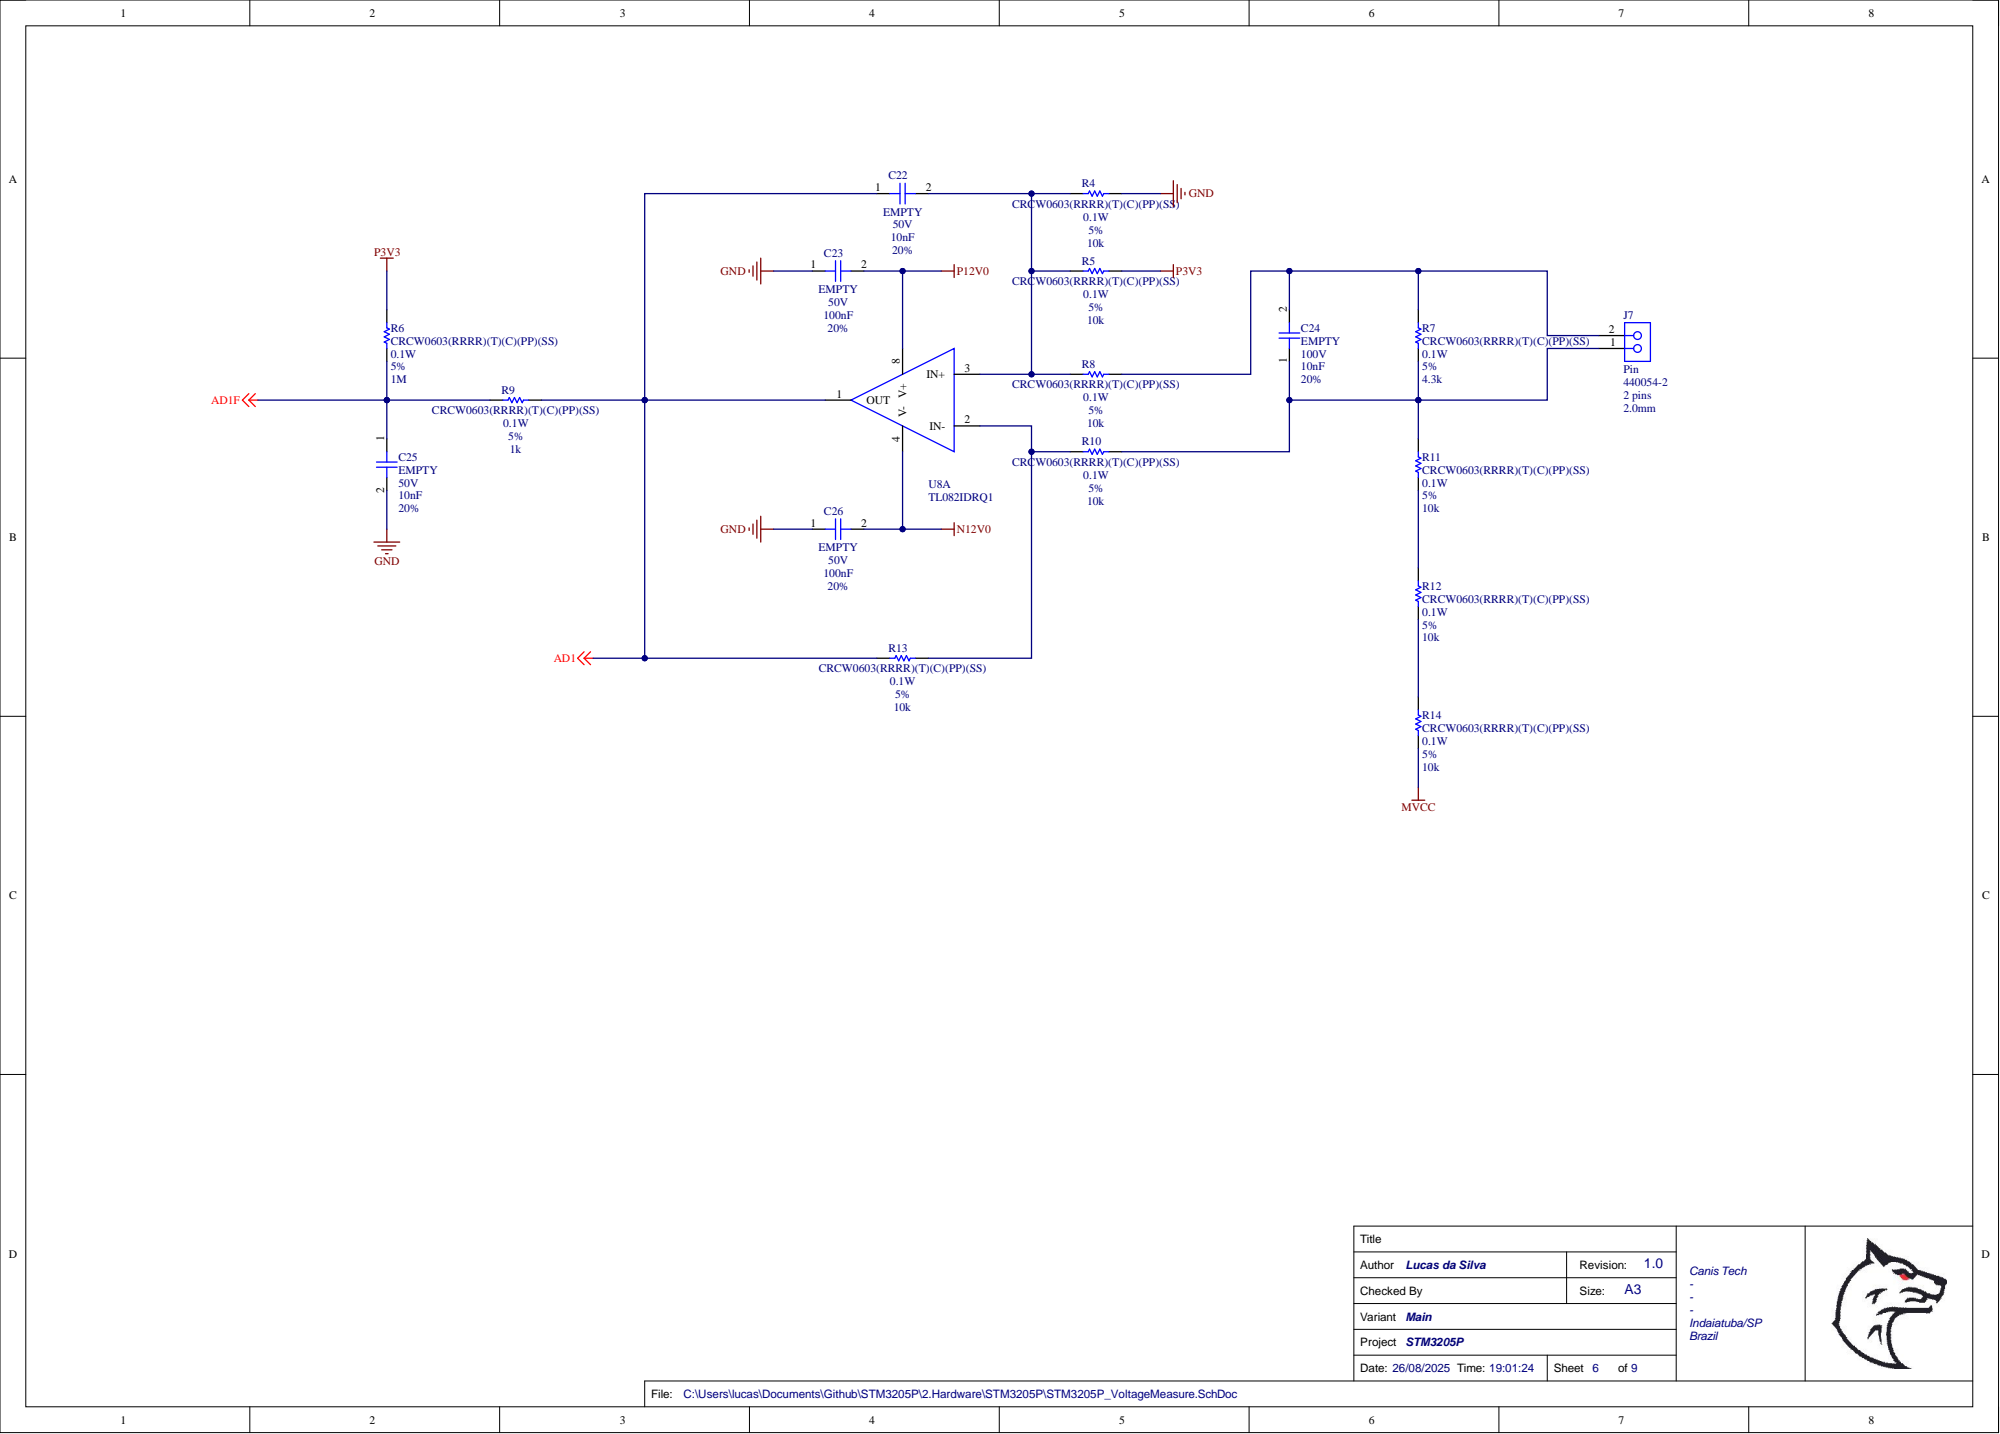
[picture p26: page 6]

Author Lucas da Silva | Revision: 1.0

Checked By | A3 Size:

File: C:\Users\lucas\Documents\Github\STM3205P\2.Hardware\STM3205P\STM3205P_VoltageMeasure.SchDoc

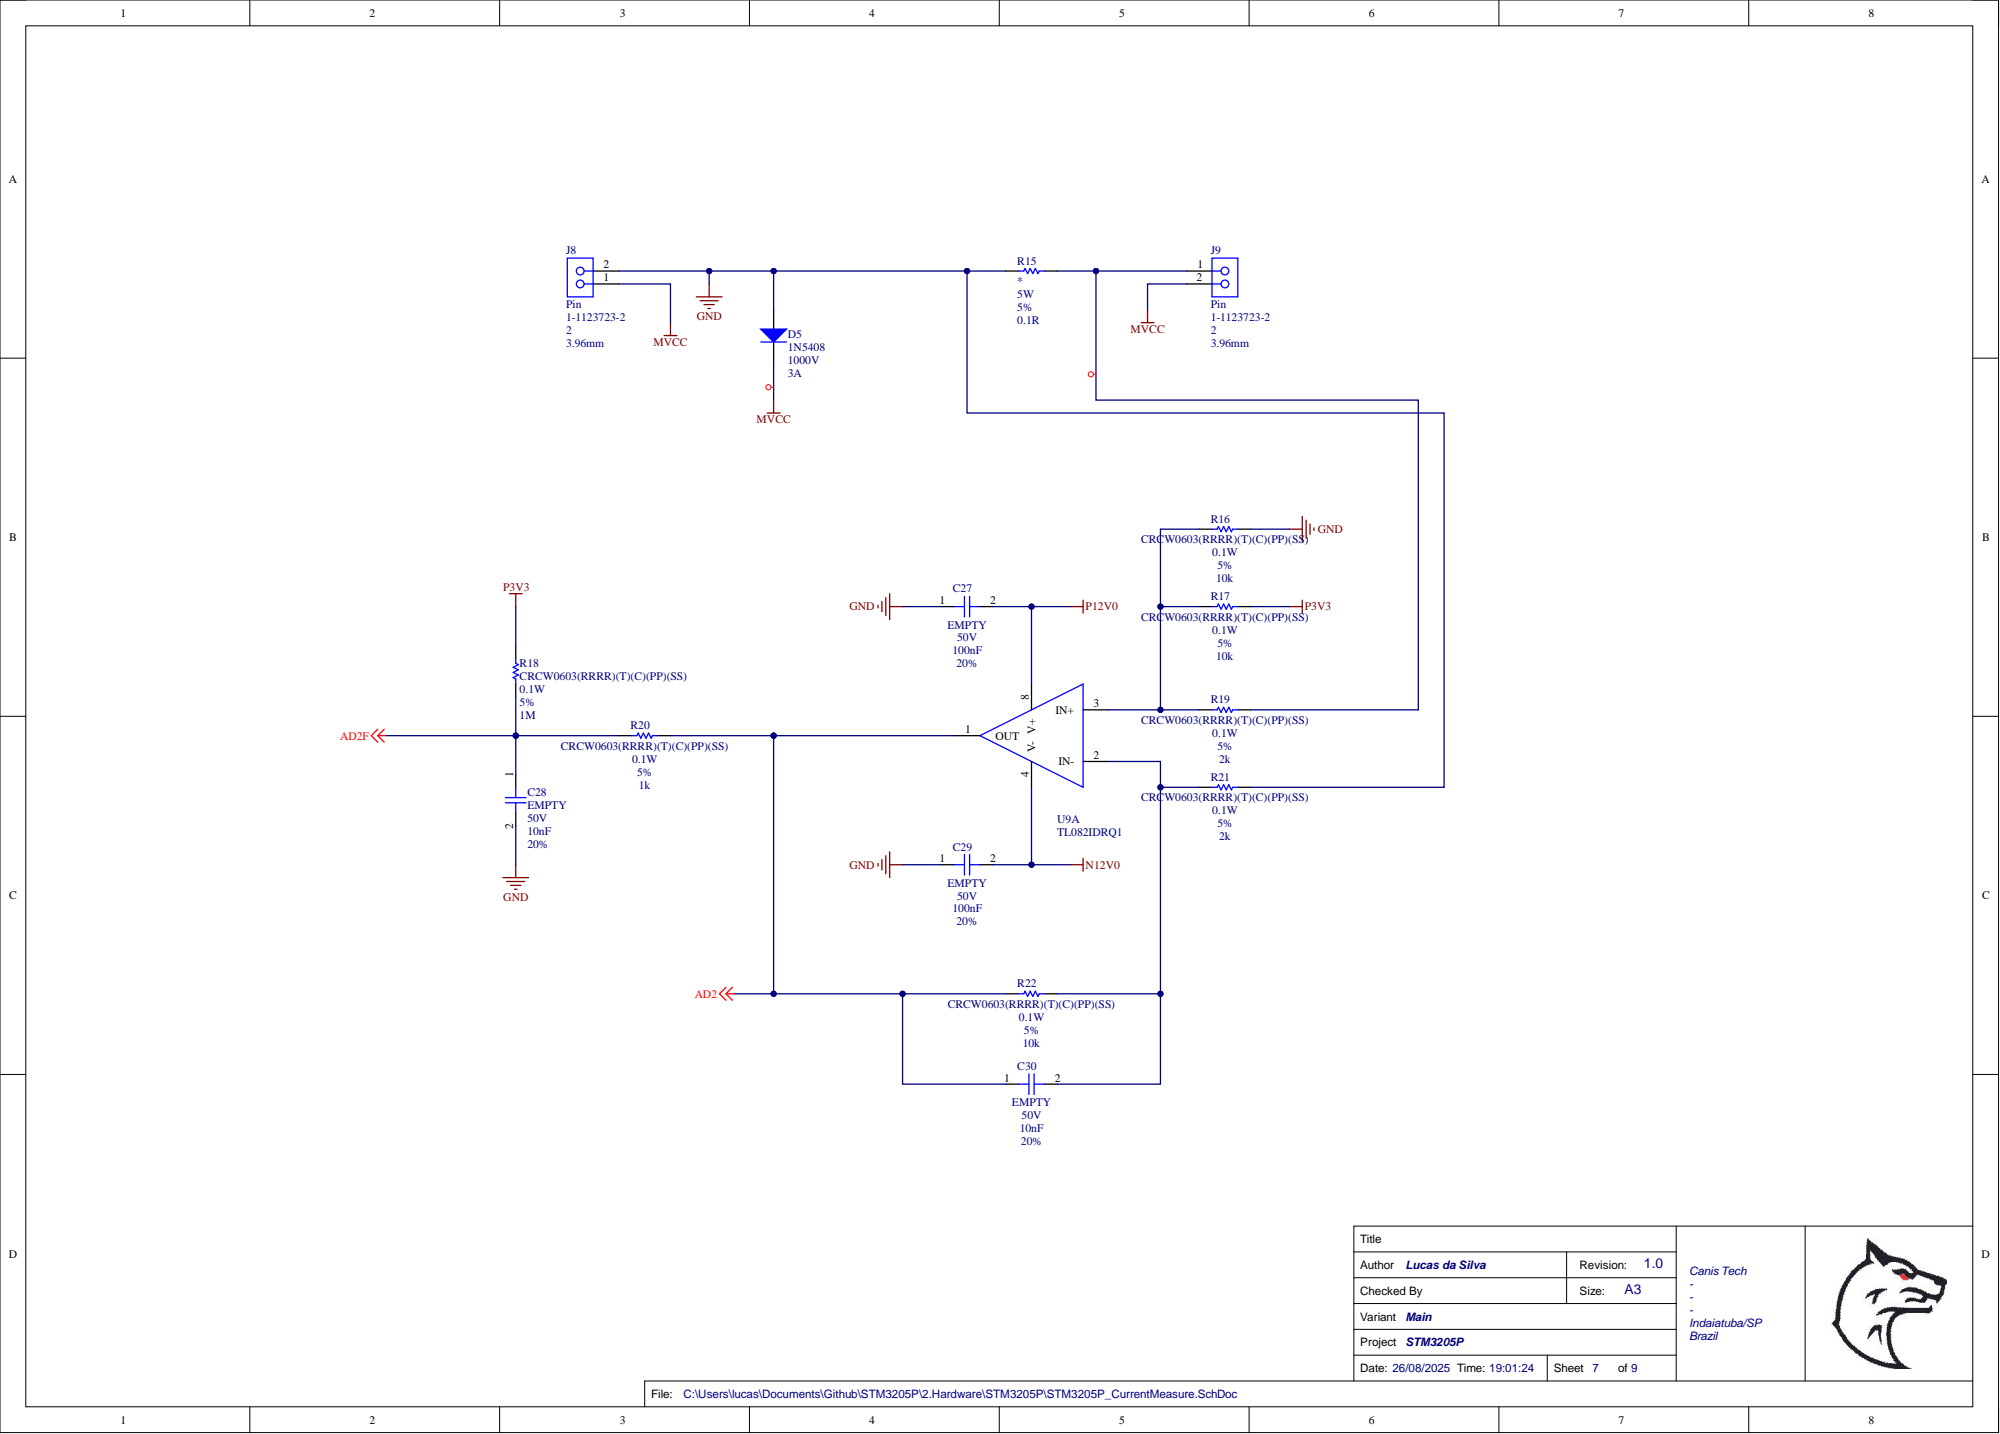
[picture p27: page 7]

Author Lucas da Silva | Revision: 1.0

Checked By | A3 Size:

File: C:\Users\lucas\Documents\Github\STM3205P\2.Hardware\STM3205P\STM3205P_CurrentMeasure.SchDoc

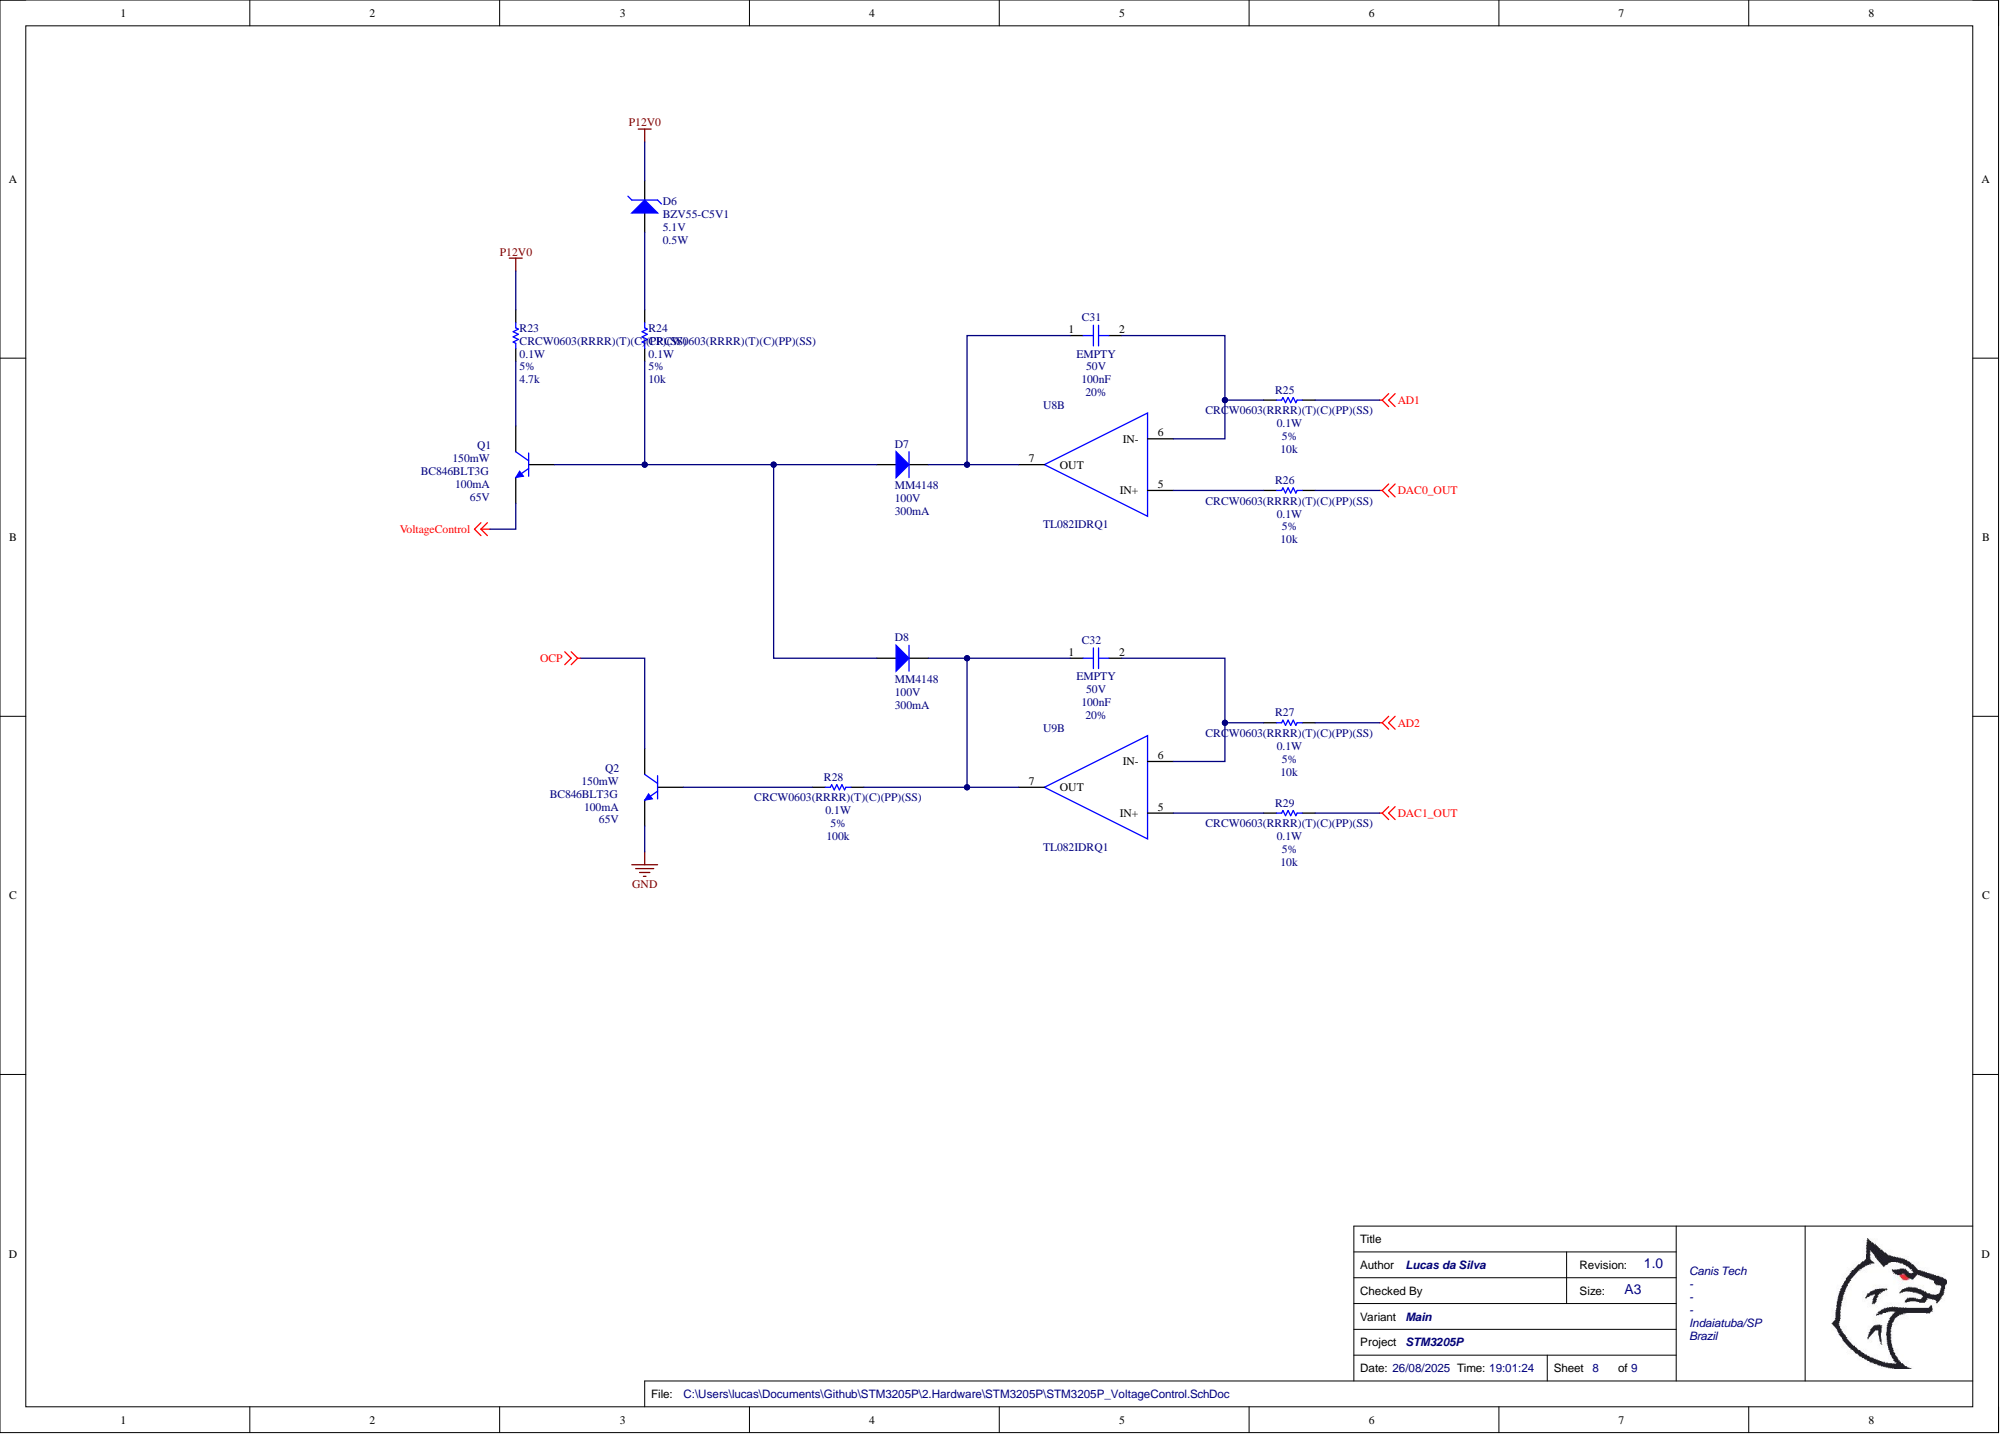
[picture p28: page 8]

Author Lucas da Silva | Revision: 1.0

Checked By | A3 Size:

File: C:\Users\lucas\Documents\Github\STM3205P\2.Hardware\STM3205P\STM3205P_VoltageControl.SchDoc

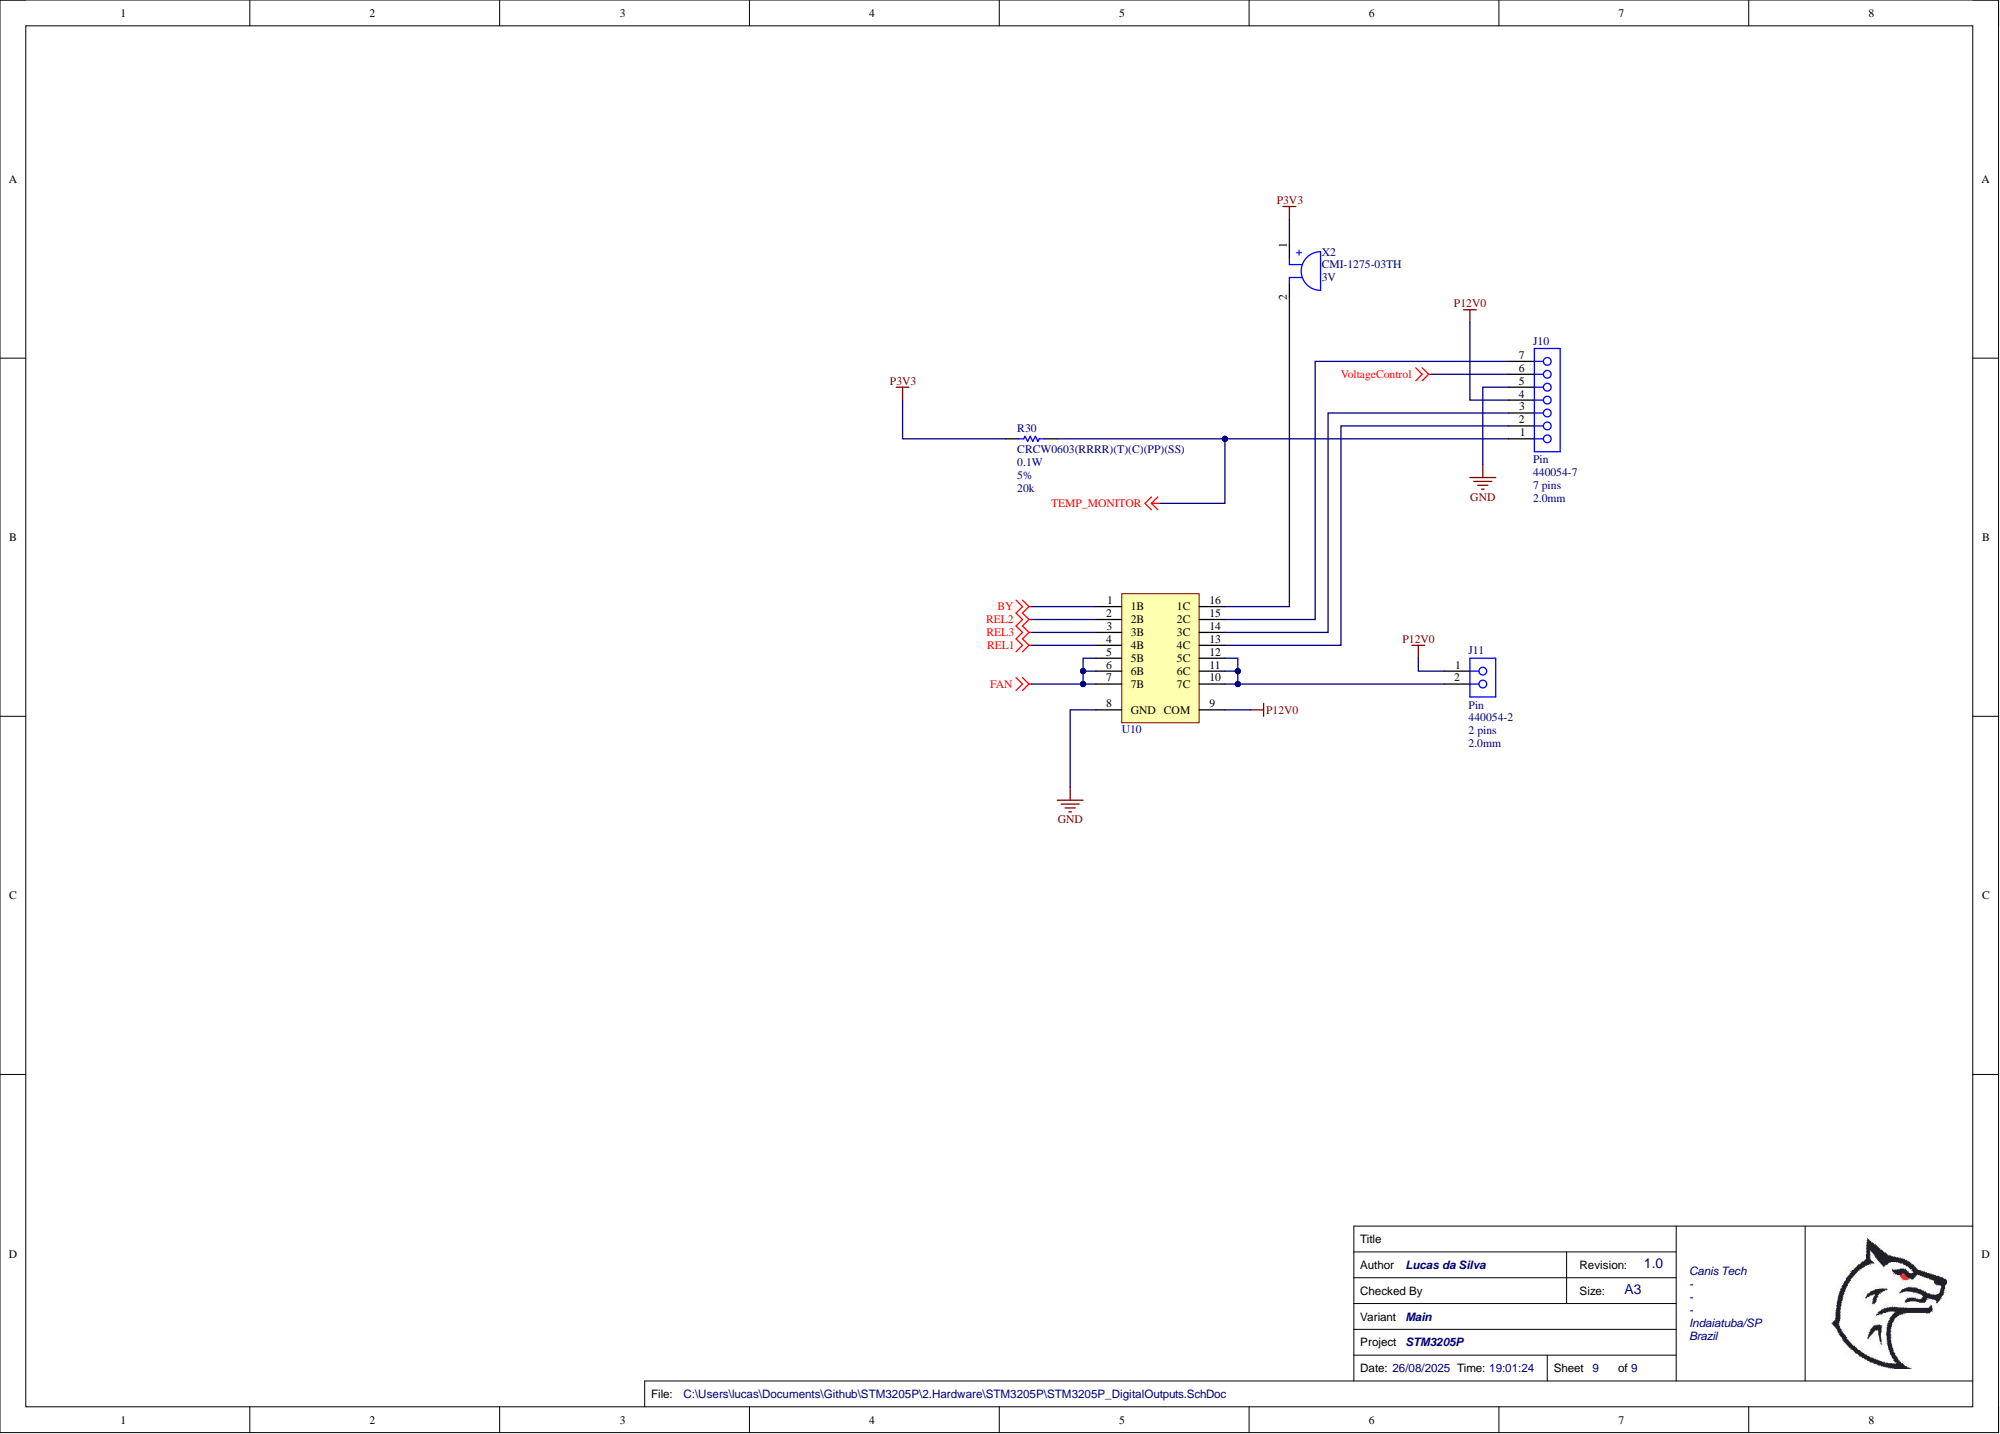
[picture p29: page 9]

Author Lucas da Silva | Revision: 1.0

Checked By | A3 Size:

File: C:\Users\lucas\Documents\Github\STM3205P\2.Hardware\STM3205P\STM3205P_DigitalOutputs.SchDoc
