lucasmoraeseng/STM3205P/6.Simulacoes/PowerBoard/PowerBoard_PowerSectionNew.asc

C1: cap; 100µ
D1: diode; 1N4007
D2: diode; 1N4007
M1: nmos; AON6266E
Q1: npn; 2SCR564F3
Q2: npn; 2SCR564F3
Q3: npn; BC337-40
Q5: pnp; BC856B
Q6: pnp; BC856B
R1: res; 1k
R2: res; 10
R3: res; 1k
R4: res; 10
R5: res; 0.1
R6: res; 0.1
R7: res; 1k
R8: res; 3600
R9: res; 2.2
R10: res; 100
R12: res; 100
U2: LT1359
V1: voltage; 40
V2: voltage; 12
V3: voltage; -12
V5: voltage; PULSE(0 1 10m 500m 500m 1 3)
Named nets: 0, P12V0, N12V0, VOUT, I_meas, Voutref, Vsetpoint
.tran 550m startup
