lucasmoraeseng/STM3205P/6.Simulacoes/PowerBoard/PowerBoard_PowerSection.asc

D1: diode; 1N4007
D2: diode; 1N4007
D3: diode; UMZ5_1N
D4: diode; 1N4148
E1: e; 0.12536
Q1: npn; 2SCR567F3
Q2: npn; 2SCR567F3
Q3: npn; 2SCR514R
Q4: npn; BC546B
R1: res; 1k
R2: res; 10
R3: res; 1k
R4: res; 10
R5: res; 0.1
R6: res; 0.1
R7: res; 1k
R8: res; 4.7k
R9: res; 4.7k
U1: LTC6244
V1: voltage; 27
V2: voltage; 12
V3: voltage; -12
V4: voltage; PULSE(0 3.3 0 1 1 1 4)
Named nets: 0, P12V0, N12V0, VOUT
.tran 1
