lucasmoraeseng/STM3205P/(list of files, drawings)

Other design files:
2.Hardware/LowPowerSymmetricalSupply/LowPowerSymmetricalSupply.PrjPcb
2.Hardware/LowPowerSymmetricalSupply/LPSP_BlockDiagram.SchDoc
2.Hardware/LowPowerSymmetricalSupply/LPSP_N5V0.SchDoc
2.Hardware/LowPowerSymmetricalSupply/LPSP_Title.SchDoc
2.Hardware/LowPowerSymmetricalSupply/LPSP_VoltageInput.SchDoc
2.Hardware/STM3205P/STM3205_SpecialLib.PcbLib
2.Hardware/STM3205P/STM3205P.PrjPcb
2.Hardware/STM3205P/STM3205P_Connectors.SchDoc
2.Hardware/STM3205P/STM3205P_Controller.SchDoc
2.Hardware/STM3205P/STM3205P_CurrentMeasure.SchDoc
2.Hardware/STM3205P/STM3205P_DAC.SchDoc
2.Hardware/STM3205P/STM3205P_DACLogicGates.SchDoc
2.Hardware/STM3205P/STM3205P_DACSPI.SchDoc
2.Hardware/STM3205P/STM3205P_DigitalOutputs.SchDoc
2.Hardware/STM3205P/STM3205P_PCB.PcbDoc
2.Hardware/STM3205P/STM3205P_PowerSupply.SchDoc
2.Hardware/STM3205P/STM3205P_SpecialLib.SchLib
2.Hardware/STM3205P/STM3205P_Title.SchDoc
2.Hardware/STM3205P/STM3205P_VoltageControl.SchDoc
2.Hardware/STM3205P/STM3205P_VoltageMeasure.SchDoc
