lucasmoraeseng/STM3205P/3.Firmware/STM3205P/Core/Src/main.c

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
/* Includes ------------------------------------------------------------------*/
#include "main.h"

/* USER CODE BEGIN Includes */
#include "DAC8830.h"
#include "RingBuffer.h"
#include "button.h"
#include "display.h"
#include "flash.h"
#include "keyboard.h"
#include "led_indicator.h"
#include "stm32f1xx_hal.h"
#include "stm32f1xx_hal_adc.h"

/* USER CODE END Includes */

ADC_HandleTypeDef hadc1;
ADC_HandleTypeDef hadc2;

SPI_HandleTypeDef hspi1;

TIM_HandleTypeDef htim1;
TIM_HandleTypeDef htim2;
TIM_HandleTypeDef htim3;

UART_HandleTypeDef huart1;

/* USER CODE BEGIN PV */
ADC_ChannelConfTypeDef cfgVoltageADC;
ADC_ChannelConfTypeDef cfgCurrentADC;
ADC_ChannelConfTypeDef cfgTemperatureADC;

uint8_t enChangeValue = 0;
uint8_t digitToChange = 0;
uint32_t startBlink = 0;

uint8_t outputState = 0;

RingBuffer_t RBVoltage;
RingBuffer_t RBCurrent;

ADC1_ChannelMode adc1_channel_mode = ADC1_CHANNEL_VOLTAGE;
uint32_t ADC_SampleCounter = 0;
uint32_t lastADCSample = 0;

/* USER CODE END PV */

void SystemClock_Config(void);
static void MX_GPIO_Init(void);
static void MX_ADC1_Init(void);
static void MX_ADC2_Init(void);
static void MX_TIM1_Init(void);
static void MX_USART1_UART_Init(void);
static void MX_TIM2_Init(void);
static void MX_SPI1_Init(void);
static void MX_TIM3_Init(void);
/* USER CODE BEGIN 0 */
void HAL_TIM_PeriodElapsedCallback(TIM_HandleTypeDef *htim)
{
    if(htim->Instance == TIM1)
    {
    }
    else if(htim->Instance == TIM2)
    {
        display.frame_cnt++;
        if(display.frame_cnt % 512 == 0)
        {
            display.blink_state = !display.blink_state;
        }

        if(display.frame_cnt % 10 == 0)
        {
            HAL_ADC_Start_IT(&hadc1); // Start ADC1 with interruption
            HAL_ADC_Start_IT(&hadc2); // Start ADC2 with interruption
        }

        if((display.frame_cnt + 5) % 100 == 0)
        {
            HAL_ADC_ConfigChannel(&hadc1, &cfgTemperatureADC);
            adc1_channel_mode = ADC1_CHANNEL_TEMPERATURE;
        }

        if((display.frame_cnt + 6) % 100 == 0)
        {
            HAL_ADC_ConfigChannel(&hadc1, &cfgVoltageADC);
            adc1_channel_mode = ADC1_CHANNEL_VOLTAGE;
        }

        if(display.beep)
        {
            display.beep_cnt++;
        }

        if(display.beep_cnt > display.beep_duration)
        {
            display.beep_cnt = 0;
            display.beep = 0;
            HAL_GPIO_WritePin(BY_GPIO_Port, BY_Pin, GPIO_PIN_RESET);
        }

        Display_Update(&display);
    }
    else if(htim->Instance == TIM3)
    {
        if(display.beep)
        {
            display.beep_phase += display.beep_increment;

            if(display.beep_phase & 0x8000)
            {
                HAL_GPIO_WritePin(
                    BY_GPIO_Port,
                    BY_Pin,
                    GPIO_PIN_SET);
            }
            else
            {
                HAL_GPIO_WritePin(
                    BY_GPIO_Port,
                    BY_Pin,
                    GPIO_PIN_RESET);
            }
        }
    }
}

void HAL_ADC_ConvCpltCallback(ADC_HandleTypeDef *hadc)
{
    if(hadc->Instance == ADC1)
    {
        uint16_t value1 = HAL_ADC_GetValue(&hadc1);
        if(adc1_channel_mode == ADC1_CHANNEL_VOLTAGE)
        {
            // RingBuffer_Put(&RBVoltage, (RBDataType)value1);
            measuredData.Voltage = value1;
        }
        else if(adc1_channel_mode == ADC1_CHANNEL_TEMPERATURE)
        {
            // RingBuffer_Put(&RBTemperature, (RBDataType)value1);
        }
        ADC_SampleCounter++;
    }
    else if(hadc->Instance == ADC2)
    {
        uint16_t value2 = HAL_ADC_GetValue(&hadc2);
        // RingBuffer_Put(&RBCurrent, (RBDataType)value2);
        measuredData.Current = value2;
    }
}

/* USER CODE END 0 */

/**
 * @brief  The application entry point.
 * @retval int
 */
int main(void)
{

    /* USER CODE BEGIN 1 */

    Flash_ReadSettings(&flashData);

    cfgVoltageADC.Channel = ADC_CHANNEL_1;
    cfgVoltageADC.Rank = ADC_REGULAR_RANK_1;
    cfgVoltageADC.SamplingTime = ADC_SAMPLETIME_1CYCLE_5;

    cfgCurrentADC.Channel = ADC_CHANNEL_2;
    cfgCurrentADC.Rank = ADC_REGULAR_RANK_1;
    cfgCurrentADC.SamplingTime = ADC_SAMPLETIME_1CYCLE_5;

    cfgTemperatureADC.Channel = ADC_CHANNEL_3;
    cfgTemperatureADC.Rank = ADC_REGULAR_RANK_1;
    cfgTemperatureADC.SamplingTime = ADC_SAMPLETIME_1CYCLE_5;

    /* USER CODE END 1 */

    /* MCU Configuration--------------------------------------------------------*/

    /* Reset of all peripherals, Initializes the Flash interface and the Systick. */
    HAL_Init();

    /* USER CODE BEGIN Init */
    Display_Init(&display);

    LedIndicator_Set(&display.ledM1);

    actualData.Voltage = flashData.memory1.Voltage;
    actualData.Current = flashData.memory1.Current;
    actualData.OCP = flashData.memory1.OCP;
    actualData.OVP = flashData.memory1.OVP;

    Display_PrepareDataACCX3(&display, actualData);

    // display.blink_display = 2;
    // display.blink_index = 1;

    Keyboard_Init(&Keyboard);

    /* USER CODE END Init */

    /* Configure the system clock */
    SystemClock_Config();

    /* Initialize all configured peripherals */
    MX_GPIO_Init();
    MX_ADC1_Init();
    MX_ADC2_Init();
    MX_TIM1_Init();
    MX_USART1_UART_Init();
    MX_TIM2_Init();
    MX_SPI1_Init();
    MX_TIM3_Init();
    /* USER CODE BEGIN 2 */

    HAL_ADC_ConfigChannel(&hadc1, &cfgVoltageADC);
    HAL_ADC_ConfigChannel(&hadc2, &cfgCurrentADC);
    // HAL_ADC_Start_DMA(&hadc1, (uint32_t *)ADC1_Buffer, 2);
    // HAL_ADC_Start_DMA(&hadc2, (uint32_t *)ADC2_Buffer, 1);

    HAL_TIM_OC_Start(&htim2, TIM_CHANNEL_2);
    HAL_TIM_Base_Start_IT(&htim2); // Timer with interruption
    HAL_TIM_Base_Start_IT(&htim3); // Timer with interruption

    /* USER CODE END 2 */

    /* Infinite loop */
    /* USER CODE BEGIN WHILE */
    while(1)
    {
        Keyboard_Read(&Keyboard, display.frame_cnt);

        if(outputState)
        {
            if(lastADCSample != ADC_SampleCounter)
            {
                lastADCSample = ADC_SampleCounter;
                Display_PrepareDataACCX3(&display, measuredData);
            }

            if(Button_KeyUpEvent(&Keyboard.OCP))
            {
                measuredData.OCP = !measuredData.OCP;
                LedIndicator_WriteValue(&display.ledOCP, measuredData.OCP);
                if(flashData.beep)
                {
                    Buzzer_Play(&display, BUZZER_TONE_A4, 100);
                }
            }

            if(Button_KeyUpEvent(&Keyboard.OVP))
            {
                measuredData.OVP = !measuredData.OVP;
                LedIndicator_WriteValue(&display.ledOVP, measuredData.OVP);
                if(flashData.beep)
                {
                    Buzzer_Play(&display, BUZZER_TONE_A4, 100);
                }
            }
        }
        else
        {
            if(Button_KeyUpEvent(&Keyboard.M1))
            {
                enChangeValue = false;
                display.blink_display = 0;
                Display_ClearMemoryLeds(&display);
                LedIndicator_Set(&display.ledM1);
                // LedIndicator_Blink(&display.ledM1, display.frame_cnt);
                actualData = flashData.memory1;
                Display_PrepareDataACCX3(&display, actualData);
                if(flashData.beep)
                {
                    Buzzer_Play(&display, BUZZER_TONE_B4, 100);
                }
            }

            if(Button_KeyPressedTimeEvent(&Keyboard.M1, display.frame_cnt, 5000))
            {
                enChangeValue = false;
                display.blink_display = 0;
                flashData.memory1 = actualData;
                Flash_WriteSettings(&flashData);
                LedIndicator_Blink(&display.ledM1, display.frame_cnt);

                if(flashData.beep)
                {
                    Buzzer_Play(&display, BUZZER_TONE_B4, 500);
                }
            }

            if(Button_KeyUpEvent(&Keyboard.M2))
            {
                enChangeValue = false;
                display.blink_display = 0;
                Display_ClearMemoryLeds(&display);
                LedIndicator_Set(&display.ledM2);
                actualData = flashData.memory2;
                Display_PrepareDataACCX3(&display, actualData);
                if(flashData.beep)
                {
                    Buzzer_Play(&display, BUZZER_TONE_C4, 100);
                }
            }

            if(Button_KeyPressedTimeEvent(&Keyboard.M2, display.frame_cnt, 5000))
            {
                enChangeValue = false;
                display.blink_display = 0;
                flashData.memory2 = actualData;
                Flash_WriteSettings(&flashData);
                LedIndicator_Blink(&display.ledM2, display.frame_cnt);

                if(flashData.beep)
                {
                    Buzzer_Play(&display, BUZZER_TONE_C4, 500);
                }
            }

            if(Button_KeyUpEvent(&Keyboard.M3))
            {
                enChangeValue = false;
                display.blink_display = 0;
                Display_ClearMemoryLeds(&display);
                LedIndicator_Set(&display.ledM3);
                actualData = flashData.memory3;
                Display_PrepareDataACCX3(&display, actualData);
                if(flashData.beep)
                {
                    Buzzer_Play(&display, BUZZER_TONE_D4, 100);
                }
            }

            if(Button_KeyPressedTimeEvent(&Keyboard.M3, display.frame_cnt, 5000))
            {
                enChangeValue = false;
                display.blink_display = 0;
                flashData.memory3 = actualData;
                Flash_WriteSettings(&flashData);
                LedIndicator_Blink(&display.ledM3, display.frame_cnt);

                if(flashData.beep)
                {
                    Buzzer_Play(&display, BUZZER_TONE_D4, 500);
                }
            }

            if(Button_KeyUpEvent(&Keyboard.M4))
            {
                enChangeValue = false;
                display.blink_display = 0;
                Display_ClearMemoryLeds(&display);
                LedIndicator_Set(&display.ledM4);
                actualData = flashData.memory4;
                Display_PrepareDataACCX3(&display, actualData);
                if(flashData.beep)
                {
                    Buzzer_Play(&display, BUZZER_TONE_E4, 100);
                }
            }

            if(Button_KeyPressedTimeEvent(&Keyboard.M4, display.frame_cnt, 5000))
            {
                enChangeValue = false;
                display.blink_display = 0;
                flashData.memory4 = actualData;
                Flash_WriteSettings(&flashData);
                LedIndicator_Blink(&display.ledM4, display.frame_cnt);

                if(flashData.beep)
                {
                    Buzzer_Play(&display, BUZZER_TONE_E4, 500);
                }
            }

            if(Button_KeyUpEvent(&Keyboard.OCP))
            {
                actualData.OCP = !actualData.OCP;
                LedIndicator_WriteValue(&display.ledOCP, actualData.OCP);
                if(flashData.beep)
                {
                    Buzzer_Play(&display, BUZZER_TONE_A4, 100);
                }
            }

            if(Button_KeyUpEvent(&Keyboard.OVP))
            {
                actualData.OVP = !actualData.OVP;
                LedIndicator_WriteValue(&display.ledOVP, actualData.OVP);
                if(flashData.beep)
                {
                    Buzzer_Play(&display, BUZZER_TONE_A4, 100);
                }
            }

            if(Button_KeyUpEvent(&Keyboard.VoltageCurrent))
            {
                if(enChangeValue)
                {
                    if(display.blink_display == 1)
                    {
                        display.blink_display = 2;
                    }
                    else
                    {
                        display.blink_display = 1;
                    }
                }
                else
                {
                    enChangeValue = true;
                    display.blink_display = 1;
                    display.blink_index = 1;
                }

                startBlink = display.frame_cnt;
                if(flashData.beep)
                {
                    Buzzer_Play(&display, BUZZER_TONE_A4, 100);
                }
            }

            if(Button_KeyUpEvent(&Keyboard.LeftArrow))
            {
                if(enChangeValue)
                {
                    if(display.blink_index > 1)
                    {
                        display.blink_index--;
                    }
                }
                startBlink = display.frame_cnt;
                if(flashData.beep)
                {
                    Buzzer_Play(&display, BUZZER_TONE_A4, 100);
                }
            }

            if(Button_KeyUpEvent(&Keyboard.RightArrow))
            {
                if(enChangeValue)
                {
                    if(display.blink_index < 4)
                    {
                        display.blink_index++;
                    }
                }
                startBlink = display.frame_cnt;
                if(flashData.beep)
                {
                    Buzzer_Play(&display, BUZZER_TONE_A4, 100);
                }
            }

            if(enChangeValue)
            {
                if(display.frame_cnt - startBlink > 10000)
                {
                    enChangeValue = false;
                    display.blink_display = 0;
                }

                if(Keyboard.DialValue != 0)
                {
                    startBlink = display.frame_cnt;
                    if(display.blink_display == 2)
                    {
                        Keyboard_ValueAdjust(&Keyboard,
                                             display.blink_index,
                                             &actualData.Voltage,
                                             VOLTAGE_LIMIT_SUPERIOR,
                                             VOLTAGE_LIMIT_INFERIOR);
                    }
                    else if(display.blink_display == 1)
                    {
                        Keyboard_ValueAdjust(&Keyboard,
                                             display.blink_index,
                                             &actualData.Current,
                                             CURRENT_LIMIT_SUPERIOR,
                                             CURRENT_LIMIT_INFERIOR);
                    }

                    Display_PrepareDataACCX3(&display, actualData);
                }
            }
        }

        if(Button_KeyPressedTimeEvent(&Keyboard.Lock, display.frame_cnt, 5000))
        {
            flashData.beep = !flashData.beep;
            Buzzer_Play(&display, BUZZER_TONE_C5, 500);
            Flash_WriteSettings(&flashData);
        }

        if(Button_KeyUpEvent(&Keyboard.OnOff))
        {
            enChangeValue = false;
            display.blink_display = 0;
            outputState = !outputState;
            LedIndicator_WriteValue(&display.ledOUT, outputState);
            measuredData.OCP = actualData.OCP;
            measuredData.OVP = actualData.OVP;

            if(outputState)
            {
                Display_PrepareDataACCX3(&display, measuredData);
            }
            else
            {
                Display_PrepareDataACCX3(&display, actualData);
            }

            if(flashData.beep)
            {
                Buzzer_Play(&display, BUZZER_TONE_B3, 100);
            }
        }

        /* USER CODE END WHILE */

        /* USER CODE BEGIN 3 */
    }
    /* USER CODE END 3 */
}

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
