lucasmoraeseng/STM3205P/(commit log)

2025-08-14 added schematic pages
    [STM3205P.PrjPcb, STM3205P_Connectors.SchDoc, STM3205P_Controller.SchDoc, STM3205P_DAC.SchDoc, STM3205P_PowerSupply.SchDoc, STM3205P_Title.SchDoc]
2025-08-14 Added old schematic
2025-08-17 Finished DAC circuit
    [STM3205P.PrjPcb, STM3205P_Connectors.SchDoc, STM3205P_DAC.SchDoc, STM3205P_DACLogicGates.SchDoc, STM3205P_PowerSupply.SchDoc]
2025-08-17 added page for measure
    [STM3205P.PrjPcb, STM3205P_DAC.SchDoc, STM3205P_Measure.SchDoc]
2025-08-17 Added digital output circuit
    [STM3205P.PrjPcb, STM3205P_Connectors.SchDoc, STM3205P_CurrentMeasure.SchDoc, STM3205P_DAC.SchDoc, STM3205P_DACLogicGates.SchDoc, STM3205P_DigitalOutputs.SchDoc, STM3205P_Measure.SchDoc, STM3205P_VoltageControl.SchDoc]
2025-08-18 Added controller
    [STM3205P.PrjPcb, STM3205P_Connectors.SchDoc, STM3205P_Controller.SchDoc, STM3205P_CurrentMeasure.SchDoc, STM3205P_DigitalOutputs.SchDoc, STM3205P_SpecialLib.SchLib, STM3205_SpecialLib.PcbLib]
2025-08-19 Added controller to project
    [STM3205P_Controller.SchDoc]
2025-08-20 Changed DAC
    [STM3205P.PrjPcb, STM3205P_DACSPI.SchDoc]
2025-08-20 Added pcb definitions
    [STM3205P.PrjPcb, STM3205P_Connectors.SchDoc, STM3205P_Controller.SchDoc, STM3205P_CurrentMeasure.SchDoc, STM3205P_DACSPI.SchDoc, STM3205P_DigitalOutputs.SchDoc, STM3205P_PCB.PcbDoc, STM3205P_PowerSupply.SchDoc]
2025-08-24 Review cap sizes
    [STM3205P_PCB.PcbDoc]
2025-08-25 Changed Cap to miniature cap
    [STM3205P_Connectors.SchDoc, STM3205P_PCB.PcbDoc, STM3205P_PowerSupply.SchDoc]
2025-08-25 Continue placement
    [STM3205P.PrjPcb, STM3205P_PCB.PcbDoc, STM3205P_PowerSupply.SchDoc]
2025-08-27 changed op amp to 4 ch
    [STM3205P_CurrentMeasure.SchDoc, STM3205P_PCB.PcbDoc, STM3205P_VoltageControl.SchDoc, STM3205P_VoltageMeasure.SchDoc]
2025-08-29 Repinning controller
    [STM3205P_Controller.SchDoc, STM3205P_PCB.PcbDoc]
2025-08-30 Continue routing
    [STM3205P_Controller.SchDoc, STM3205P_PCB.PcbDoc]
2025-08-31 Changed name on current measure
    [STM3205P_CurrentMeasure.SchDoc, STM3205P_PCB.PcbDoc, STM3205P_VoltageControl.SchDoc]
2025-08-31 Finished routing
    missing add vias on ground plane
    [ResistorCoil.SLDPRT, ResistorCoil.STEP, STM3205P.PrjPcb, STM3205P_Controller.SchDoc, STM3205P_VoltageMeasure.SchDoc, STM3205_SpecialLib.PcbLib]
2025-08-31 Generated Output Files
    [STM3205P_Connectors.SchDoc, STM3205P_CurrentMeasure.SchDoc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]
2025-10-05 Update STM3205P schematic documents
    Modified multiple schematic files for the STM3205P hardware, including connectors, current measurement, digital outputs, voltage control, and voltage measurement. Refer to the updated .SchDoc files for specific changes.
    [STM3205P_Connectors.SchDoc, STM3205P_CurrentMeasure.SchDoc, STM3205P_DigitalOutputs.SchDoc, STM3205P_VoltageControl.SchDoc, STM3205P_VoltageMeasure.SchDoc]
2025-10-06 Add STM32F1 firmware project and documentation
    Initial commit of STM3205P firmware project, including source code, STM32 HAL and CMSIS drivers, project configuration files, and hardware schematic. Also adds related documentation and IDE metadata.
    [DisplayBIts.xlsx, STM3205P_Controller.SchDoc]
2025-10-07 Update STM32 project source and configuration files
    Modified STM32CubeIDE project files, including main.c, interrupt handlers, and hardware abstraction layer initialization. Updated the .ioc configuration and several metadata and index files, reflecting changes in project structure and settings.
2025-10-08 Update schematics and firmware project files
    Updated STM3205P current and voltage measurement schematics. Firmware project metadata and build outputs were also updated, reflecting recent development activity and project changes.
    [STM3205P_CurrentMeasure.SchDoc, STM3205P_VoltageMeasure.SchDoc]
2025-10-09 Add RingBuffer module and update main.c
    Introduced new RingBuffer.c and RingBuffer.h source files for the STM3205P project. Updated main.c to integrate the ring buffer functionality. Also includes related build artifacts and metadata updates.
2025-10-12 Add ADCTest STM32 project and update metadata
    Introduced a new ADCTest project for STM32F103C8T6, including all source, header, configuration, and build files. Updated Eclipse workspace metadata and logs to reflect the addition and recent activity. Existing STM3205P project files and build outputs were also updated.
2025-10-14 Add Low Power Symmetrical Supply hardware project
    Added new Altium project and schematic files for the Low Power Symmetrical Supply, including block diagram, voltage input, and -5V sections. This establishes the initial hardware design structure for the LPSP module.
    [LPSP_BlockDiagram.SchDoc, LPSP_N5V0.SchDoc, LPSP_Title.SchDoc, LPSP_VoltageInput.SchDoc, LowPowerSymmetricalSupply.PrjPcb]
2025-10-15 Add LowPowerSymmetricalSupply project structure and update schematics
    Added the LowPowerSymmetricalSupply.PrjPcbStructure file for the new hardware project. Updated STM3205P_Controller.SchDoc and STM3205P_DigitalOutputs.SchDoc with changes to their schematic content.
    [STM3205P_Controller.SchDoc, STM3205P_DigitalOutputs.SchDoc]
2025-10-15 Update STM32CubeIDE metadata and build outputs
    Refreshed IDE log files, project metadata, and build artifacts for STM3205P. Includes new debug output files for DAC8830 and updates to main.c and related debug objects.
2025-10-23 Added new revision code
    [STM3205P.PrjPcb, STM3205P_DigitalOutputs.SchDoc]
2025-10-25 Finished PCB Review
    [STM3205P_Controller.SchDoc, STM3205P_DigitalOutputs.SchDoc, STM3205P_PCB.PcbDoc]
2025-10-26 Generated File outputs
    [STM3205P_1.1_Main_2025-10-26.xlsx, STM3205P_PCB(Main).step, STM3205P_PCB(Main).x_t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]
2026-04-06 Generated outputs
    [STM3205P_PCB.GBL, STM3205P_PCB.GBO, STM3205P_PCB.GBP, STM3205P_PCB.GBS, STM3205P_PCB.GKO, STM3205P_PCB.GM1, STM3205P_PCB.GTL, STM3205P_PCB.GTO]
2026-05-12 Solved a problem on clang
    [STM3205P_PCB.GBL, STM3205P_PCB.GBO, STM3205P_PCB.GBP, STM3205P_PCB.GBS, STM3205P_PCB.GKO, STM3205P_PCB.GM1, STM3205P_PCB.GTL, STM3205P_PCB.GTO]
2026-05-24 Add Blink display
    [Korad_KA30005P_keyboard.xlsx]
2026-05-26 Added functions to buttons and load memory
2026-05-29 Solved problems with new classes
    [data_types.h, display.c, display.h, flash.h, keyboard.c, main.c]
2026-05-30 Added class button
2026-05-31 added class button in keyboard class
2026-05-31 Finished review with button class
2026-06-01 Added functional blinking led system
2026-06-02 Added measure voltage into display
