lucasmoraeseng/STM3205P/(notices)

Notices in the files:
3.Firmware/STM3205P/Core/Src/main.c:
Copyright (c) 2026 STMicroelectronics.
All rights reserved.
This software is licensed under terms that can be found in the LICENSE file
